haseebulhassan/Project-C/ReferenceMaterial/Test1.txt

NAme, test1
FRequencies, 320
OFfset,  6
ONset,  0
DUration, 65
PEriod, 0
NEgative, 0
UP, 0
inverse, 0
Voltage, 12~30
729331
730442
731553
732664
733775
734886
828108
829219
830330
831441
832552
833663
834774
835885
929107
930218
931329
932440
933551
934662
935773
936884
61529
62640
63751
64862
65973
67084
68195
69306
162529
163640
164751
165862
166973
168084
169195
170306
263529
264640
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
