haseebulhassan/Project-C/Project-C/Project-C_LED/Datasheet/JTAG.JPG

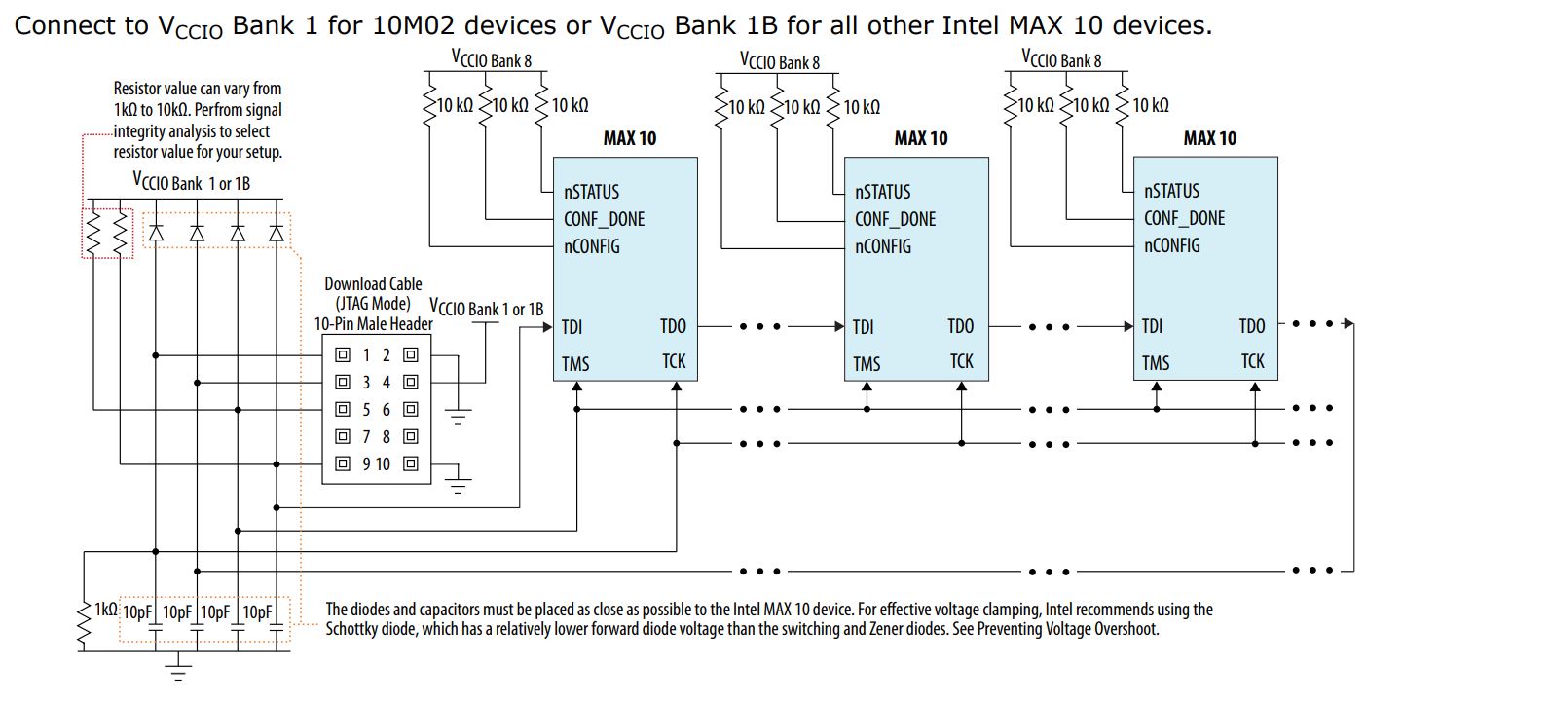
Project-C/Project-C_LED/Datasheet/JTAG.JPG
