haseebulhassan/Project-C/Project-C/Project-C_Controller/Project Outputs for Project-C_CONTOLLER/Project-C_CONTOLLER_BOM.xls

Comment | Description | Designator | Package | Mfr | Mfr Part No | Quantity
0.1uF/16V | Multilayer Ceramic Capacitors MLCC - SMD/SMT 0603 16VDC 0.1uF 10% X7R AEC-Q2000, Multilayer Ceramic Capacitors MLCC - SMD/SMT 0603 16VDC 0.1uF 10% X7R AEC-Q200 | C1, C2, C6, C7, C11, C15, C16, C17, C18, C19, C20, C21, C22, C23, C24, C29, C32, C35, C36, C42, C43, C55, C56, C85 | 0603 | Taiyo Yuden | EMK107B7104KAHT | 24.0
4.7uF/16V | Tantalum Capacitors - Solid SMD 16V 4.7uF 1206 | C3, C9, C40, C41 | 1206 | KEMET | T495A475K016ATA2K0 | 4.0
10pF/50V | Multilayer Ceramic Capacitors MLCC - SMD/SMT 50V 10pF 0603 C0G 5% AEC-Q200 | C4, C5, C76 | 0603 | KEMET | C0603C100J5GACAUTO | 3.0
0.01uF/16V | Multilayer Ceramic Capacitors MLCC - SMD/SMT 16V 0.01uF X7R 0603 10% AEC-Q200 | C8, C44 | 0603 | KEMET | C0603C103K4RECAUTO | 2.0
10uF/25V | Multilayer Ceramic Capacitors MLCC - SMD/SMT 0805 25VDC 10uF 20% X5R | C10, C14, C37 | 0805 | Taiyo Yuden | TMK212BBJ106MG-T | 3.0
1uF/16V | Multilayer Ceramic Capacitors MLCC - SMD/SMT 16volts 1uF X7R 10% | C12, C25, C31, C54 | 0603 | KEMET | C0603C105K4RAC7411 | 4.0
20pF/50V | Multilayer Ceramic Capacitors MLCC - SMD/SMT 50V 20pF 0603 C0G 5% AEC-Q200 | C13, C51, C52, C53 | 0603 | KEMET | C0603C200J5GACAUTO | 4.0
22uF/25V | Multilayer Ceramic Capacitors MLCC - SMD/SMT 1210 25VDC 22uF 20% X7R AEC-Q200 | C26, C30, C33, C34, C74, C75 | 1210 | Taiyo Yuden | TMK325B7226MMHP | 6.0
0.1uF/50V | Multilayer Ceramic Capacitors MLCC - SMD/SMT 50V 0.1uF 0603 X7R 20% | C27, C38_U_BOARD_CONNECTOR_1x_1, C38_U_BOARD_CONNECTOR_1x_2, C38_U_BOARD_CONNECTOR_1x_3, C38_U_BOARD_CONNECTOR_1x_4, C39_U_BOARD_CONNECTOR_1x_1, C39_U_BOARD_CONNECTOR_1x_2, C39_U_BOARD_CONNECTOR_1x_3, C39_U_BOARD_CONNECTOR_1x_4, C45_U_BOARD_CONNECTOR_1x_1, C45_U_BOARD_CONNECTOR_1x_2, C45_U_BOARD_CONNECTOR_1x_3, C45_U_BOARD_CONNECTOR_1x_4, C46_U_BOARD_CONNECTOR_1x_1, C46_U_BOARD_CONNECTOR_1x_2, C46_U_BOARD_CONNECTOR_1x_3, C46_U_BOARD_CONNECTOR_1x_4, C47_U_BOARD_CONNECTOR_1x_1, C47_U_BOARD_CONNECTOR_1x_2, C47_U_BOARD_CONNECTOR_1x_3, C47_U_BOARD_CONNECTOR_1x_4 | 0603 | KEMET | C0603C104M5RACTU | 21.0
1nF/63V | Multilayer Ceramic Capacitors MLCC - SMD/SMT 63V 1000pF 0603 X7R 10% AEC-Q200 | C28 | 0603 | KEMET | 80-C0603C102KMREAUTO | 1.0
2.2uF/50V | Multilayer Ceramic Capacitors MLCC - SMD/SMT 0603 2.2uF 20% 50VDC X5R | C48 | 0603 | Murata Electronics | GRM188R61H225ME11J | 1.0
10uF/63V | Polarized Capacitor (Radial) | C49 | SMD | Panasonic | EEE-FN1J100L | 1.0
47pF/100V | Multilayer Ceramic Capacitors MLCC - SMD/SMT 100V 47pF 0603 X8R 20% AEC-Q200 | C50, C63 | 0603 | KEMET | C0603C470M1HACAUTO | 2.0
6.8nF/50V | Multilayer Ceramic Capacitors MLCC - SMD/SMT 0603 50VDC 6.8nF 5% C0G AEC-Q200 | C73 | 0603 | TDK | CGA3E2C0G1H682J080AE | 1.0
4.7nF/50V | Multilayer Ceramic Capacitors MLCC - SMD/SMT 50V 4700pF X7R 0603 10% AEC-Q200 | C86 | 0603 | KEMET | C0603C472K5RACAUTO7411 | 1.0
1N4148 | Diodes - General Purpose, Power, Switching 400mW 100Vrrm 4ns | D1, D2 | SOD-123-2 | Diodes Incorporated | 1N4148W-13-F | 2.0
LEDR | Standard LEDs - SMD Red 631nm 14mcd 5mA | D3, D4, D5, D6, D7_U_BOARD_CONNECTOR_1x_1, D7_U_BOARD_CONNECTOR_1x_2, D7_U_BOARD_CONNECTOR_1x_3, D7_U_BOARD_CONNECTOR_1x_4, D8_U_BOARD_CONNECTOR_1x_1, D8_U_BOARD_CONNECTOR_1x_2, D8_U_BOARD_CONNECTOR_1x_3, D8_U_BOARD_CONNECTOR_1x_4, D9, D10 | 0603 | Lite On | LTST-C193KRKT-5A | 14.0
Mini USB | USB Connectors M-USB 1X1 B/REC R/A SMT | J1 |  | TE Connectivity | 1734035-2 | 1.0
PJ-002BH | Connector | J2 |  |  | PJ-002BH | 1.0
101 | Coin Cell Battery Holders 20mm coin cell HOLDER | J3 |  |  | 101 | 1.0
DM3AT-SF-PEJM5 | Memory Card Connectors R/A SMT MICROSD CON PUSH-PUSH TOP BRDMNT | J4 |  | Hirose Connector | DM3AT-SF-PEJM5 | 1.0
RJHSE-5381 | Modular Connectors / Ethernet Connectors R/A RJ45 SHEILDED 8 CONT Y/G LEDS | J5_U_BOARD_CONNECTOR_1x_1, J5_U_BOARD_CONNECTOR_1x_2, J5_U_BOARD_CONNECTOR_1x_3, J5_U_BOARD_CONNECTOR_1x_4, J6_U_BOARD_CONNECTOR_1x_1, J6_U_BOARD_CONNECTOR_1x_2, J6_U_BOARD_CONNECTOR_1x_3, J6_U_BOARD_CONNECTOR_1x_4 |  | Amphenol Commercial Products | RJHSE-5381 | 8.0
ER-CON40HB-2 | 40 Pin 1.0mm Pitch Bottom Contact ZIF Connector,FPC Connector | J7 |  |  |  | 1.0
100R,1A | Ferrite Beads 100ohms 1A 60mOhms 0603 Ferrite Chip | L2, L4 | 0603 | TDK | MPZ1608D101BTA00 | 2.0
2.2uH | Fixed Inductors 2.2uH 20% High Temp AEC-Q200 | L6 |  | Vishay / Dale | IHLP1616BZER2R2M5A | 1.0
LCD320X480 |  | LCD1 |  | Buy LCD | ER-TFTM035-6 | 1.0
Program | Header, 5-Pin, Dual row | P1 |  |  |  | 1.0
POWER |  | P2 |  |  |  | 1.0
Enable |  | P3 |  |  |  | 1.0
10K | Thick Film Resistors - SMD 0603 10Kohms 1% Anti-Sulfur AEC-Q200 | R1, R4, R5, R6, R7, R8, R10, R11, R12, R13, R14, R15, R16, R17, R20, R21, R25, R26, R27, R28_U_BOARD_CONNECTOR_1x_1, R28_U_BOARD_CONNECTOR_1x_2, R28_U_BOARD_CONNECTOR_1x_3, R28_U_BOARD_CONNECTOR_1x_4, R29_U_BOARD_CONNECTOR_1x_1, R29_U_BOARD_CONNECTOR_1x_2, R29_U_BOARD_CONNECTOR_1x_3, R29_U_BOARD_CONNECTOR_1x_4, R38, R43 | 0603 | ROHM Semiconductor | SFR03EZPF1002 | 29.0
1K | Resistor | R2, R3 | 0603 | Vishay / Dale | CRCW06031K00FKEAC | 2.0
0R | Thick Film Resistors - SMD 1/10Watt 0ohms Commercial Use | R9, R24 | 0603 | Vishay / Dale | CRCW06030000Z0EAC | 2.0
27R | Thick Film Resistors - SMD 0603 0.25W 1% 27ohm AEC-Q200 | R18, R19 | 0603 | Panasonic | ERJ-UP3F27R0V | 2.0
1M | Thick Film Resistors - SMD 0603 0.25W 1% 1Mohm AEC-Q200 | R22, R36 | 0603 | Panasonic | ERJ-UP3F1004V | 2.0
4.7K | Thick Film Resistors - SMD 1/10Watt 4.7Kohms 5% Commercial Use | R23 | 0603 | Vishay / Dale | CRCW06034K70JNEAC | 1.0
220R | Thick Film Resistors - SMD 1/10Watt 220ohms 5% Commercial Use | R30, R31, R32, R33, R34_U_BOARD_CONNECTOR_1x_1, R34_U_BOARD_CONNECTOR_1x_2, R34_U_BOARD_CONNECTOR_1x_3, R34_U_BOARD_CONNECTOR_1x_4, R35_U_BOARD_CONNECTOR_1x_1, R35_U_BOARD_CONNECTOR_1x_2, R35_U_BOARD_CONNECTOR_1x_3, R35_U_BOARD_CONNECTOR_1x_4, R37, R39 | 0603 | Vishay / Dale | CRCW0603220RJNEAC | 14.0
40.2K | Thick Film Resistors - SMD 0603 Anti-Surge Res. 0.1%, 40.2Koh | R44 | 0603 | Panasonic | ERJ-PB3B4022V | 1.0
7.68K | Thick Film Resistors - SMD 0603 Anti-Surge Res. 0.1%, 7.68Koh | R45 | 0603 | Panasonic | ERJ-PB3B7681V | 1.0
604K | Thick Film Resistors - SMD 0603 1% 604Kohm Anti-Sulfur AEC-Q200 | R52 | 0603 | Panasonic | ERJ-U03F6043V | 1.0
20R | Thick Film Resistors - SMD 0603 0.25W 1% 20ohm AEC-Q200 | R53 | 0603 | Panasonic | ERJ-UP3F20R0V | 1.0
MCP79400 | Real Time Clock I2C GP RTCC 64B SRAM ID | U1 |  | Microchip Technology | MCP79400-I/SN | 1.0
FT230XS-R | USB Interface IC USB to Basic Serial UART IC SSOP-16 | U2 |  | FTDI | FT230XS-R | 1.0
S25FL064LABMFI013 | NOR Flash Nor | U3 |  | Cypress Semiconductor | S25FL064LABMFI013 | 1.0
ADG708BRUZ | Multiplexer Switch ICs 8-CHANNEL MUX | U4, U8, U9, U10 |  | Analog Devices | ADG708BRUZ | 4.0
STM32F101RBT6 | ARM Microcontrollers - MCU 32BIT Cortex M3 128K 16KB RAM 1X12 ADC | U5 |  | STMicroelectronics | STM32F101RBT6 | 1.0
MP2333HGTL | Switching Voltage Regulators High-Efficiency, 3A, 18V, 1200kHz, Synchronous, Step-Down Converter | U6 |  | Monolithic Power Systems (MPS) | MP2333HGTL-P | 1.0
LD1085D2T33R | Integrated Circuit | U7 |  | STMicroelectronics | LD1085D2T33R | 1.0
TMCS1101A2BQDT | Board Mount Current Sensors Precision isolated current sensor with internal reference 8-SOIC -40 to 125 | U11 |  | Texas Instruments | TMCS1101A2BQDT | 1.0
ESP32-WROOM-32E_M113EH3200PH3Q0_ | Integrated Circuit | U12 |  | Espressif Systems | ESP32-WROOM-32E(M113EH3200PH3Q0) | 1.0
MAX3232CPWR | RS-232 Interface IC 3-5.5V Mult-Ch RS232 | U13_U_BOARD_CONNECTOR_1x_1, U13_U_BOARD_CONNECTOR_1x_2, U13_U_BOARD_CONNECTOR_1x_3, U13_U_BOARD_CONNECTOR_1x_4 |  | Texas Instruments | MAX3232CPWR | 4.0
AB26T-32.768KHZ-6 | Crystals 32.768KHz 6pF 32.768KHZ | X1 |  | ABRACON | AB26T-32.768KHZ-6 | 1.0
FC-135R 32.7680KA-AC | Crystals SMD XTL KHZ +/-20PPM,-40 85C 9.0PF BULK | X2 |  | Epson Timing | FC-135R 32.7680KA-AC | 1.0
ECS-080-20-5PX-TR | Crystals 8MHz 20pF -10C +70C | X3 |  | ECS | ECS-080-20-5PX-TR | 1.0
