haseebulhassan/Project-C/Project-C/Project-C_LED/Project Outputs for Project-C_LED/Project-C_LED_BOM.xls

Comment | Description | Designator | Package | Mfr | Mfr Part No | Quantity
0.1uF/16V | Multilayer Ceramic Capacitors MLCC - SMD/SMT 0603 16VDC 0.1uF 10% X7R AEC-Q200 | C1_IO1, C1_IO2, C1_IO3, C1_IO4, C4_POWER1, C4_POWER2, C4_POWER3, C4_POWER4, C5_POWER1, C5_POWER2, C5_POWER3, C5_POWER4, C6_POWER1, C6_POWER2, C6_POWER3, C6_POWER4, C9_POWER1, C9_POWER2, C9_POWER3, C9_POWER4, C12_POWER1, C12_POWER2, C12_POWER3, C12_POWER4, C13_POWER1, C13_POWER2, C13_POWER3, C13_POWER4, C15_POWER1, C15_POWER2, C15_POWER3, C15_POWER4, C16_POWER1, C16_POWER2, C16_POWER3, C16_POWER4, C17_POWER1, C17_POWER2, C17_POWER3, C17_POWER4, C23_POWER1, C23_POWER2, C23_POWER3, C23_POWER4, C24_POWER1, C24_POWER2, C24_POWER3, C24_POWER4, C28_U_LED_BUFFER11, C28_U_LED_BUFFER12, C28_U_LED_BUFFER13, C28_U_LED_BUFFER14, C28_U_LED_BUFFER21, C28_U_LED_BUFFER22, C28_U_LED_BUFFER23, C28_U_LED_BUFFER24, C28_U_LED_BUFFER31, C28_U_LED_BUFFER32, C28_U_LED_BUFFER33, C28_U_LED_BUFFER34, C28_U_LED_BUFFER41, C28_U_LED_BUFFER42, C28_U_LED_BUFFER43, C28_U_LED_BUFFER44, C28_U_LED_BUFFER51, C28_U_LED_BUFFER52, C28_U_LED_BUFFER53, C28_U_LED_BUFFER54, C28_U_LED_BUFFER61, C28_U_LED_BUFFER62, C28_U_LED_BUFFER63, C28_U_LED_BUFFER64, C28_U_LED_BUFFER71, C28_U_LED_BUFFER72, C28_U_LED_BUFFER73, C28_U_LED_BUFFER74, C28_U_LED_BUFFER81, C28_U_LED_BUFFER82, C28_U_LED_BUFFER83, C28_U_LED_BUFFER84, C28_U_LED_BUFFER91, C28_U_LED_BUFFER92, C28_U_LED_BUFFER93, C28_U_LED_BUFFER94, C28_U_LED_BUFFER101, C28_U_LED_BUFFER102, C28_U_LED_BUFFER103, C28_U_LED_BUFFER104, C31_U_LED_BUFFER11, C31_U_LED_BUFFER12, C31_U_LED_BUFFER13, C31_U_LED_BUFFER14, C31_U_LED_BUFFER21, C31_U_LED_BUFFER22, C31_U_LED_BUFFER23, C31_U_LED_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 | 0603 | Taiyo Yuden | EMK107B7104KAHT | 228.0
0.01uF/16V | Multilayer Ceramic Capacitors MLCC - SMD/SMT 16V 0.01uF X7R 0603 10% AEC-Q200 | C2_POWER1, C2_POWER2, C2_POWER3, C2_POWER4, C3_POWER1, C3_POWER2, C3_POWER3, C3_POWER4, C53_POWER1, C53_POWER2, C53_POWER3, C53_POWER4 | 0603 | KEMET | C0603C103K4RECAUTO | 12.0
0.47uF/16V | Multilayer Ceramic Capacitors MLCC - SMD/SMT 16V 0.47uF 0603 X7R 5% AEC-Q200 | C7_POWER1, C7_POWER2, C7_POWER3, C7_POWER4, C47_POWER1, C47_POWER2, C47_POWER3, C47_POWER4, C54_POWER1, C54_POWER2, C54_POWER3, C54_POWER4, C68_POWER1, C68_POWER2, C68_POWER3, C68_POWER4 | 0603 | KEMET | C0603C474J4RACAUTO | 16.0
10uF/25V | Multilayer Ceramic Capacitors MLCC - SMD/SMT 0805 25VDC 10uF 20% X5R | C10_POWER1, C10_POWER2, C10_POWER3, C10_POWER4, C46_POWER1, C46_POWER2, C46_POWER3, C46_POWER4, C55_POWER1, C55_POWER2, C55_POWER3, C55_POWER4, C69_POWER1, C69_POWER2, C69_POWER3, C69_POWER4, C70_POWER1, C70_POWER2, C70_POWER3, C70_POWER4 | 0805 | Taiyo Yuden | TMK212BBJ106MG-T | 20.0
22uF/10V | Multilayer Ceramic Capacitors MLCC - SMD/SMT 1210 25VDC 22uF 20% X7R AEC-Q200 | C11_POWER1, C11_POWER2, C11_POWER3, C11_POWER4, C56_POWER1, C56_POWER2, C56_POWER3, C56_POWER4, C71_POWER1, C71_POWER2, C71_POWER3, C71_POWER4, C72_POWER1, C72_POWER2, C72_POWER3, C72_POWER4 | 0603 | TDK | C1608X5R1A226M080AC | 16.0
1uF/16V | Multilayer Ceramic Capacitors MLCC - SMD/SMT 16volts 1uF X7R 10% | C18, C33_U_LED_BUFFER11, C33_U_LED_BUFFER12, C33_U_LED_BUFFER13, C33_U_LED_BUFFER14, C33_U_LED_BUFFER21, C33_U_LED_BUFFER22, C33_U_LED_BUFFER23, C33_U_LED_BUFFER24, C33_U_LED_BUFFER31, C33_U_LED_BUFFER32, C33_U_LED_BUFFER33, C33_U_LED_BUFFER34, C33_U_LED_BUFFER41, C33_U_LED_BUFFER42, C33_U_LED_BUFFER43, C33_U_LED_BUFFER44, C33_U_LED_BUFFER51, C33_U_LED_BUFFER52, C33_U_LED_BUFFER53, C33_U_LED_BUFFER54, C33_U_LED_BUFFER61, C33_U_LED_BUFFER62, C33_U_LED_BUFFER63, C33_U_LED_BUFFER64, C33_U_LED_BUFFER71, C33_U_LED_BUFFER72, C33_U_LED_BUFFER73, C33_U_LED_BUFFER74, C33_U_LED_BUFFER81, C33_U_LED_BUFFER82, C33_U_LED_BUFFER83, C33_U_LED_BUFFER84, C33_U_LED_BUFFER91, C33_U_LED_BUFFER92, C33_U_LED_BUFFER93, C33_U_LED_BUFFER94, C33_U_LED_BUFFER101, C33_U_LED_BUFFER102, C33_U_LED_BUFFER103, C33_U_LED_BUFFER104, C34_U_LED_BUFFER11, C34_U_LED_BUFFER12, C34_U_LED_BUFFER13, C34_U_LED_BUFFER14, C34_U_LED_BUFFER21, C34_U_LED_BUFFER22, C34_U_LED_BUFFER23, C34_U_LED_BUFFER24, C34_U_LED_BUFFER31, C34_U_LED_BUFFER32, C34_U_LED_BUFFER33, C34_U_LED_BUFFER34, C34_U_LED_BUFFER41, C34_U_LED_BUFFER42, C34_U_LED_BUFFER43, C34_U_LED_BUFFER44, C34_U_LED_BUFFER51, C34_U_LED_BUFFER52, C34_U_LED_BUFFER53, C34_U_LED_BUFFER54, C34_U_LED_BUFFER61, C34_U_LED_BUFFER62, C34_U_LED_BUFFER63, C34_U_LED_BUFFER64, C34_U_LED_BUFFER71, C34_U_LED_BUFFER72, C34_U_LED_BUFFER73, C34_U_LED_BUFFER74, C34_U_LED_BUFFER81, C34_U_LED_BUFFER82, C34_U_LED_BUFFER83, C34_U_LED_BUFFER84, C34_U_LED_BUFFER91, C34_U_LED_BUFFER92, C34_U_LED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 | 0603 | KEMET | C0603C105K4RAC7411, C0603C105K4RACTU | 121.0
22uF/25V | Multilayer Ceramic Capacitors MLCC - SMD/SMT 1210 25VDC 22uF 20% X7R AEC-Q200 | C19, C26, C27, C29, C30 | 1210 | Taiyo Yuden | TMK325B7226MMHP | 5.0
0.1uF/50V | Multilayer Ceramic Capacitors MLCC - SMD/SMT 50V 0.1uF 0603 X7R 20% | C20, C40, C41, C42, C43, C44 | 0603 | KEMET | C0603C104M5RACTU | 6.0
1nF/63V | Multilayer Ceramic Capacitors MLCC - SMD/SMT 63V 1000pF 0603 X7R 10% AEC-Q200 | C21 | 0603 | KEMET | 80-C0603C102KMREAUTO | 1.0
6.8nF/50V | Multilayer Ceramic Capacitors MLCC - SMD/SMT 0603 50VDC 6.8nF 5% C0G AEC-Q200 | C22 | 0603 | TDK | CGA3E2C0G1H682J080AE | 1.0
10pF/50V | Multilayer Ceramic Capacitors MLCC - SMD/SMT 50V 10pF 0603 C0G 5% AEC-Q200 | C25, C36, C37, C38, C39 | 0603 | KEMET | C0603C100J5GACAUTO | 5.0
10uF/63V | Polarized Capacitor (Radial) | C73, C76, C79 | SMD | Panasonic | EEE-FN1J100L | 3.0
2.2uF/50V | Multilayer Ceramic Capacitors MLCC - SMD/SMT 0603 2.2uF 20% 50VDC X5R | C74, C75, C77, C78 | 0603 | Murata Electronics | GRM188R61H225ME11J | 4.0
LEDR | Standard LEDs - SMD Red 631nm 14mcd 5mA | D1_IO1, D1_IO2, D1_IO3, D1_IO4, D2_IO1, D2_IO2, D2_IO3, D2_IO4, D3 | 0603 | Lite-On | LTST-C193KRKT-5A | 9.0
V8PAM10S-M3_H | Schottky Diodes & Rectifiers 8A 100V | D4, D5, D6 |  | Vishay General Semiconductor | V8PAM10S-M3/H | 3.0
LEDG | Standard LEDs - SMD Grn 527nm; 140mcd 0603; 70mW | D7_U_LED_BUFFER11, D7_U_LED_BUFFER12, D7_U_LED_BUFFER13, D7_U_LED_BUFFER14, D7_U_LED_BUFFER21, D7_U_LED_BUFFER22, D7_U_LED_BUFFER23, D7_U_LED_BUFFER24, D7_U_LED_BUFFER31, D7_U_LED_BUFFER32, D7_U_LED_BUFFER33, D7_U_LED_BUFFER34, D7_U_LED_BUFFER41, D7_U_LED_BUFFER42, D7_U_LED_BUFFER43, D7_U_LED_BUFFER44, D7_U_LED_BUFFER51, D7_U_LED_BUFFER52, D7_U_LED_BUFFER53, D7_U_LED_BUFFER54, D7_U_LED_BUFFER61, D7_U_LED_BUFFER62, D7_U_LED_BUFFER63, D7_U_LED_BUFFER64, D7_U_LED_BUFFER71, D7_U_LED_BUFFER72, D7_U_LED_BUFFER73, D7_U_LED_BUFFER74, D7_U_LED_BUFFER81, D7_U_LED_BUFFER82, D7_U_LED_BUFFER83, D7_U_LED_BUFFER84, D7_U_LED_BUFFER91, D7_U_LED_BUFFER92, D7_U_LED_BUFFER93, D7_U_LED_BUFFER94, D7_U_LED_BUFFER101, D7_U_LED_BUFFER102, D7_U_LED_BUFFER103, D7_U_LED_BUFFER104, D8_U_LED_BUFFER11, D8_U_LED_BUFFER12, D8_U_LED_BUFFER13, D8_U_LED_BUFFER14, D8_U_LED_BUFFER21, D8_U_LED_BUFFER22, D8_U_LED_BUFFER23, D8_U_LED_BUFFER24, D8_U_LED_BUFFER31, D8_U_LED_BUFFER32, D8_U_LED_BUFFER33, D8_U_LED_BUFFER34, D8_U_LED_BUFFER41, D8_U_LED_BUFFER42, D8_U_LED_BUFFER43, D8_U_LED_BUFFER44, D8_U_LED_BUFFER51, D8_U_LED_BUFFER52, D8_U_LED_BUFFER53, D8_U_LED_BUFFER54, D8_U_LED_BUFFER61, D8_U_LED_BUFFER62, D8_U_LED_BUFFER63, D8_U_LED_BUFFER64, D8_U_LED_BUFFER71, D8_U_LED_BUFFER72, D8_U_LED_BUFFER73, D8_U_LED_BUFFER74, D8_U_LED_BUFFER81, D8_U_LED_BUFFER82, D8_U_LED_BUFFER83, D8_U_LED_BUFFER84, D8_U_LED_BUFFER91, D8_U_LED_BUFFER92, D8_U_LED_BUFFER93, D8_U_LED_BUFFER94, D8_U_LED_BUFFER101, D8_U_LED_BUFFER102, D8_U_LED_B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 | 0603 | ROHM Semiconductor | SMLD12EN1WT86 | 320.0
RJHSE-5381 | Modular Connectors / Ethernet Connectors R/A RJ45 SHEILDED 8 CONT Y/G LEDS | J1 |  | Amphenol Commercial Products | RJHSE-5381 | 1.0
PJ-002BH | DC Power Connectors Power Jacks | J2 |  | CUI Devices | PJ-002BH | 1.0
100R,1A | Ferrite Beads 100ohms 1A 60mOhms 0603 Ferrite Chip | L1_POWER1, L1_POWER2, L1_POWER3, L1_POWER4, L3_POWER1, L3_POWER2, L3_POWER3, L3_POWER4 | 0603 | TDK | MPZ1608D101BTA00 | 8.0
2.2uH | Fixed Inductors 2.2uH 20% High Temp AEC-Q200 | L4 |  | Vishay / Dale | IHLP1616BZER2R2M5A | 1.0
10M04SC E144 | FPGA - Field Programmable Gate Array non-volatile FPGA, 101 I/O, 144EQFP | P1_IO1, P1_IO2, P1_IO3, P1_IO4 | EQFP144 | Intel / Altera | 10M04SCE144C8G | 4.0
10K | Thick Film Resistors - SMD 0603 10Kohms 1% Anti-Sulfur AEC-Q200 | R1_IO1, R1_IO2, R1_IO3, R1_IO4, R2_IO1, R2_IO2, R2_IO3, R2_IO4, R3_IO1, R3_IO2, R3_IO3, R3_IO4, R4_IO1, R4_IO2, R4_IO3, R4_IO4, R5_IO1, R5_IO2, R5_IO3, R5_IO4, R6_IO1, R6_IO2, R6_IO3, R6_IO4, R7_IO1, R7_IO2, R7_IO3, R7_IO4, R10, R11, R23, R24, R25, R28, R30, R31, R32, R33, R34, R44 | 0603 | ROHM Semiconductor | SFR03EZPF1002 | 40.0
220R | Thick Film Resistors - SMD 1/10Watt 220ohms 5% Commercial Use | R8_IO1, R8_IO2, R8_IO3, R8_IO4, R21_IO1, R21_IO2, R21_IO3, R21_IO4 | 0603 | Vishay / Dale | CRCW0603220RJNEAC | 8.0
330R | Thick Film Resistors - SMD 1/10Watt 330ohms 1% Commercial Use | R9_U_LED_BUFFER11, R9_U_LED_BUFFER12, R9_U_LED_BUFFER13, R9_U_LED_BUFFER14, R9_U_LED_BUFFER21, R9_U_LED_BUFFER22, R9_U_LED_BUFFER23, R9_U_LED_BUFFER24, R9_U_LED_BUFFER31, R9_U_LED_BUFFER32, R9_U_LED_BUFFER33, R9_U_LED_BUFFER34, R9_U_LED_BUFFER41, R9_U_LED_BUFFER42, R9_U_LED_BUFFER43, R9_U_LED_BUFFER44, R9_U_LED_BUFFER51, R9_U_LED_BUFFER52, R9_U_LED_BUFFER53, R9_U_LED_BUFFER54, R9_U_LED_BUFFER61, R9_U_LED_BUFFER62, R9_U_LED_BUFFER63, R9_U_LED_BUFFER64, R9_U_LED_BUFFER71, R9_U_LED_BUFFER72, R9_U_LED_BUFFER73, R9_U_LED_BUFFER74, R9_U_LED_BUFFER81, R9_U_LED_BUFFER82, R9_U_LED_BUFFER83, R9_U_LED_BUFFER84, R9_U_LED_BUFFER91, R9_U_LED_BUFFER92, R9_U_LED_BUFFER93, R9_U_LED_BUFFER94, R9_U_LED_BUFFER101, R9_U_LED_BUFFER102, R9_U_LED_BUFFER103, R9_U_LED_BUFFER104, R17_U_LED_BUFFER11, R17_U_LED_BUFFER12, R17_U_LED_BUFFER13, R17_U_LED_BUFFER14, R17_U_LED_BUFFER21, R17_U_LED_BUFFER22, R17_U_LED_BUFFER23, R17_U_LED_BUFFER24, R17_U_LED_BUFFER31, R17_U_LED_BUFFER32, R17_U_LED_BUFFER33, R17_U_LED_BUFFER34, R17_U_LED_BUFFER41, R17_U_LED_BUFFER42, R17_U_LED_BUFFER43, R17_U_LED_BUFFER44, R17_U_LED_BUFFER51, R17_U_LED_BUFFER52, R17_U_LED_BUFFER53, R17_U_LED_BUFFER54, R17_U_LED_BUFFER61, R17_U_LED_BUFFER62, R17_U_LED_BUFFER63, R17_U_LED_BUFFER64, R17_U_LED_BUFFER71, R17_U_LED_BUFFER72, R17_U_LED_BUFFER73, R17_U_LED_BUFFER74, R17_U_LED_BUFFER81, R17_U_LED_BUFFER82, R17_U_LED_BUFFER83, R17_U_LED_BUFFER84, R17_U_LED_BUFFER91, R17_U_LED_BUFFER92, R17_U_LED_BUFFER93, R17_U_LED_BUFFER94, R17_U_LED_BUFF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 | 0603 | Vishay / Dale | CRCW0603330RFKEAC | 320.0
1K | Resistor | R12, R13_IO1, R13_IO2, R13_IO3, R13_IO4, R38, R43 | 0603 | Vishay / Dale | CRCW06031K00FKEAC | 7.0
4.7K | Thick Film Resistors - SMD 1/10Watt 4.7Kohms 5% Commercial Use | R14_IO1, R14_IO2, R14_IO3, R14_IO4, R20_IO1, R20_IO2, R20_IO3, R20_IO4 | 0603 | Vishay / Dale | CRCW06034K70JNEAC | 8.0
604K | Thick Film Resistors - SMD 0603 1% 604Kohm Anti-Sulfur AEC-Q200 | R15 | 0603 | Panasonic | ERJ-U03F6043V | 1.0
20R | Thick Film Resistors - SMD 0603 0.25W 1% 20ohm AEC-Q200 | R16 | 0603 | Panasonic | ERJ-UP3F20R0V | 1.0
40.2K | Thick Film Resistors - SMD 0603 Anti-Surge Res. 0.1%, 40.2Koh | R18, R36, R42 | 0603 | Panasonic | ERJ-PB3B4022V | 3.0
7.68K | Thick Film Resistors - SMD 0603 Anti-Surge Res. 0.1%, 7.68Koh | R29 | 0603 | Panasonic | ERJ-PB3B7681V | 1.0
13K | Thin Film Resistors - SMD 13K ohm 0.1% 25 ppm | R35, R39, R41 | 0603 | KOA Speer | RN73R1JTTD1302B25 | 3.0
2K | Thick Film Resistors - SMD 0603 10Kohms 1% Anti-Sulfur AEC-Q200 | R37 | 0603 | ROHM Semiconductor | SFR03EZPF1002 | 1.0
20K | Thick Film Resistors - SMD 20K OHM .1% 25PPM | R40 | 0603 | KOA Speer | RS73F1JTTD2002B | 1.0
33R | Thick Film Resistors - SMD 1/10Watt 33ohms 1% Commercial Use | R47_U_LED_BUFFER11, R47_U_LED_BUFFER12, R47_U_LED_BUFFER13, R47_U_LED_BUFFER14, R47_U_LED_BUFFER21, R47_U_LED_BUFFER22, R47_U_LED_BUFFER23, R47_U_LED_BUFFER24, R47_U_LED_BUFFER31, R47_U_LED_BUFFER32, R47_U_LED_BUFFER33, R47_U_LED_BUFFER34, R47_U_LED_BUFFER41, R47_U_LED_BUFFER42, R47_U_LED_BUFFER43, R47_U_LED_BUFFER44, R47_U_LED_BUFFER51, R47_U_LED_BUFFER52, R47_U_LED_BUFFER53, R47_U_LED_BUFFER54, R47_U_LED_BUFFER61, R47_U_LED_BUFFER62, R47_U_LED_BUFFER63, R47_U_LED_BUFFER64, R47_U_LED_BUFFER71, R47_U_LED_BUFFER72, R47_U_LED_BUFFER73, R47_U_LED_BUFFER74, R47_U_LED_BUFFER81, R47_U_LED_BUFFER82, R47_U_LED_BUFFER83, R47_U_LED_BUFFER84, R47_U_LED_BUFFER91, R47_U_LED_BUFFER92, R47_U_LED_BUFFER93, R47_U_LED_BUFFER94, R47_U_LED_BUFFER101, R47_U_LED_BUFFER102, R47_U_LED_BUFFER103, R47_U_LED_BUFFER104, R48_U_LED_BUFFER11, R48_U_LED_BUFFER12, R48_U_LED_BUFFER13, R48_U_LED_BUFFER14, R48_U_LED_BUFFER21, R48_U_LED_BUFFER22, R48_U_LED_BUFFER23, R48_U_LED_BUFFER24, R48_U_LED_BUFFER31, R48_U_LED_BUFFER32, R48_U_LED_BUFFER33, R48_U_LED_BUFFER34, R48_U_LED_BUFFER41, R48_U_LED_BUFFER42, R48_U_LED_BUFFER43, R48_U_LED_BUFFER44, R48_U_LED_BUFFER51, R48_U_LED_BUFFER52, R48_U_LED_BUFFER53, R48_U_LED_BUFFER54, R48_U_LED_BUFFER61, R48_U_LED_BUFFER62, R48_U_LED_BUFFER63, R48_U_LED_BUFFER64, R48_U_LED_BUFFER71, R48_U_LED_BUFFER72, R48_U_LED_BUFFER73, R48_U_LED_BUFFER74, R48_U_LED_BUFFER81, R48_U_LED_BUFFER82, R48_U_LED_BUFFER83, R48_U_LED_BUFFER84, R48_U_LED_BUFFER91, R48_U_LED_BUFFER92, R48_U_LED_BUFF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 | 0603 | Vishay / Dale | CRCW060333R0FKEAC | 320.0
OSC-25 | Standard Clock Oscillators 25.0 MHZ 3.3V 50PPM SMD 32 | U1_IO1, U1_IO2, U1_IO3, U1_IO4 |  | ABRACON | ASE-25.000MHZ-LC-T | 4.0
MAX3232CPWR | RS-232 Interface IC 3-5.5V Mult-Ch RS232 | U2 |  | Texas Instruments | MAX3232CPWR | 1.0
MP2333HGTL | Switching Voltage Regulators High-Efficiency, 3A, 18V, 1200kHz, Synchronous, Step-Down Converter | U3 |  | Monolithic Power Systems (MPS) | MP2333HGTL-P | 1.0
NTS0308 | Translation - Voltage Levels Dual supply translating transceiver; open drain; auto direction sensing | U4_U_LED_BUFFER11, U4_U_LED_BUFFER12, U4_U_LED_BUFFER13, U4_U_LED_BUFFER14, U4_U_LED_BUFFER21, U4_U_LED_BUFFER22, U4_U_LED_BUFFER23, U4_U_LED_BUFFER24, U4_U_LED_BUFFER31, U4_U_LED_BUFFER32, U4_U_LED_BUFFER33, U4_U_LED_BUFFER34, U4_U_LED_BUFFER41, U4_U_LED_BUFFER42, U4_U_LED_BUFFER43, U4_U_LED_BUFFER44, U4_U_LED_BUFFER51, U4_U_LED_BUFFER52, U4_U_LED_BUFFER53, U4_U_LED_BUFFER54, U4_U_LED_BUFFER61, U4_U_LED_BUFFER62, U4_U_LED_BUFFER63, U4_U_LED_BUFFER64, U4_U_LED_BUFFER71, U4_U_LED_BUFFER72, U4_U_LED_BUFFER73, U4_U_LED_BUFFER74, U4_U_LED_BUFFER81, U4_U_LED_BUFFER82, U4_U_LED_BUFFER83, U4_U_LED_BUFFER84, U4_U_LED_BUFFER91, U4_U_LED_BUFFER92, U4_U_LED_BUFFER93, U4_U_LED_BUFFER94, U4_U_LED_BUFFER101, U4_U_LED_BUFFER102, U4_U_LED_BUFFER103, U4_U_LED_BUFFER104 |  | NXP Semiconductors | NTS0308EPWJ | 40.0
TPS2121 | Power Switch ICs - Power Distribution | U5 |  | Texas Instruments | TPS2121RUXT | 1.0
LD1085D2T33R | Integrated Circuit | U6 |  | STMicroelectronics | LD1085D2T33R | 1.0
74LV540APWJ | Buffers & Line Drivers BUFFER LINE DRIVER | U7_U_LED_BUFFER11, U7_U_LED_BUFFER12, U7_U_LED_BUFFER13, U7_U_LED_BUFFER14, U7_U_LED_BUFFER21, U7_U_LED_BUFFER22, U7_U_LED_BUFFER23, U7_U_LED_BUFFER24, U7_U_LED_BUFFER31, U7_U_LED_BUFFER32, U7_U_LED_BUFFER33, U7_U_LED_BUFFER34, U7_U_LED_BUFFER41, U7_U_LED_BUFFER42, U7_U_LED_BUFFER43, U7_U_LED_BUFFER44, U7_U_LED_BUFFER51, U7_U_LED_BUFFER52, U7_U_LED_BUFFER53, U7_U_LED_BUFFER54, U7_U_LED_BUFFER61, U7_U_LED_BUFFER62, U7_U_LED_BUFFER63, U7_U_LED_BUFFER64, U7_U_LED_BUFFER71, U7_U_LED_BUFFER72, U7_U_LED_BUFFER73, U7_U_LED_BUFFER74, U7_U_LED_BUFFER81, U7_U_LED_BUFFER82, U7_U_LED_BUFFER83, U7_U_LED_BUFFER84, U7_U_LED_BUFFER91, U7_U_LED_BUFFER92, U7_U_LED_BUFFER93, U7_U_LED_BUFFER94, U7_U_LED_BUFFER101, U7_U_LED_BUFFER102, U7_U_LED_BUFFER103, U7_U_LED_BUFFER104 | TSSOP-20 | Nexperia | 74LV540APWJ | 40.0
NUP4114 | ESD Suppressors / TVS Diodes LOW CAP TVS ARRAY 5.5V | U8 |  | ON SEMI | NUP4114HMR6T1G | 1.0
74HC151DB,118 | Encoders, Decoders, Multiplexers & Demultiplexers 8-INPUT MULTIPLEXER | U14 |  | NEXPERIA | 74HC151DB,118 | 1.0
