haseebulhassan/Project-C/Project-C/Project-C_Voltage/Project Outputs for Project-C_VOLTAGE/VOLTAGE_BOM.xls

Comment | Description | Designator | Package | Mfr | Mfr Part No | Quantity
180K | Thin Film Resistors - SMD 180K ohm 0.1% 50 ppm | R45 | 0603 | KOA Speer | RN73R1JTTD1803B50 | 1.0
50.5K | Thin Film Resistors - SMD 50.5kOhm,0603,0.1%,2 5ppm,63mW,50V | R9 | 0603 | KOA Speer | RN731JTTD5052B25 | 1.0
13K | Thin Film Resistors - SMD 13K ohm 0.1% 25 ppm | R35, R39, R41, R46 | 0603 | KOA Speer | RN73R1JTTD1302B25 | 4.0
40.2K | Thick Film Resistors - SMD 0603 Anti-Surge Res. 0.1%, 40.2Koh | R18, R36, R42 | 0603 | Panasonic | ERJ-PB3B4022V | 3.0
7.68K | Thick Film Resistors - SMD 0603 Anti-Surge Res. 0.1%, 7.68Koh | R19 | 0603 | Panasonic | ERJ-PB3B7681V | 1.0
86.6K | Thick Film Resistors - SMD 0603 86.6Kohms 1% AEC-Q200 | R48 | 0603 | Panasonic | ERJ-3EKF8662V | 1.0
2K | Thick Film Resistors - SMD 0603 10Kohms 1% Anti-Sulfur AEC-Q200 | R37 | 0603 | ROHM Semiconductor | SFR03EZPF1002 | 1.0
10K | Thick Film Resistors - SMD 0603 10Kohms 1% Anti-Sulfur AEC-Q200 | R1_IO1, R1_IO2, R1_IO3, R1_IO4, R2_IO1, R2_IO2, R2_IO3, R2_IO4, R3_IO1, R3_IO2, R3_IO3, R3_IO4, R4_IO1, R4_IO2, R4_IO3, R4_IO4, R5_IO1, R5_IO2, R5_IO3, R5_IO4, R6_IO1, R6_IO2, R6_IO3, R6_IO4, R7_IO1, R7_IO2, R7_IO3, R7_IO4, R10, R11, R17, R22, R23, R24, R25, R30, R31, R32, R33, R34, R44 | 0603 | ROHM Semiconductor | SFR03EZPF1002 | 41.0
5.23K | Thick Film Resistors - SMD 0603 5.23Kohms 1% AEC-Q200 | R47 | 0603 | Panasonic | ERJ-3EKF5231V | 1.0
604K | Thick Film Resistors - SMD 0603 1% 604Kohm Anti-Sulfur AEC-Q200 | R15 | 0603 | Panasonic | ERJ-U03F6043V | 1.0
20R | Thick Film Resistors - SMD 0603 0.25W 1% 20ohm AEC-Q200 | R16 | 0603 | Panasonic | ERJ-UP3F20R0V | 1.0
20K | Thick Film Resistors - SMD 20K OHM .1% 25PPM | R40 | 0603 | KOA Speer | RS73F1JTTD2002B | 1.0
220R | Thick Film Resistors - SMD 1/10Watt 220ohms 5% Commercial Use | R8_IO1, R8_IO2, R8_IO3, R8_IO4, R21_IO1, R21_IO2, R21_IO3, R21_IO4 | 0603 | Vishay / Dale | CRCW0603220RJNEAC | 8.0
4.7K | Thick Film Resistors - SMD 1/10Watt 4.7Kohms 5% Commercial Use | R14_IO1, R14_IO2, R14_IO3, R14_IO4, R20_IO1, R20_IO2, R20_IO3, R20_IO4 | 0603 | Vishay / Dale | CRCW06034K70JNEAC | 8.0
160R | Thick Film Resistors - SMD 1/10watt 160ohms 1% | R27_U_VoltageAmplifier11, R27_U_VoltageAmplifier12, R27_U_VoltageAmplifier13, R27_U_VoltageAmplifier14, R27_U_VoltageAmplifier21, R27_U_VoltageAmplifier22, R27_U_VoltageAmplifier23, R27_U_VoltageAmplifier24, R27_U_VoltageAmplifier31, R27_U_VoltageAmplifier32, R27_U_VoltageAmplifier33, R27_U_VoltageAmplifier34, R27_U_VoltageAmplifier41, R27_U_VoltageAmplifier42, R27_U_VoltageAmplifier43, R27_U_VoltageAmplifier44, R27_U_VoltageAmplifier51, R27_U_VoltageAmplifier52, R27_U_VoltageAmplifier53, R27_U_VoltageAmplifier54, R27_U_VoltageAmplifier61, R27_U_VoltageAmplifier62, R27_U_VoltageAmplifier63, R27_U_VoltageAmplifier64, R27_U_VoltageAmplifier71, R27_U_VoltageAmplifier72, R27_U_VoltageAmplifier73, R27_U_VoltageAmplifier74, R27_U_VoltageAmplifier81, R27_U_VoltageAmplifier82, R27_U_VoltageAmplifier83, R27_U_VoltageAmplifier84, R27_U_VoltageAmplifier91, R27_U_VoltageAmplifier92, R27_U_VoltageAmplifier93, R27_U_VoltageAmplifier94, R27_U_VoltageAmplifier101, R27_U_VoltageAmplifier102, R27_U_VoltageAmplifier103, R27_U_VoltageAmplifier104, R27_U_VoltageAmplifier111, R27_U_VoltageAmplifier112, R27_U_VoltageAmplifier113, R27_U_VoltageAmplifier114, R27_U_VoltageAmplifier121, R27_U_VoltageAmplifier122, R27_U_VoltageAmplifier123, R27_U_VoltageAmplifier124, R27_U_VoltageAmplifier131, R27_U_VoltageAmplifier132, R27_U_VoltageAmplifier133, R27_U_VoltageAmplifier134, R27_U_VoltageAmplifier141, R27_U_VoltageAmplifier142, R27_U_VoltageAmplifier143, R27_U_VoltageAmplifier144, R27_U_VoltageAmplifier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 | 0603 | Vishay / Dale | CRCW0603160RFKEA | 304.0
MP2333HGTL | Switching Voltage Regulators High-Efficiency, 3A, 18V, 1200kHz, Synchronous, Step-Down Converter | U3 |  | Monolithic Power Systems (MPS) | MP2333HGTL-P | 1.0
TPS61175PWPR | Switching Voltage Regulators 3A High Vltg Boost Converter | U15 |  | Texas Instruments | TPS61175PWPR | 1.0
LEDR | Standard LEDs - SMD Red 631nm 14mcd 5mA | D1_IO1, D1_IO2, D1_IO3, D1_IO4, D2_IO1, D2_IO2, D2_IO3, D2_IO4, D3 | 0603 | Lite-On | LTST-C193KRKT-5A | 9.0
OSC-25 | Standard Clock Oscillators 25.0 MHZ 3.3V 50PPM SMD 32 | U1_IO1, U1_IO2, U1_IO3, U1_IO4 |  | ABRACON | ASE-25.000MHZ-LC-T | 4.0
V8PAM10S-M3_H | Schottky Diodes & Rectifiers 8A 100V | D4, D5, D6, D7 |  | Vishay General Semiconductor | V8PAM10S-M3/H | 4.0
MAX3232CPWR | RS-232 Interface IC 3-5.5V Mult-Ch RS232 | U2 |  | Texas Instruments | MAX3232CPWR | 1.0
1K | Resistor | R12, R13_IO1, R13_IO2, R13_IO3, R13_IO4, R26_U_VoltageAmplifier11, R26_U_VoltageAmplifier12, R26_U_VoltageAmplifier13, R26_U_VoltageAmplifier14, R26_U_VoltageAmplifier21, R26_U_VoltageAmplifier22, R26_U_VoltageAmplifier23, R26_U_VoltageAmplifier24, R26_U_VoltageAmplifier31, R26_U_VoltageAmplifier32, R26_U_VoltageAmplifier33, R26_U_VoltageAmplifier34, R26_U_VoltageAmplifier41, R26_U_VoltageAmplifier42, R26_U_VoltageAmplifier43, R26_U_VoltageAmplifier44, R26_U_VoltageAmplifier51, R26_U_VoltageAmplifier52, R26_U_VoltageAmplifier53, R26_U_VoltageAmplifier54, R26_U_VoltageAmplifier61, R26_U_VoltageAmplifier62, R26_U_VoltageAmplifier63, R26_U_VoltageAmplifier64, R26_U_VoltageAmplifier71, R26_U_VoltageAmplifier72, R26_U_VoltageAmplifier73, R26_U_VoltageAmplifier74, R26_U_VoltageAmplifier81, R26_U_VoltageAmplifier82, R26_U_VoltageAmplifier83, R26_U_VoltageAmplifier84, R26_U_VoltageAmplifier91, R26_U_VoltageAmplifier92, R26_U_VoltageAmplifier93, R26_U_VoltageAmplifier94, R26_U_VoltageAmplifier101, R26_U_VoltageAmplifier102, R26_U_VoltageAmplifier103, R26_U_VoltageAmplifier104, R26_U_VoltageAmplifier111, R26_U_VoltageAmplifier112, R26_U_VoltageAmplifier113, R26_U_VoltageAmplifier114, R26_U_VoltageAmplifier121, R26_U_VoltageAmplifier122, R26_U_VoltageAmplifier123, R26_U_VoltageAmplifier124, R26_U_VoltageAmplifier131, R26_U_VoltageAmplifier132, R26_U_VoltageAmplifier133, R26_U_VoltageAmplifier134, R26_U_VoltageAmplifier141, R26_U_VoltageAmplifier142, R26_U_VoltageAmplifier143, R26_U_Vo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 | 0603 | Vishay / Dale | CRCW06031K00FKEAC | 312.0
TPS2121 | Power Switch ICs - Power Distribution | U5 |  | Texas Instruments | TPS2121RUXT | 1.0
10uF/63V | Polarized Capacitor (Radial) | C33, C73, C76, C79 | SMD | Panasonic | EEE-FN1J100L | 4.0
22uF/10V | Multilayer Ceramic Capacitors MLCC - SMD/SMT 1210 25VDC 22uF 20% X7R AEC-Q200 | C11_POWER1, C11_POWER2, C11_POWER3, C11_POWER4, C56_POWER1, C56_POWER2, C56_POWER3, C56_POWER4, C71_POWER1, C71_POWER2, C71_POWER3, C71_POWER4, C72_POWER1, C72_POWER2, C72_POWER3, C72_POWER4 | 0603 | TDK | C1608X5R1A226M080AC | 16.0
22uF/25V | Multilayer Ceramic Capacitors MLCC - SMD/SMT 1210 25VDC 22uF 20% X7R AEC-Q200 | C8, C14, C19, C26, C27, C29 | 1210 | Taiyo Yuden | TMK325B7226MMHP | 6.0
10uF/25V | Multilayer Ceramic Capacitors MLCC - SMD/SMT 0805 25VDC 10uF 20% X5R | C10_POWER1, C10_POWER2, C10_POWER3, C10_POWER4, C28, C46_POWER1, C46_POWER2, C46_POWER3, C46_POWER4, C55_POWER1, C55_POWER2, C55_POWER3, C55_POWER4, C69_POWER1, C69_POWER2, C69_POWER3, C69_POWER4, C70_POWER1, C70_POWER2, C70_POWER3, C70_POWER4 | 0805 | Taiyo Yuden | TMK212BBJ106MG-T | 21.0
6.8nF/50V | Multilayer Ceramic Capacitors MLCC - SMD/SMT 0603 50VDC 6.8nF 5% C0G AEC-Q200 | C22 | 0603 | TDK | CGA3E2C0G1H682J080AE | 1.0
0.1uF/16V | Multilayer Ceramic Capacitors MLCC - SMD/SMT 0603 16VDC 0.1uF 10% X7R AEC-Q200 | C1_IO1, C1_IO2, C1_IO3, C1_IO4, C4_POWER1, C4_POWER2, C4_POWER3, C4_POWER4, C5_POWER1, C5_POWER2, C5_POWER3, C5_POWER4, C6_POWER1, C6_POWER2, C6_POWER3, C6_POWER4, C9_POWER1, C9_POWER2, C9_POWER3, C9_POWER4, C12_POWER1, C12_POWER2, C12_POWER3, C12_POWER4, C13_POWER1, C13_POWER2, C13_POWER3, C13_POWER4, C15_POWER1, C15_POWER2, C15_POWER3, C15_POWER4, C16_POWER1, C16_POWER2, C16_POWER3, C16_POWER4, C17_POWER1, C17_POWER2, C17_POWER3, C17_POWER4, C23_POWER1, C23_POWER2, C23_POWER3, C23_POWER4, C24_POWER1, C24_POWER2, C24_POWER3, C24_POWER4, C45_POWER1, C45_POWER2, C45_POWER3, C45_POWER4, C48_POWER1, C48_POWER2, C48_POWER3, C48_POWER4, C49_POWER1, C49_POWER2, C49_POWER3, C49_POWER4, C51_POWER1, C51_POWER2, C51_POWER3, C51_POWER4, C52_POWER1, C52_POWER2, C52_POWER3, C52_POWER4, C57_POWER1, C57_POWER2, C57_POWER3, C57_POWER4, C58_POWER1, C58_POWER2, C58_POWER3, C58_POWER4, C59_POWER1, C59_POWER2, C59_POWER3, C59_POWER4, C60_POWER1, C60_POWER2, C60_POWER3, C60_POWER4, C61_POWER1, C61_POWER2, C61_POWER3, C61_POWER4, C62_POWER1, C62_POWER2, C62_POWER3, C62_POWER4, C64_POWER1, C64_POWER2, C64_POWER3, C64_POWER4, C65_POWER1, C65_POWER2, C65_POWER3, C65_POWER4, C66_POWER1, C66_POWER2, C66_POWER3, C66_POWER4, C67_POWER1, C67_POWER2, C67_POWER3, C67_POWER4 | 0603 | Taiyo Yuden | EMK107B7104KAHT | 108.0
2.2uF/50V | Multilayer Ceramic Capacitors MLCC - SMD/SMT 0603 2.2uF 20% 50VDC X5R | C32, C74, C75, C77, C78 | 0603 | Murata Electronics | GRM188R61H225ME11J | 5.0
1nF/63V | Multilayer Ceramic Capacitors MLCC - SMD/SMT 63V 1000pF 0603 X7R 10% AEC-Q200 | C21 | 0603 | KEMET | 80-C0603C102KMREAUTO | 1.0
10pF/50V | Multilayer Ceramic Capacitors MLCC - SMD/SMT 50V 10pF 0603 C0G 5% AEC-Q200 | C25, C36, C37, C38, C39 | 0603 | KEMET | C0603C100J5GACAUTO | 5.0
0.1uF/50V | Multilayer Ceramic Capacitors MLCC - SMD/SMT 50V 0.1uF 0603 X7R 20% | C20, C30, C31, C34_U_VoltageAmplifier11, C34_U_VoltageAmplifier12, C34_U_VoltageAmplifier13, C34_U_VoltageAmplifier14, C34_U_VoltageAmplifier21, C34_U_VoltageAmplifier22, C34_U_VoltageAmplifier23, C34_U_VoltageAmplifier24, C34_U_VoltageAmplifier31, C34_U_VoltageAmplifier32, C34_U_VoltageAmplifier33, C34_U_VoltageAmplifier34, C34_U_VoltageAmplifier41, C34_U_VoltageAmplifier42, C34_U_VoltageAmplifier43, C34_U_VoltageAmplifier44, C34_U_VoltageAmplifier51, C34_U_VoltageAmplifier52, C34_U_VoltageAmplifier53, C34_U_VoltageAmplifier54, C34_U_VoltageAmplifier61, C34_U_VoltageAmplifier62, C34_U_VoltageAmplifier63, C34_U_VoltageAmplifier64, C34_U_VoltageAmplifier71, C34_U_VoltageAmplifier72, C34_U_VoltageAmplifier73, C34_U_VoltageAmplifier74, C34_U_VoltageAmplifier81, C34_U_VoltageAmplifier82, C34_U_VoltageAmplifier83, C34_U_VoltageAmplifier84, C34_U_VoltageAmplifier91, C34_U_VoltageAmplifier92, C34_U_VoltageAmplifier93, C34_U_VoltageAmplifier94, C34_U_VoltageAmplifier101, C34_U_VoltageAmplifier102, C34_U_VoltageAmplifier103, C34_U_VoltageAmplifier104, C34_U_VoltageAmplifier111, C34_U_VoltageAmplifier112, C34_U_VoltageAmplifier113, C34_U_VoltageAmplifier114, C34_U_VoltageAmplifier121, C34_U_VoltageAmplifier122, C34_U_VoltageAmplifier123, C34_U_VoltageAmplifier124, C34_U_VoltageAmplifier131, C34_U_VoltageAmplifier132, C34_U_VoltageAmplifier133, C34_U_VoltageAmplifier134, C34_U_VoltageAmplifier141, C34_U_VoltageAmplifier142, C34_U_VoltageAmplifier143, C34_U_VoltageAmplifier144, C34_U_V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 | 0603 | KEMET | C0603C104M5RACTU | 160.0
0.047uF/50V | Multilayer Ceramic Capacitors MLCC - SMD/SMT 50V 0.047uF 0603 X7R 10% | C35, C63 | 0603 | KEMET | C0603C473K5RAC7411 | 2.0
1uF/16V | Multilayer Ceramic Capacitors MLCC - SMD/SMT 16volts 1uF X7R 10% | C18 | 0603 | KEMET | C0603C105K4RAC7411 | 1.0
0.47uF/16V | Multilayer Ceramic Capacitors MLCC - SMD/SMT 16V 0.47uF 0603 X7R 5% AEC-Q200 | C7_POWER1, C7_POWER2, C7_POWER3, C7_POWER4, C47_POWER1, C47_POWER2, C47_POWER3, C47_POWER4, C54_POWER1, C54_POWER2, C54_POWER3, C54_POWER4, C68_POWER1, C68_POWER2, C68_POWER3, C68_POWER4 | 0603 | KEMET | C0603C474J4RACAUTO | 16.0
0.01uF/16V | Multilayer Ceramic Capacitors MLCC - SMD/SMT 16V 0.01uF X7R 0603 10% AEC-Q200 | C2_POWER1, C2_POWER2, C2_POWER3, C2_POWER4, C3_POWER1, C3_POWER2, C3_POWER3, C3_POWER4, C53_POWER1, C53_POWER2, C53_POWER3, C53_POWER4 | 0603 | KEMET | C0603C103K4RECAUTO | 12.0
RJHSE-5381 | Modular Connectors / Ethernet Connectors R/A RJ45 SHEILDED 8 CONT Y/G LEDS | J1 |  | Amphenol Commercial Products | RJHSE-5381 | 1.0
LD1085D2T33R | Integrated Circuit | U6 |  | STMicroelectronics | LD1085D2T33R | 1.0
Header 20X2 | Headers & Wire Housings 2X20 POS VERT TIN | P_E_1, P_E_2, P_E_3, P_E_4, P_O_1, P_O_2, P_O_3, P_O_4 | DIN | TE Connectivity / AMP | 2-826942-0 | 8.0
IX4427MTR | Gate Drivers Dual 1.5A Low Side Gate Driver | U9_U_VoltageAmplifier11, U9_U_VoltageAmplifier12, U9_U_VoltageAmplifier13, U9_U_VoltageAmplifier14, U9_U_VoltageAmplifier21, U9_U_VoltageAmplifier22, U9_U_VoltageAmplifier23, U9_U_VoltageAmplifier24, U9_U_VoltageAmplifier31, U9_U_VoltageAmplifier32, U9_U_VoltageAmplifier33, U9_U_VoltageAmplifier34, U9_U_VoltageAmplifier41, U9_U_VoltageAmplifier42, U9_U_VoltageAmplifier43, U9_U_VoltageAmplifier44, U9_U_VoltageAmplifier51, U9_U_VoltageAmplifier52, U9_U_VoltageAmplifier53, U9_U_VoltageAmplifier54, U9_U_VoltageAmplifier61, U9_U_VoltageAmplifier62, U9_U_VoltageAmplifier63, U9_U_VoltageAmplifier64, U9_U_VoltageAmplifier71, U9_U_VoltageAmplifier72, U9_U_VoltageAmplifier73, U9_U_VoltageAmplifier74, U9_U_VoltageAmplifier81, U9_U_VoltageAmplifier82, U9_U_VoltageAmplifier83, U9_U_VoltageAmplifier84, U9_U_VoltageAmplifier91, U9_U_VoltageAmplifier92, U9_U_VoltageAmplifier93, U9_U_VoltageAmplifier94, U9_U_VoltageAmplifier101, U9_U_VoltageAmplifier102, U9_U_VoltageAmplifier103, U9_U_VoltageAmplifier104, U9_U_VoltageAmplifier111, U9_U_VoltageAmplifier112, U9_U_VoltageAmplifier113, U9_U_VoltageAmplifier114, U9_U_VoltageAmplifier121, U9_U_VoltageAmplifier122, U9_U_VoltageAmplifier123, U9_U_VoltageAmplifier124, U9_U_VoltageAmplifier131, U9_U_VoltageAmplifier132, U9_U_VoltageAmplifier133, U9_U_VoltageAmplifier134, U9_U_VoltageAmplifier141, U9_U_VoltageAmplifier142, U9_U_VoltageAmplifier143, U9_U_VoltageAmplifier144, U9_U_VoltageAmplifier151, U9_U_VoltageAmplifier152, U9_U_VoltageAmplifier153, 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 |  | IXYS Integrated Circuits | IX4427MTR | 152.0
10M04SC E144 | FPGA - Field Programmable Gate Array non-volatile FPGA, 101 I/O, 144EQFP | P1_IO1, P1_IO2, P1_IO3, P1_IO4 | EQFP144 | Intel / Altera | 10M04SCE144C8G | 4.0
22uH | Fixed Inductors 22uH 2.9A 20% SMD PWR INDUCTOR | L6 |  | Sumida | CDRH124NP-220MC | 1.0
2.2uH | Fixed Inductors 2.2uH 20% High Temp AEC-Q200 | L4 |  | Vishay / Dale | IHLP1616BZER2R2M5A | 1.0
100R,1A | Ferrite Beads 100ohms 1A 60mOhms 0603 Ferrite Chip | L1_POWER1, L1_POWER2, L1_POWER3, L1_POWER4, L3_POWER1, L3_POWER2, L3_POWER3, L3_POWER4 | 0603 | TDK | MPZ1608D101BTA00 | 8.0
NUP4114 | ESD Suppressors / TVS Diodes LOW CAP TVS ARRAY 5.5V | U8 |  | ON SEMI | NUP4114HMR6T1G | 1.0
74HC151DB,118 | Encoders, Decoders, Multiplexers & Demultiplexers 8-INPUT MULTIPLEXER | U14 |  | NEXPERIA | 74HC151DB,118 | 1.0
MCP4562 | Digital Potentiometer ICs Sngl 8B NV I2C Rheo | U4 |  | Microchip Technology | MCP4562T-503E/MS | 1.0
PJ-002BH | Connector | J2 |  |  |  | 1.0
