haseebulhassan/Project-C/(list of files, cad)

Other CAD files:
Project-C/Project-C_LED/Datasheet/LCD/ER-TFTM035-6(4-wire-spi)_RTP_SD_FONT_FLASH/ER-TFTM035-6(4-wire-spi)_RTP_SD_FONT_FLASH/sd.OBJ
