haseebulhassan/Project-C/ReferenceMaterial/Test2.txt

NAme, test2
FRequencies, 320
OFfset,  6
ONset,  0
DUration, 65
PEriod, 0
NEgative, 1
UP, 0
inverse, 1
REmote, 0
BReak, 0
719780
720891
722002
723113
724224
725335
726446
727557
819668
820779
821890
823001
824112
825223
826334
827445
828556
920667
921778
922889
924000
925111
926222
927333
928444
929555
25399
26510
27621
28732
29843
30954
32065
33176
126399
127510
128621
129732
130843
131954
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
