haseebulhassan/Project-C/ReferenceMaterial/Test3.txt

NAme, test3
FRequencies, 320
OFfset,  6
ONset,  0
DUration, 65
PEriod, 0
NEgative, 1
UP, 0
inverse, 1
REmote, 0
BReak, 0
766891
768002
769113
770224
771335
772446
773557
865668
866779
867890
869001
870112
871223
872334
873445
874556
966667
967778
968889
970000
971111
972222
973333
974444
975555
20309
21420
22531
23642
24753
25864
26975
28086
121309
122420
123531
124642
125753
126864
127975
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
