haseebulhassan/Project-C/DesignReviews/Review_2/FTDI.pdf

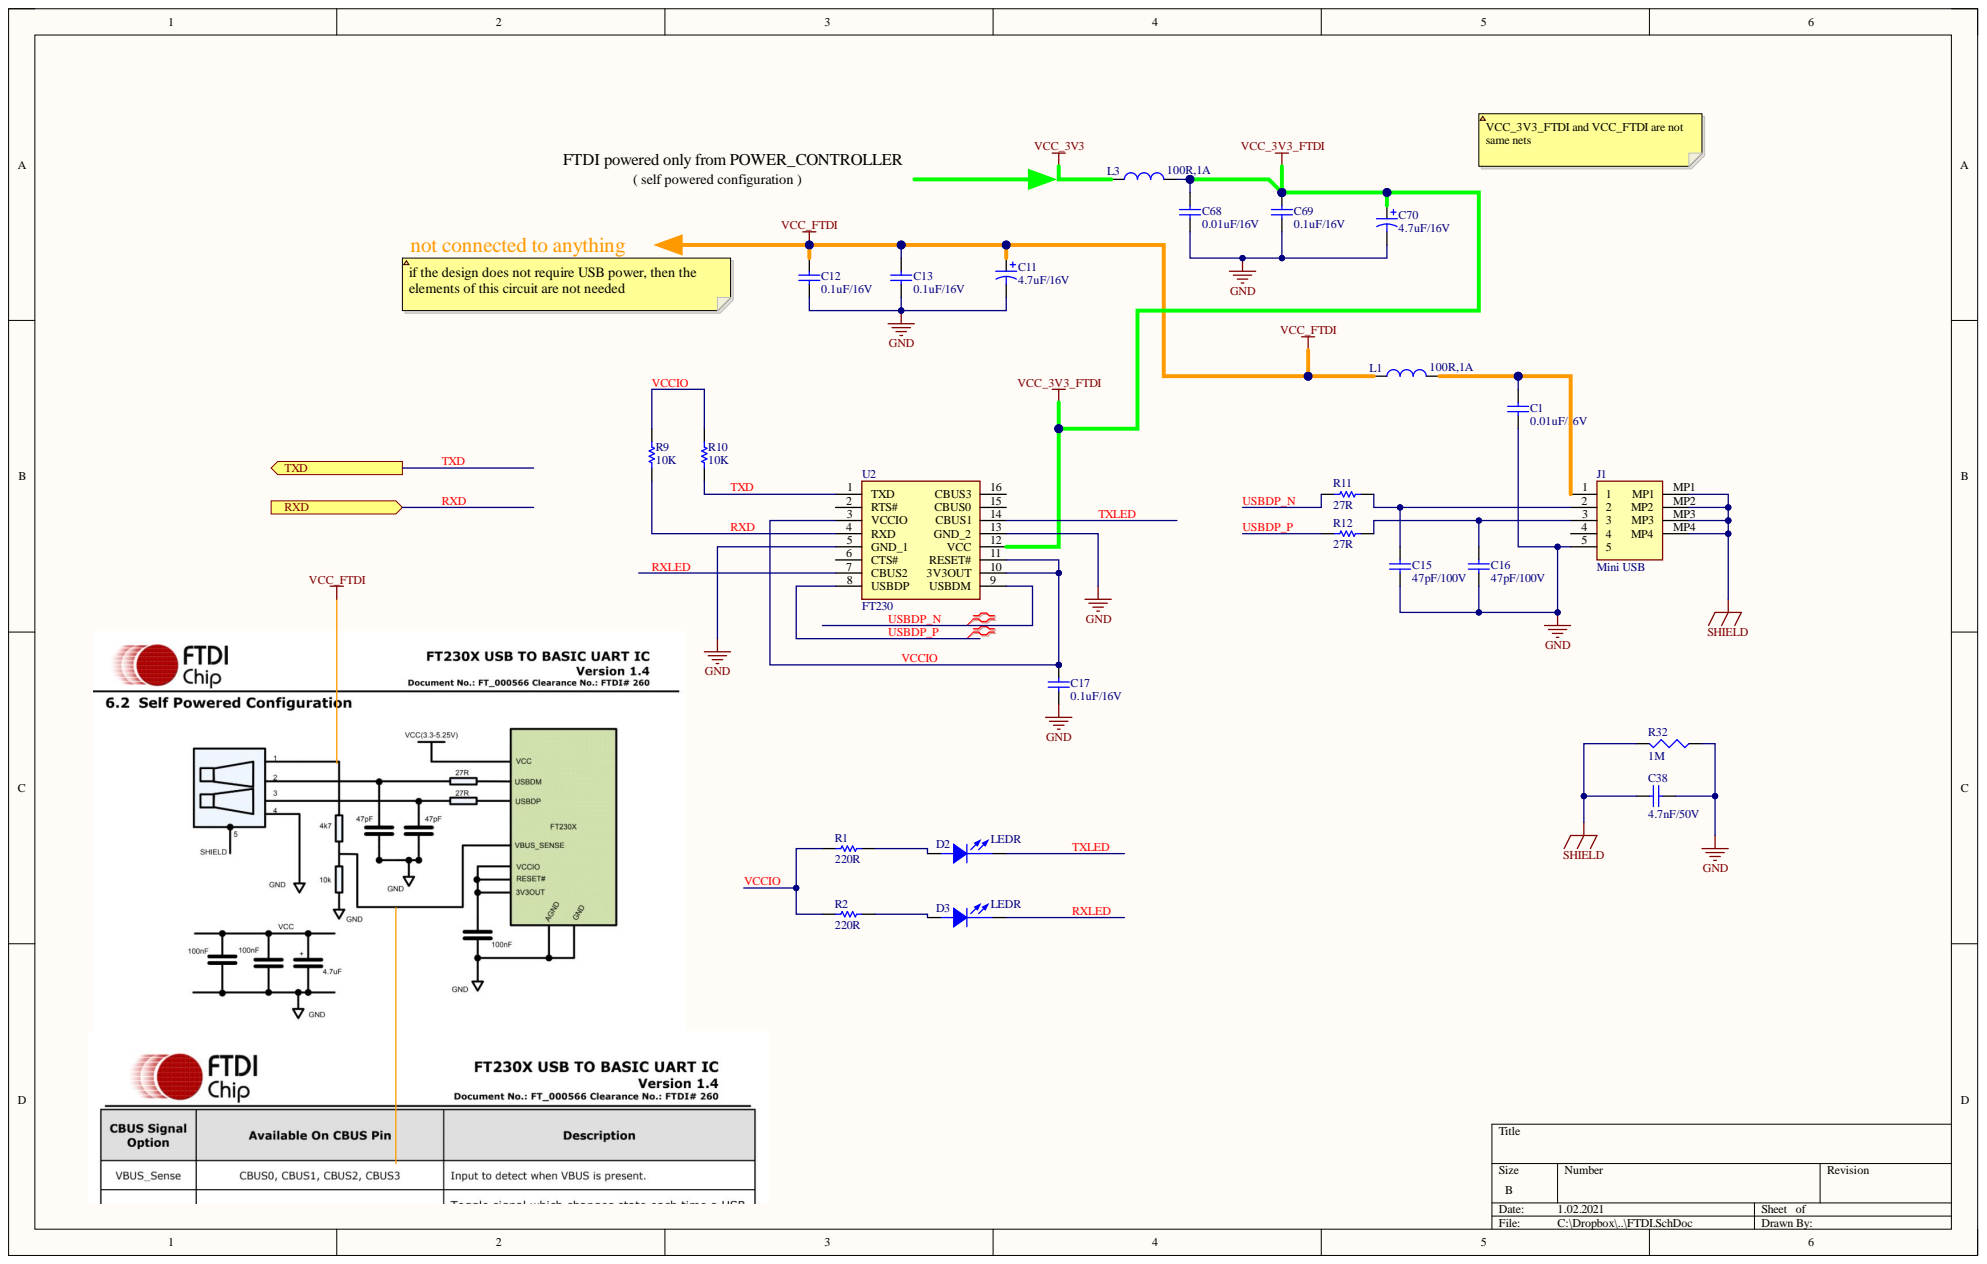
[picture p5: page 1]

FTDI powered only from POWER_CONTROLLER

not connected to anything

if the design does not require USB power, then the
elements of this circuit are not needed
