haseebulhassan/Project-C/DesignReviews/Review_2/POWER_CONTROLLER.pdf

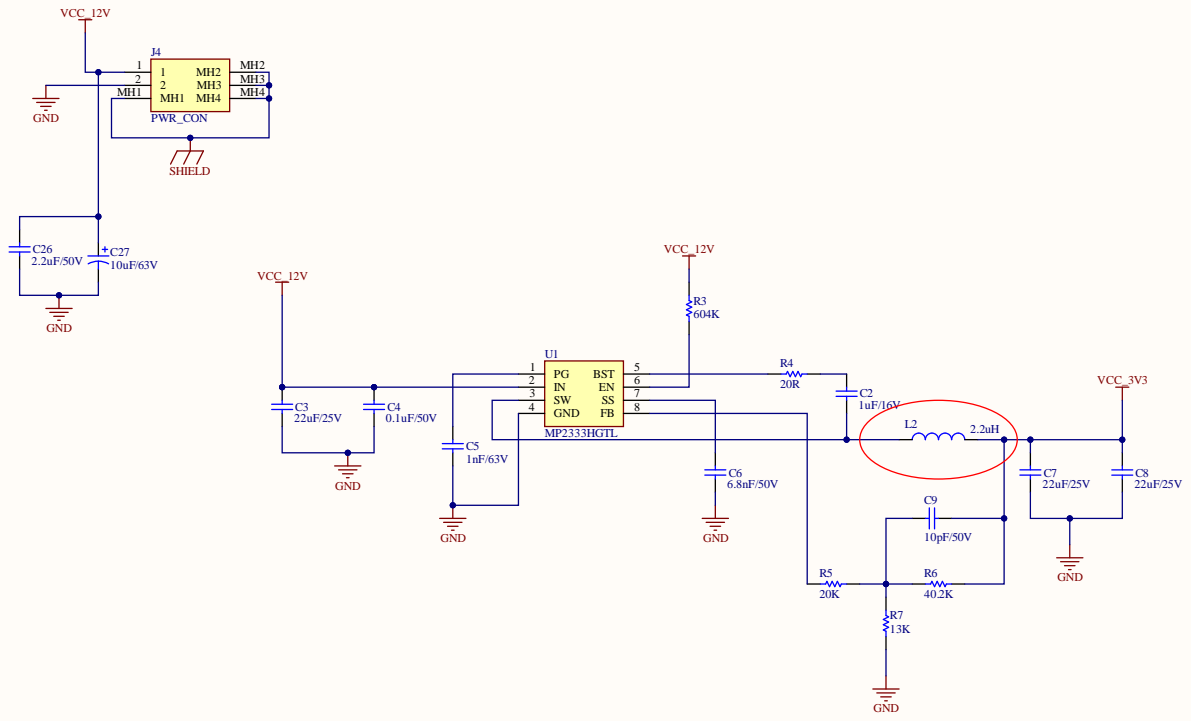
[picture p6: page 1]

2 | | MH3
MH1 | | MH4

4 | GND FB | 8 | | 1 u F / 1 6 V
