haseebulhassan/Project-C/DesignReviews/Review_2/TOP_VOLTAGE.pdf

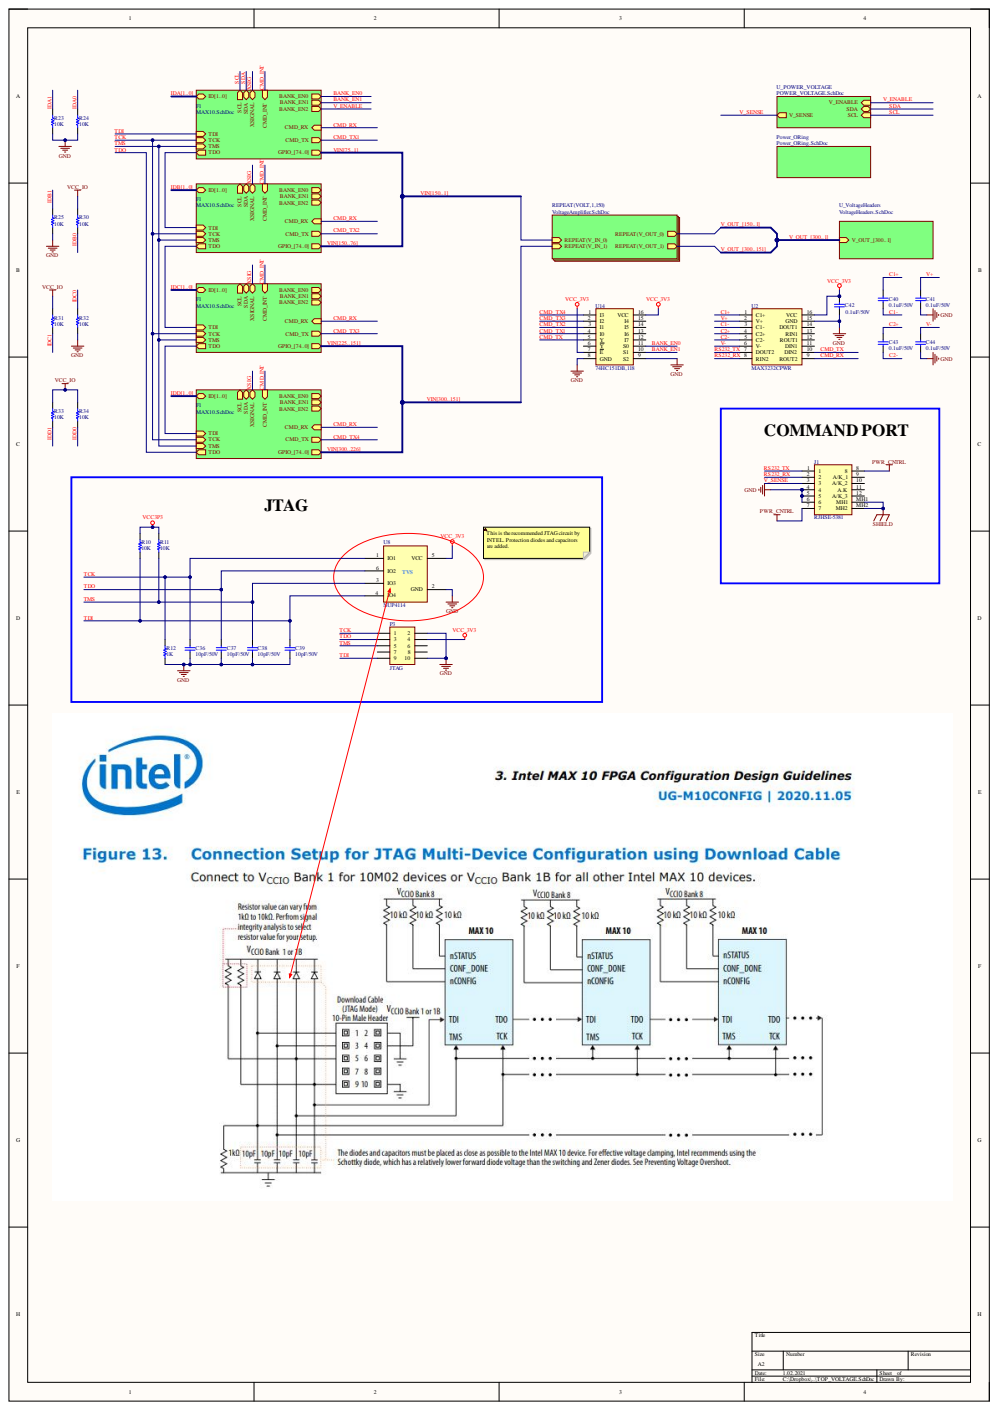
[picture p7: page 1]

This is the recommended JTAG circuit by
INTEL. Protection diodes and capacitors
are added.

TDO | | IO3 3

TMS
TDI | | NUP4114 P3

Size A2 | Number | Revision

Date: 1.02.2021 File: C:\Dropbox\..\TOP_VOLTAGE.SchDoc | Sheet of Drawn By:
