haseebulhassan/Project-C/DesignReviews/CheckGenerator320_report/C_VOLTAGE.pdf

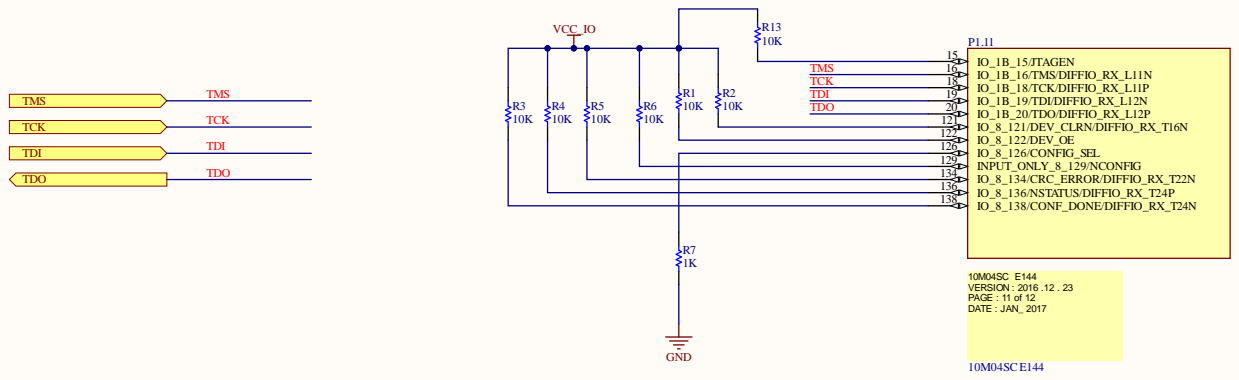
[picture p8: page 1]

1 2 2
1 2 6
1 2 9
1 3 4
1 3 6
1 3 8

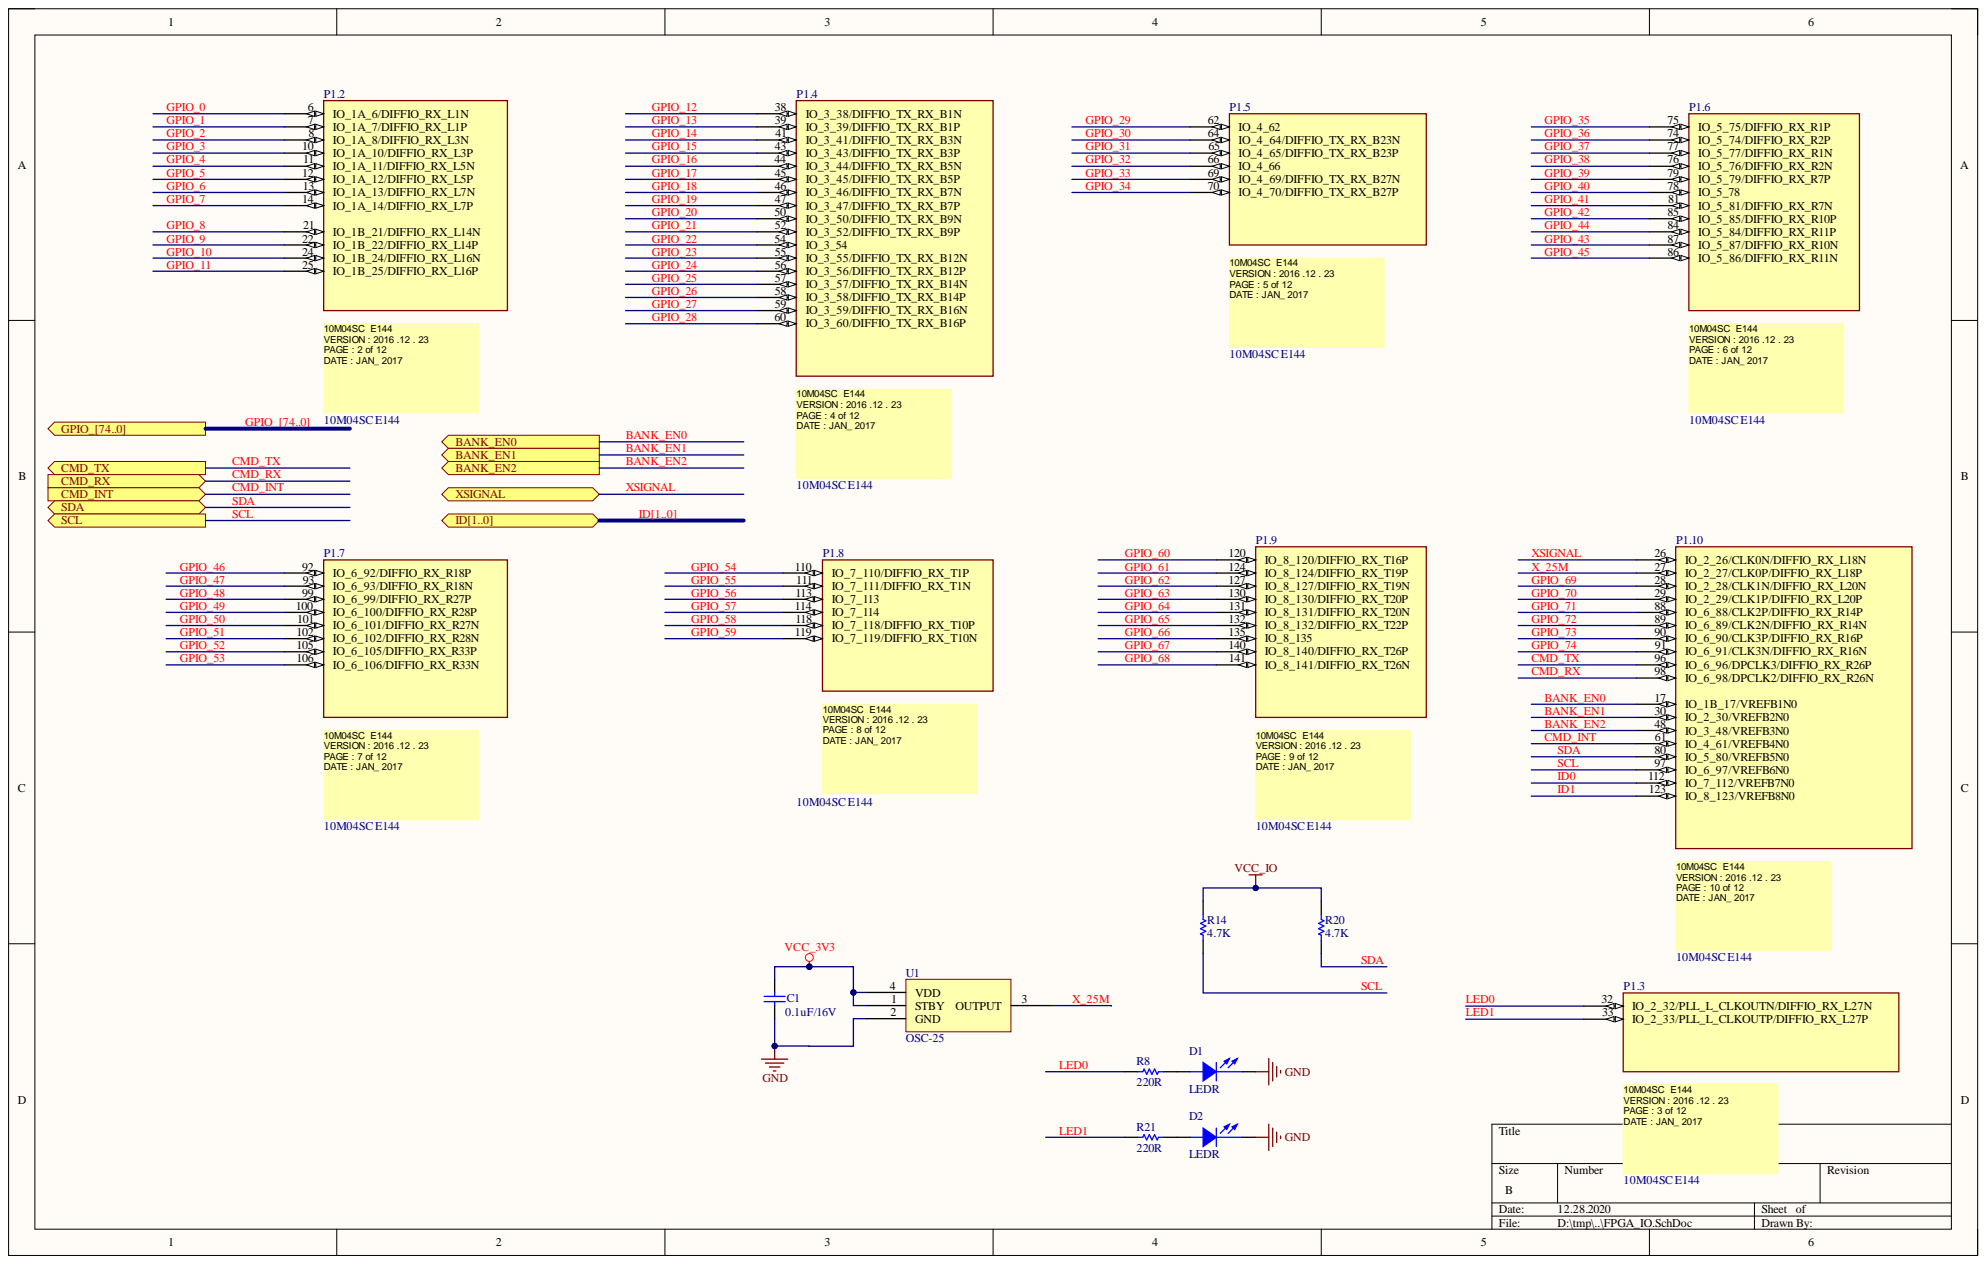
[picture p9: page 2]

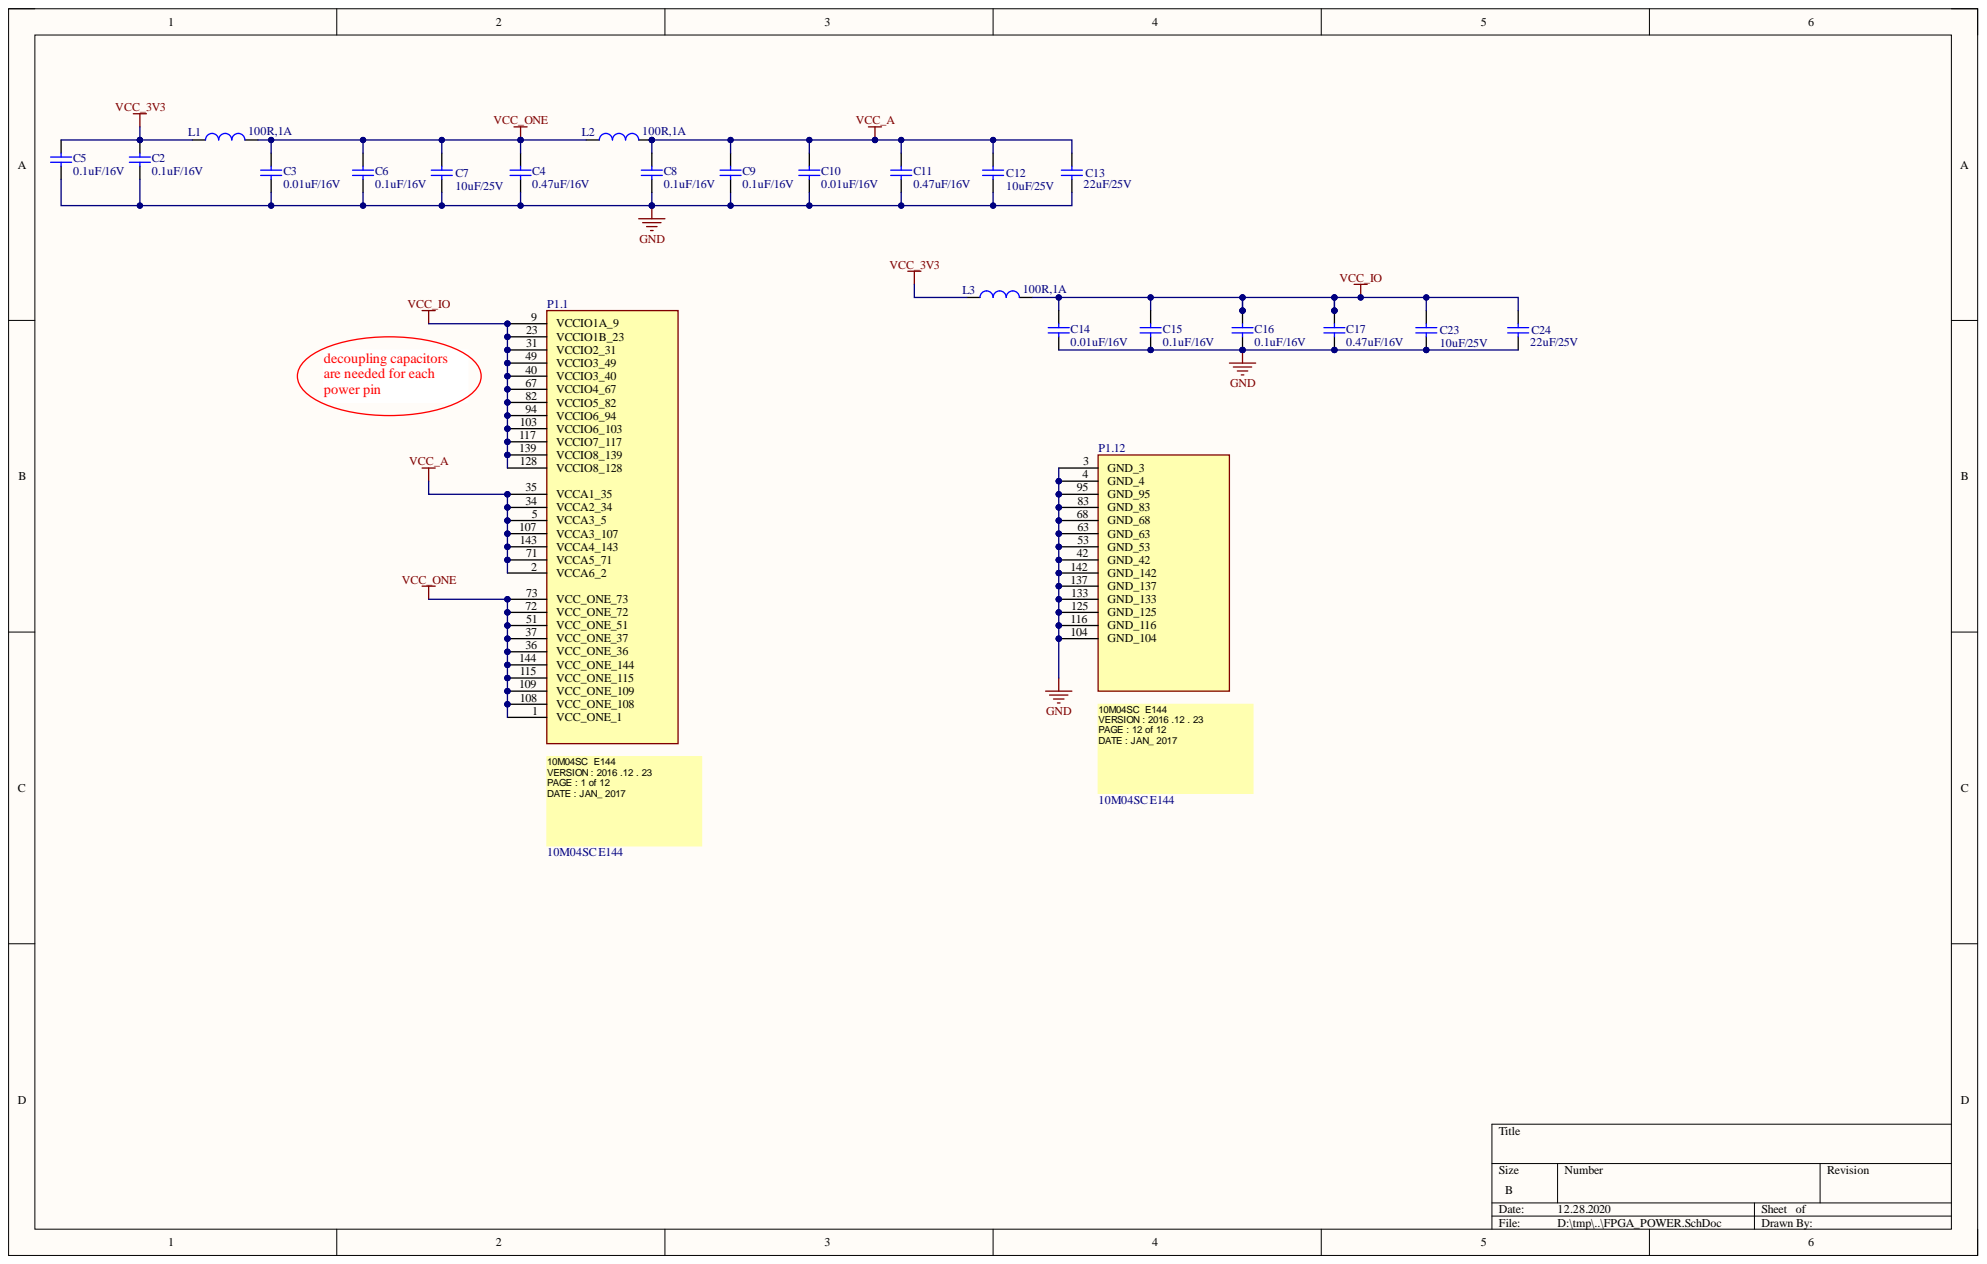
[picture p10: page 3]

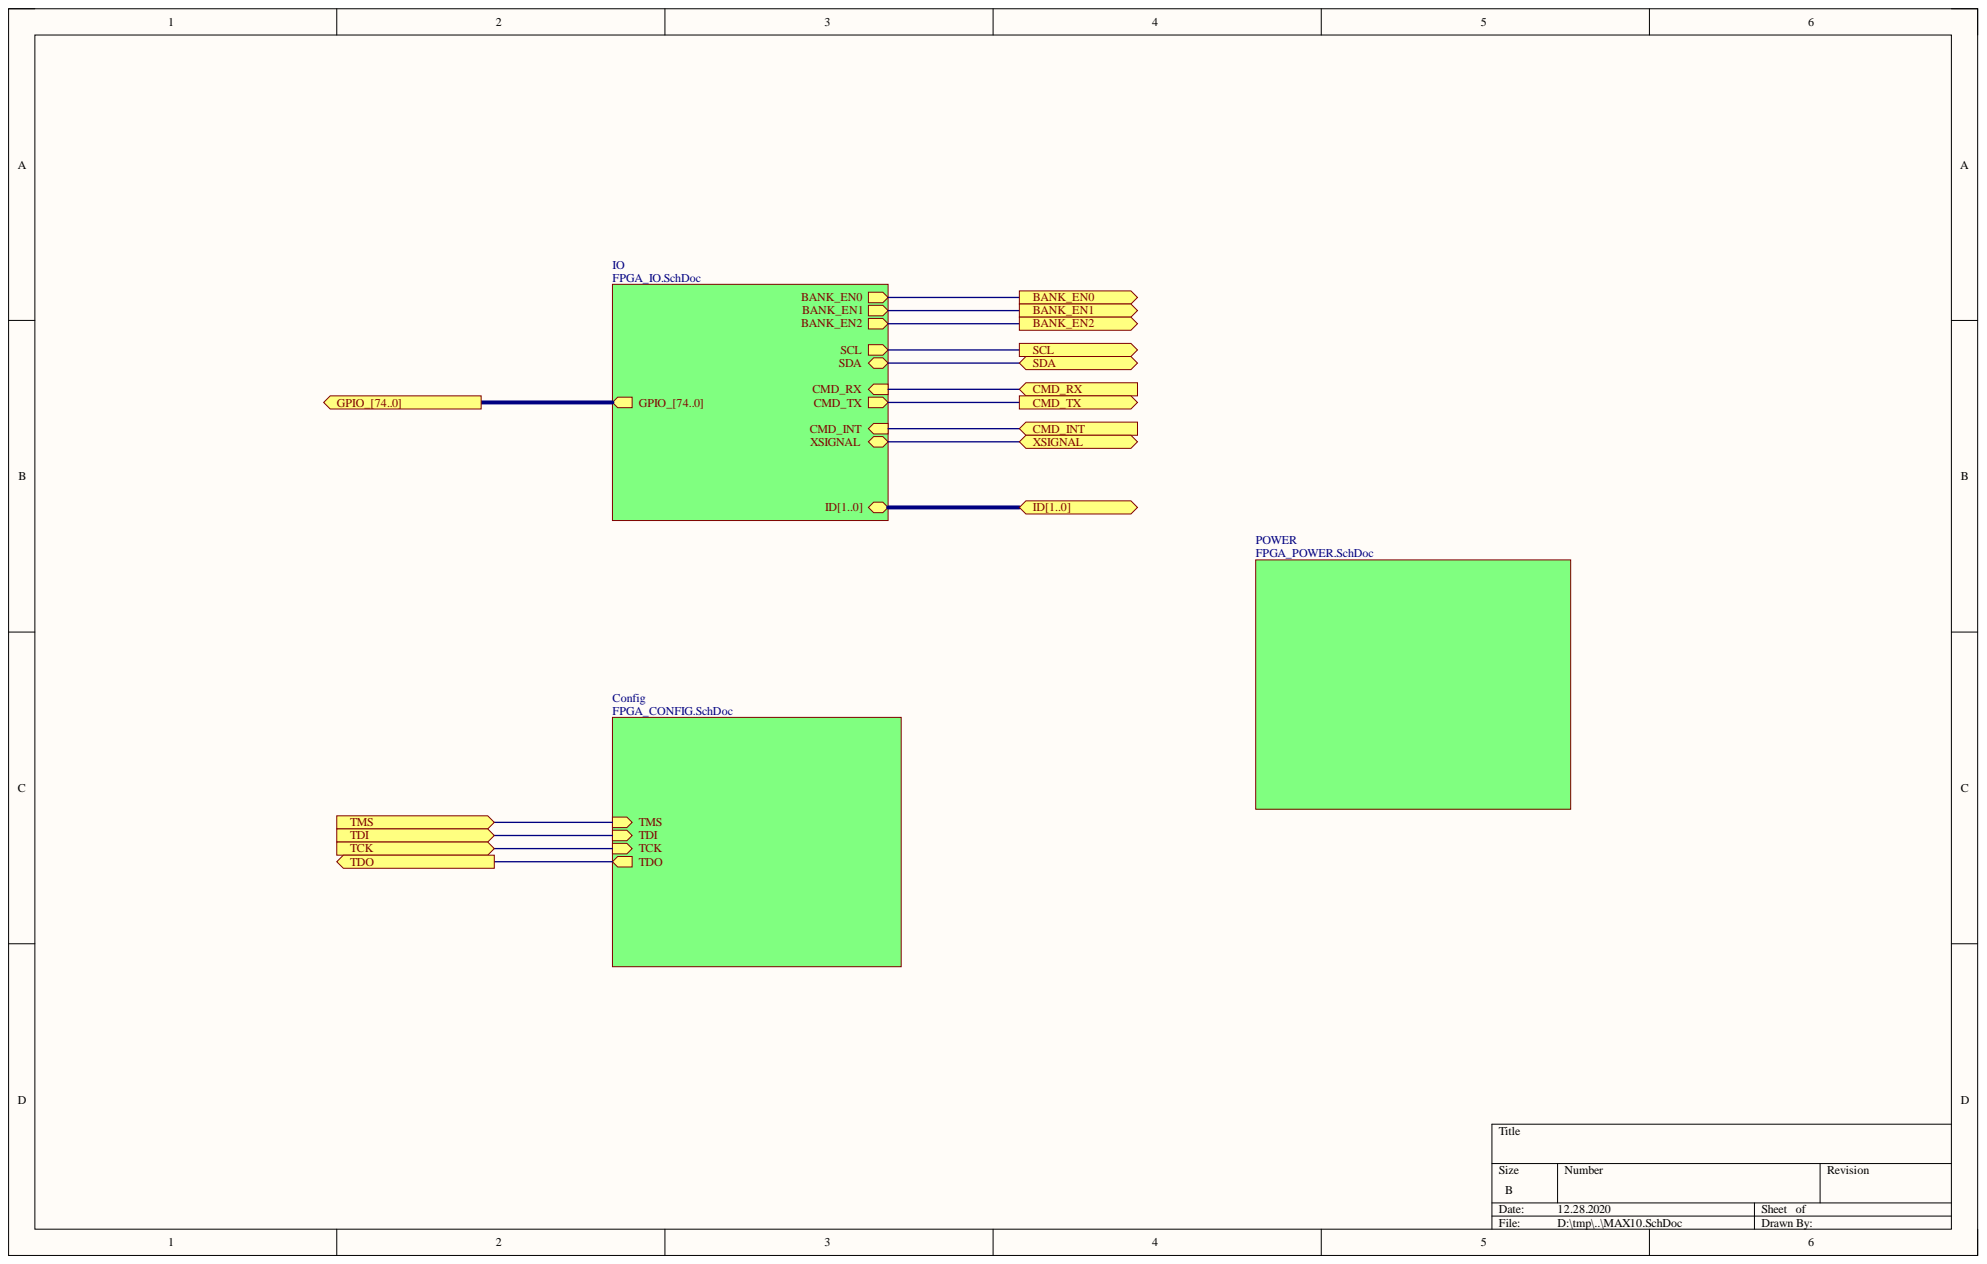
[picture p11: page 4]

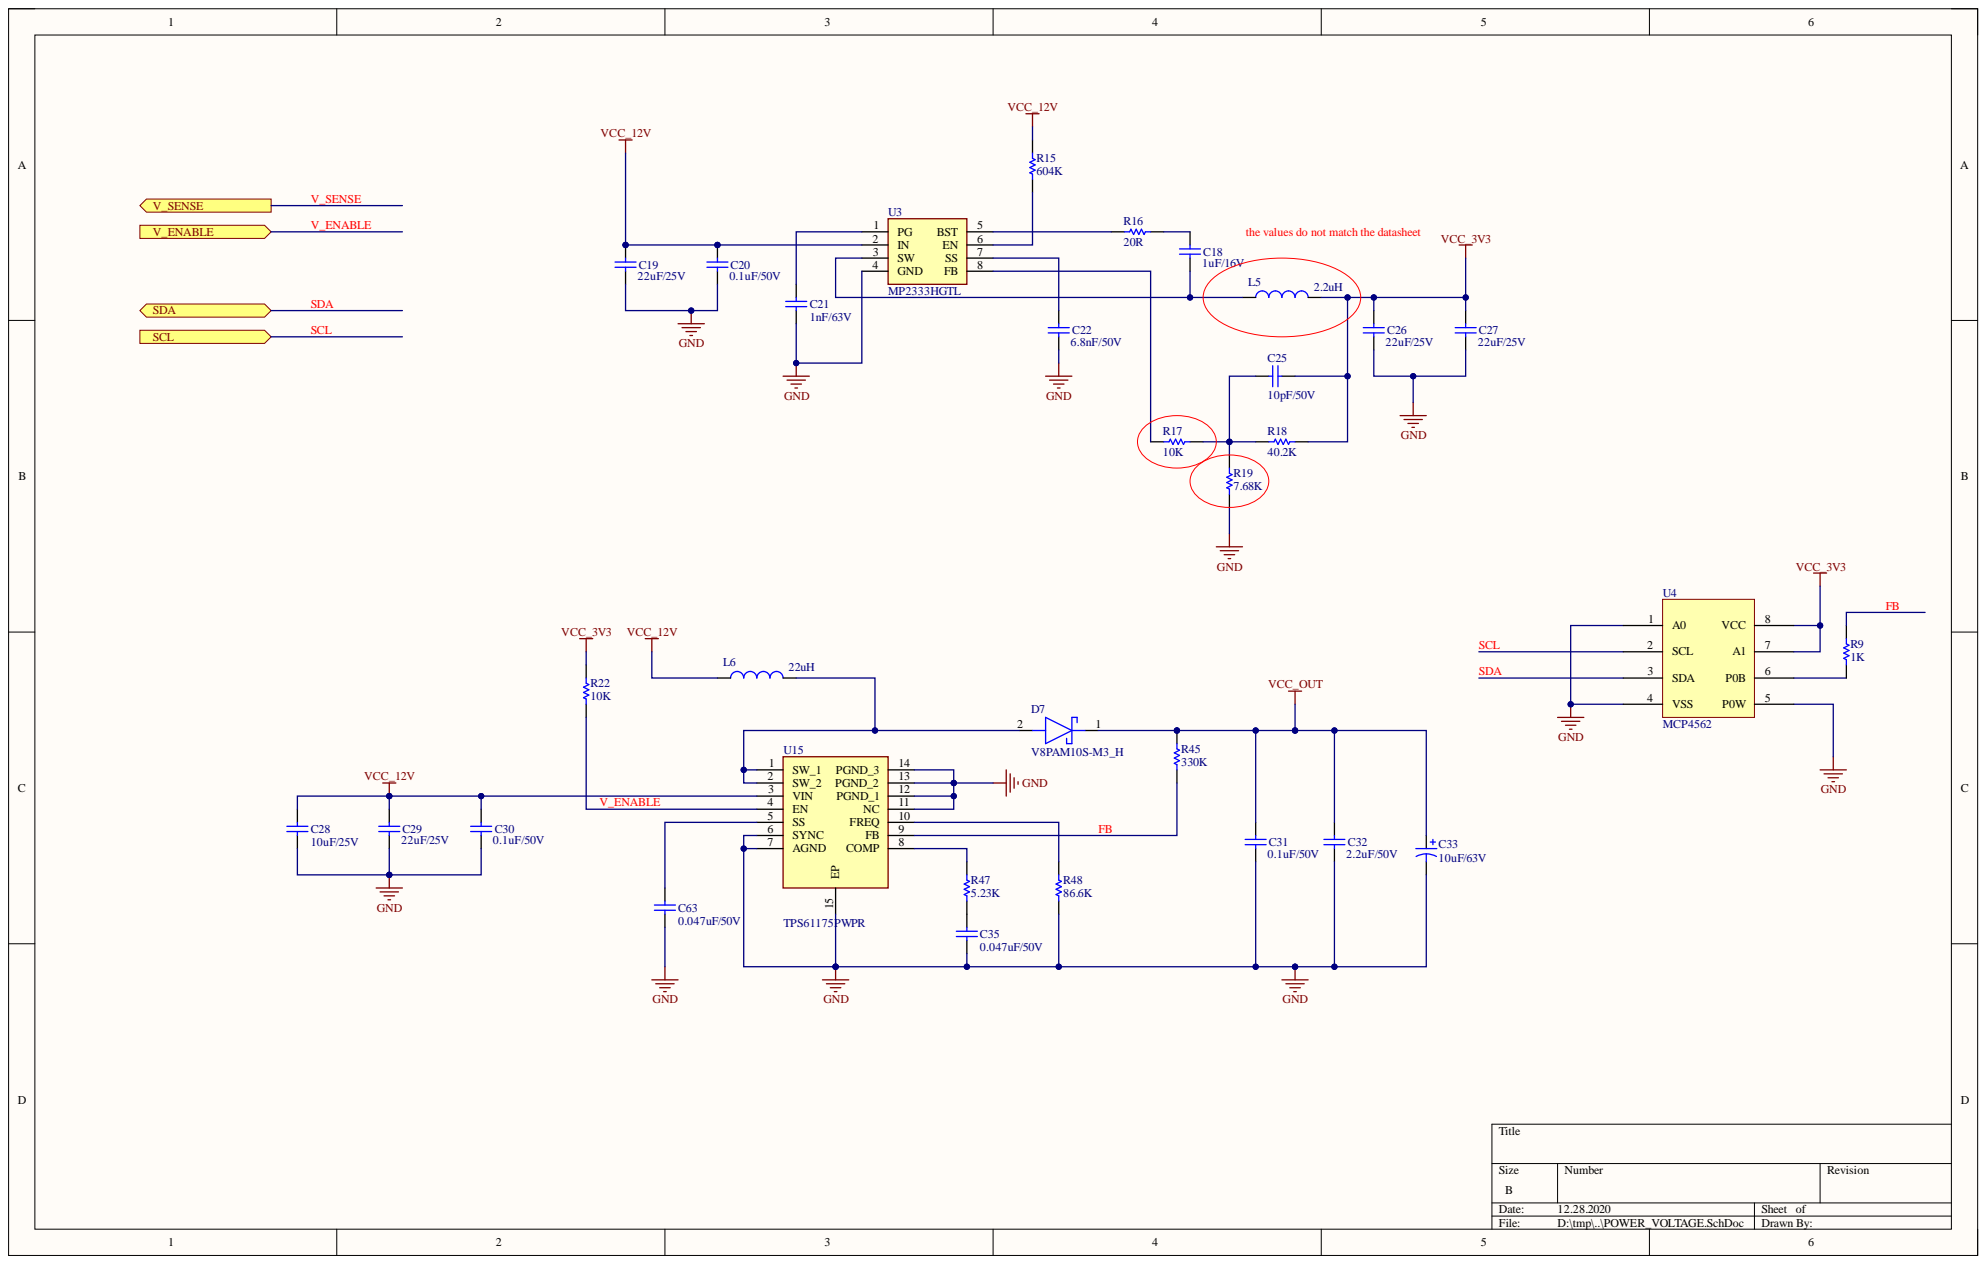
[picture p12: page 5]

the values do not match the datasheet

GND 4

C21 1nF/63V | MP2333HGTL

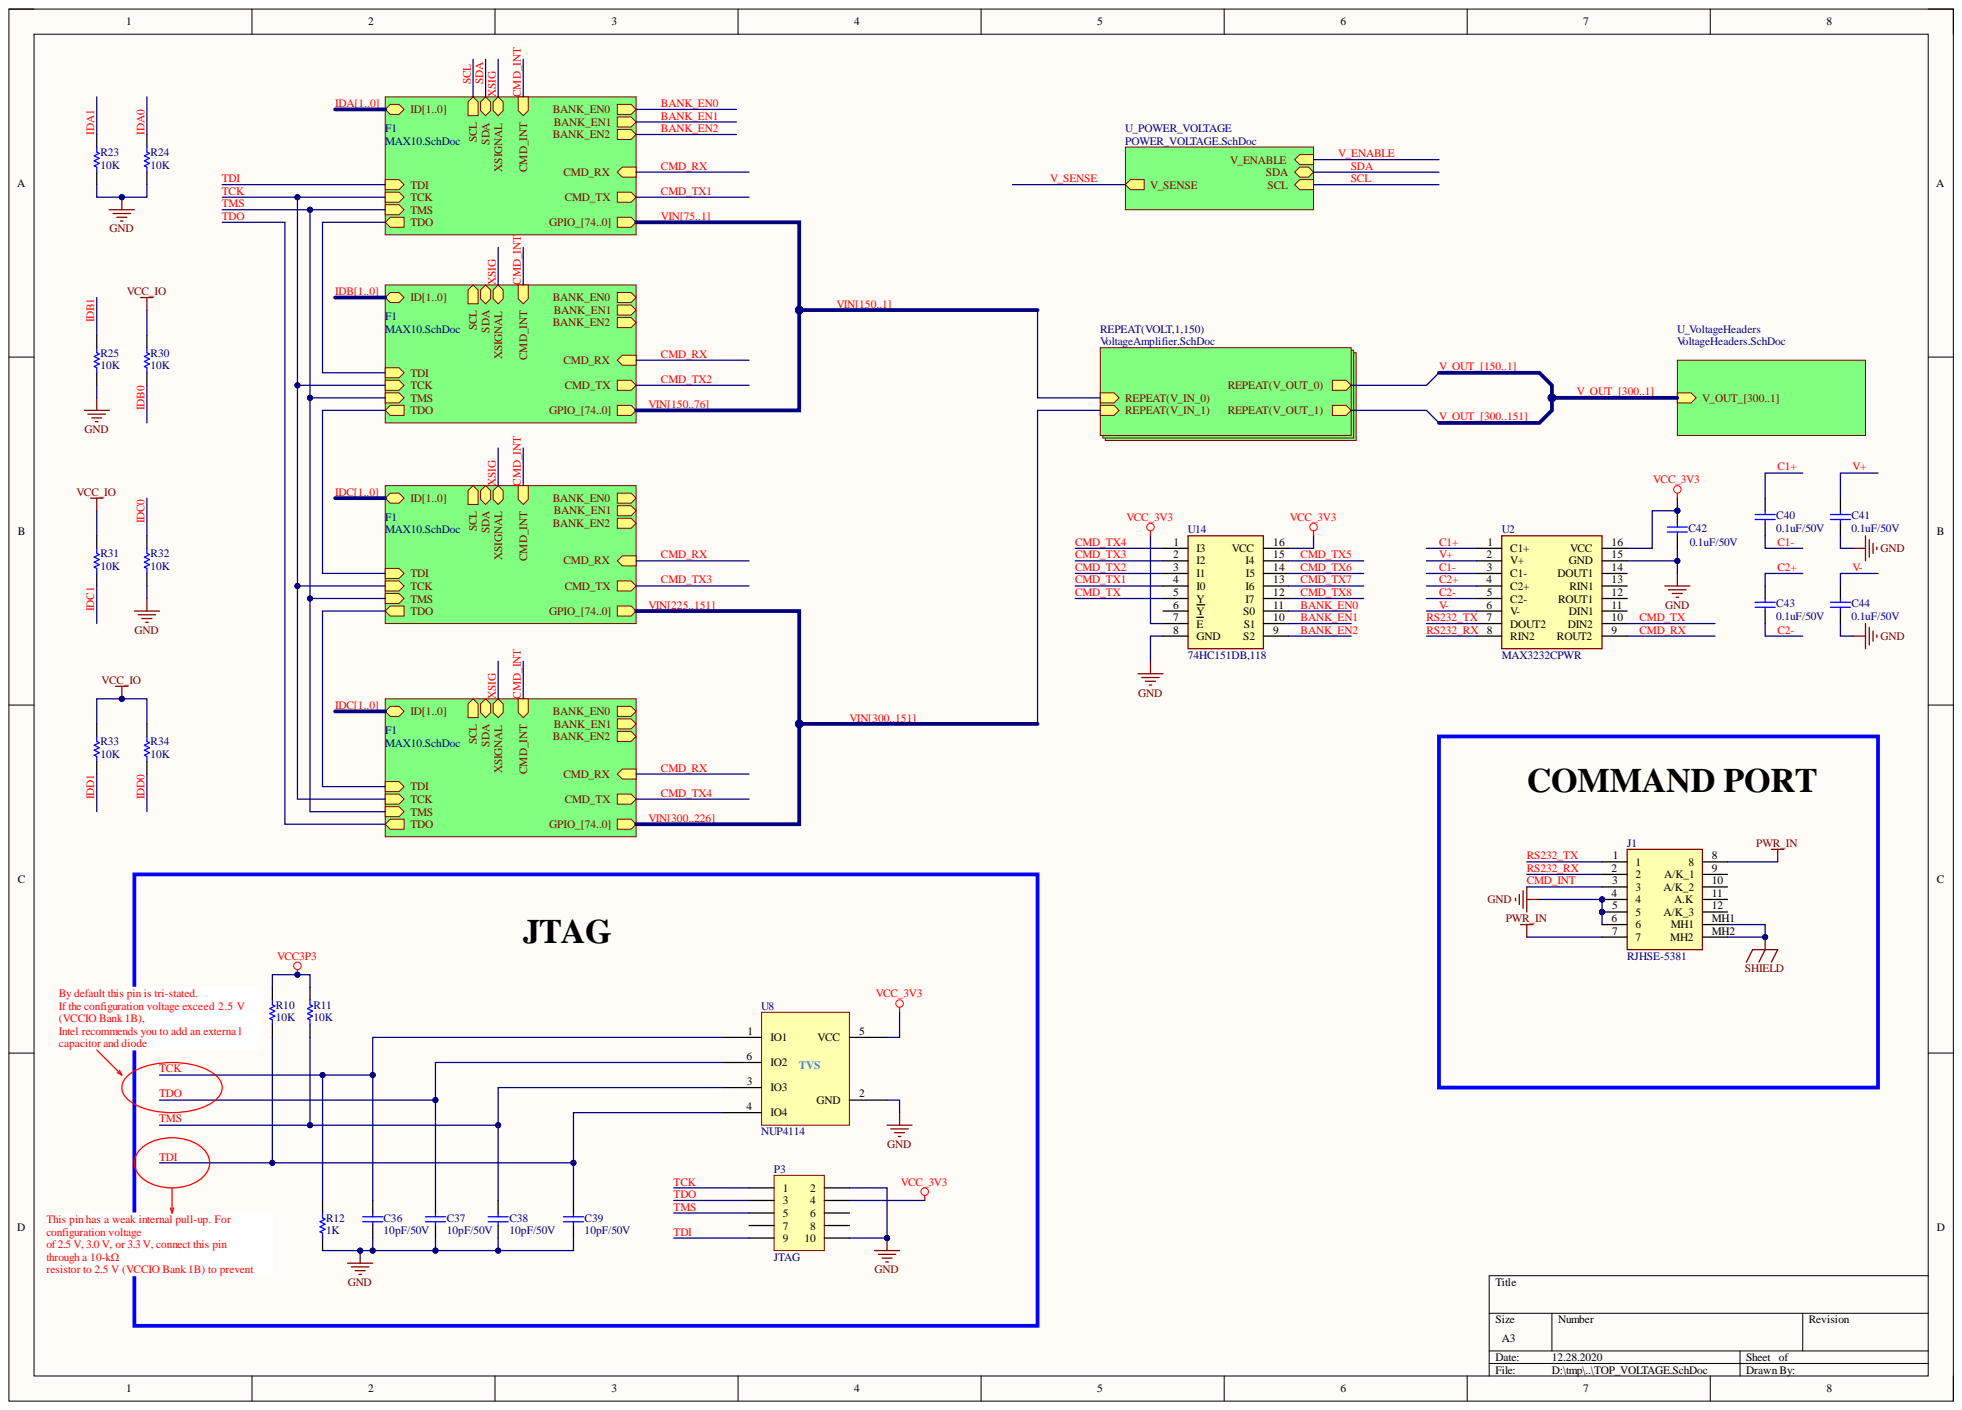
[picture p13: page 6]

By default this pin is tri-stated.
If the configuration voltage exceed 2.5 V
(VCCIO Bank 1B),
Intel recommends you to add an external
capacitor and diode

TDO

TMS

TDI | P3

This pin has a weak internal pull-up. For
configuration voltage
of 2.5 V, 3.0 V, or 3.3 V, connect this pin
through a 10-kΩ
resistor to 2.5 V (VCCIO Bank 1B) to prevent

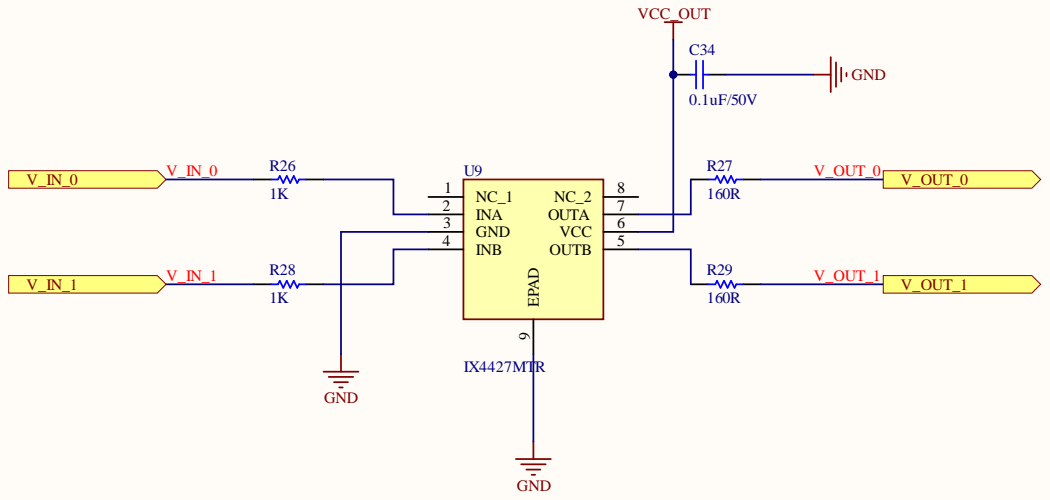
[picture p14: page 7]

GND 3
INB 4

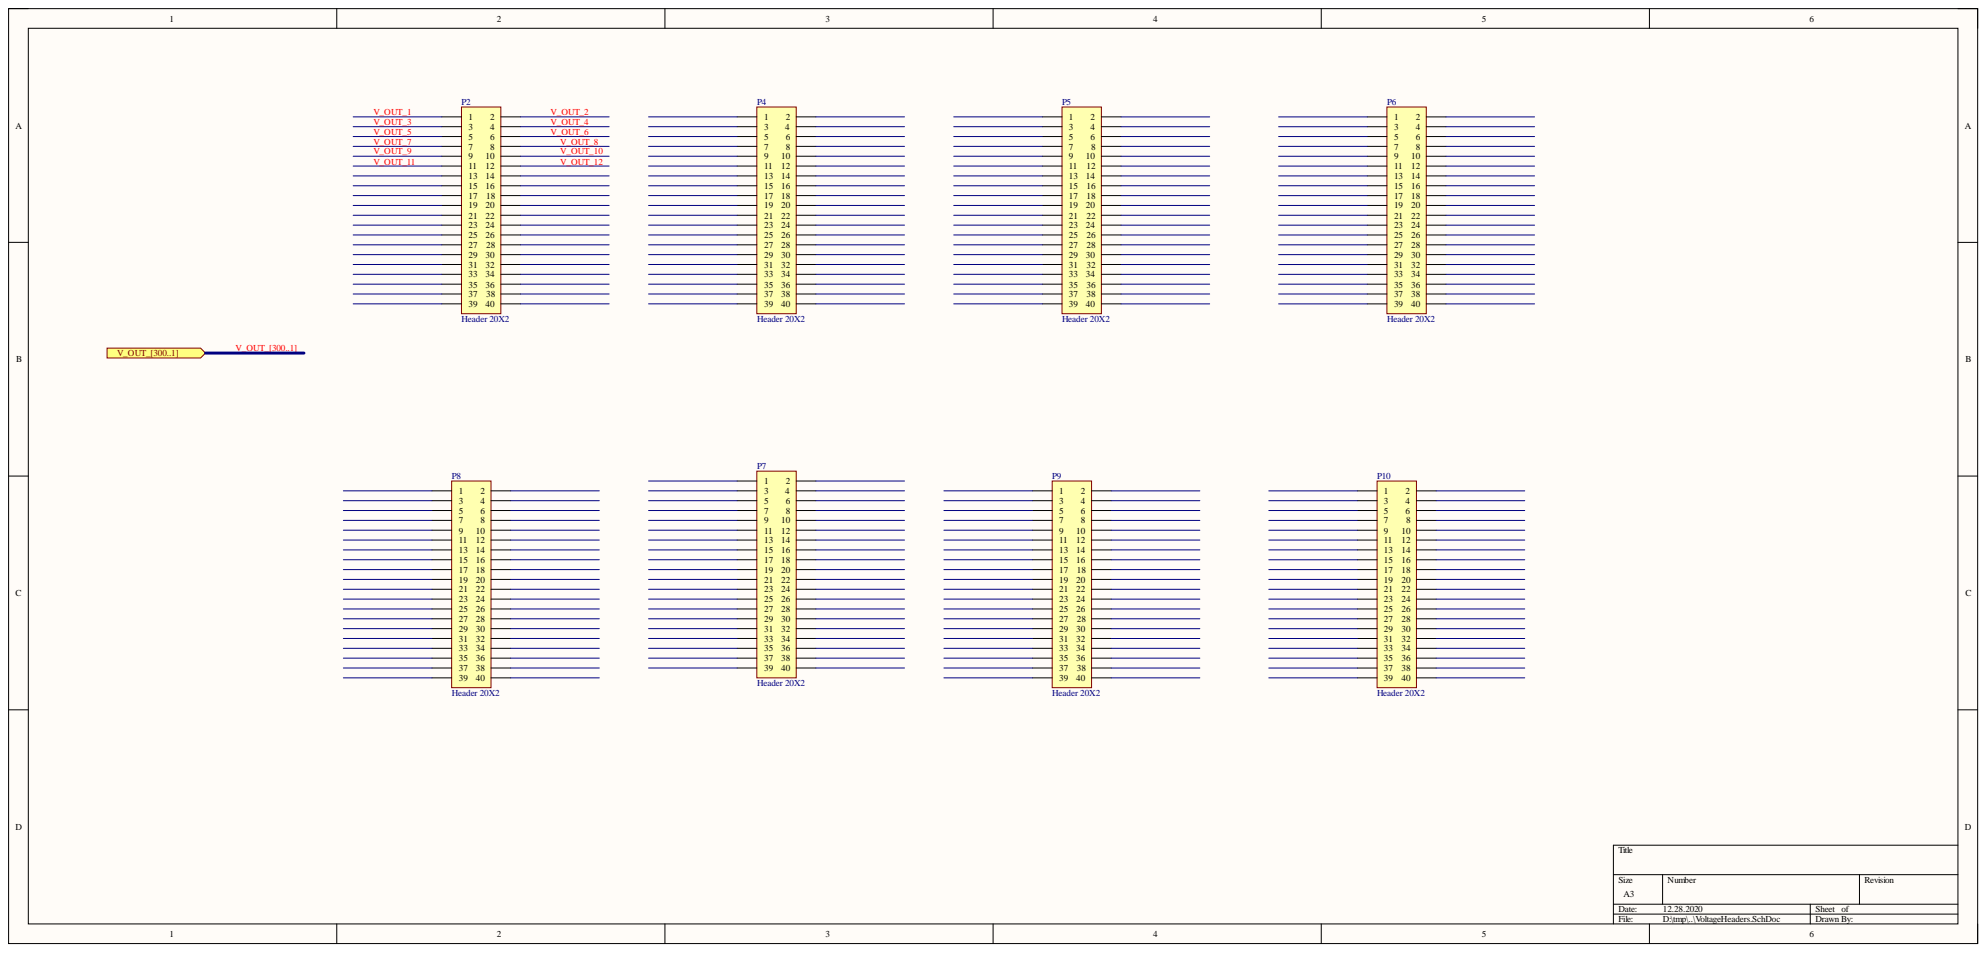
[picture p15: page 8]

Size A3 | Number | Revision

Date: 12.28.2020 | Sheet of
File: D:\tmp\..\VoltageHeaders.SchDoc | Drawn By:
