haseebulhassan/Project-C/DesignReviews/CheckGenerator320_report/Proj-C.PDF

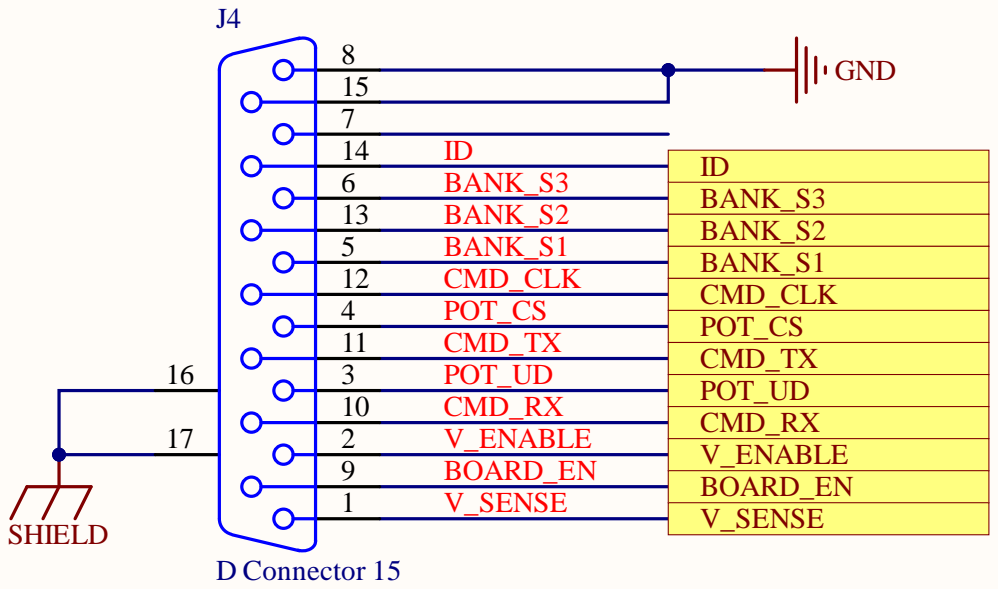
[picture p16: page 1]

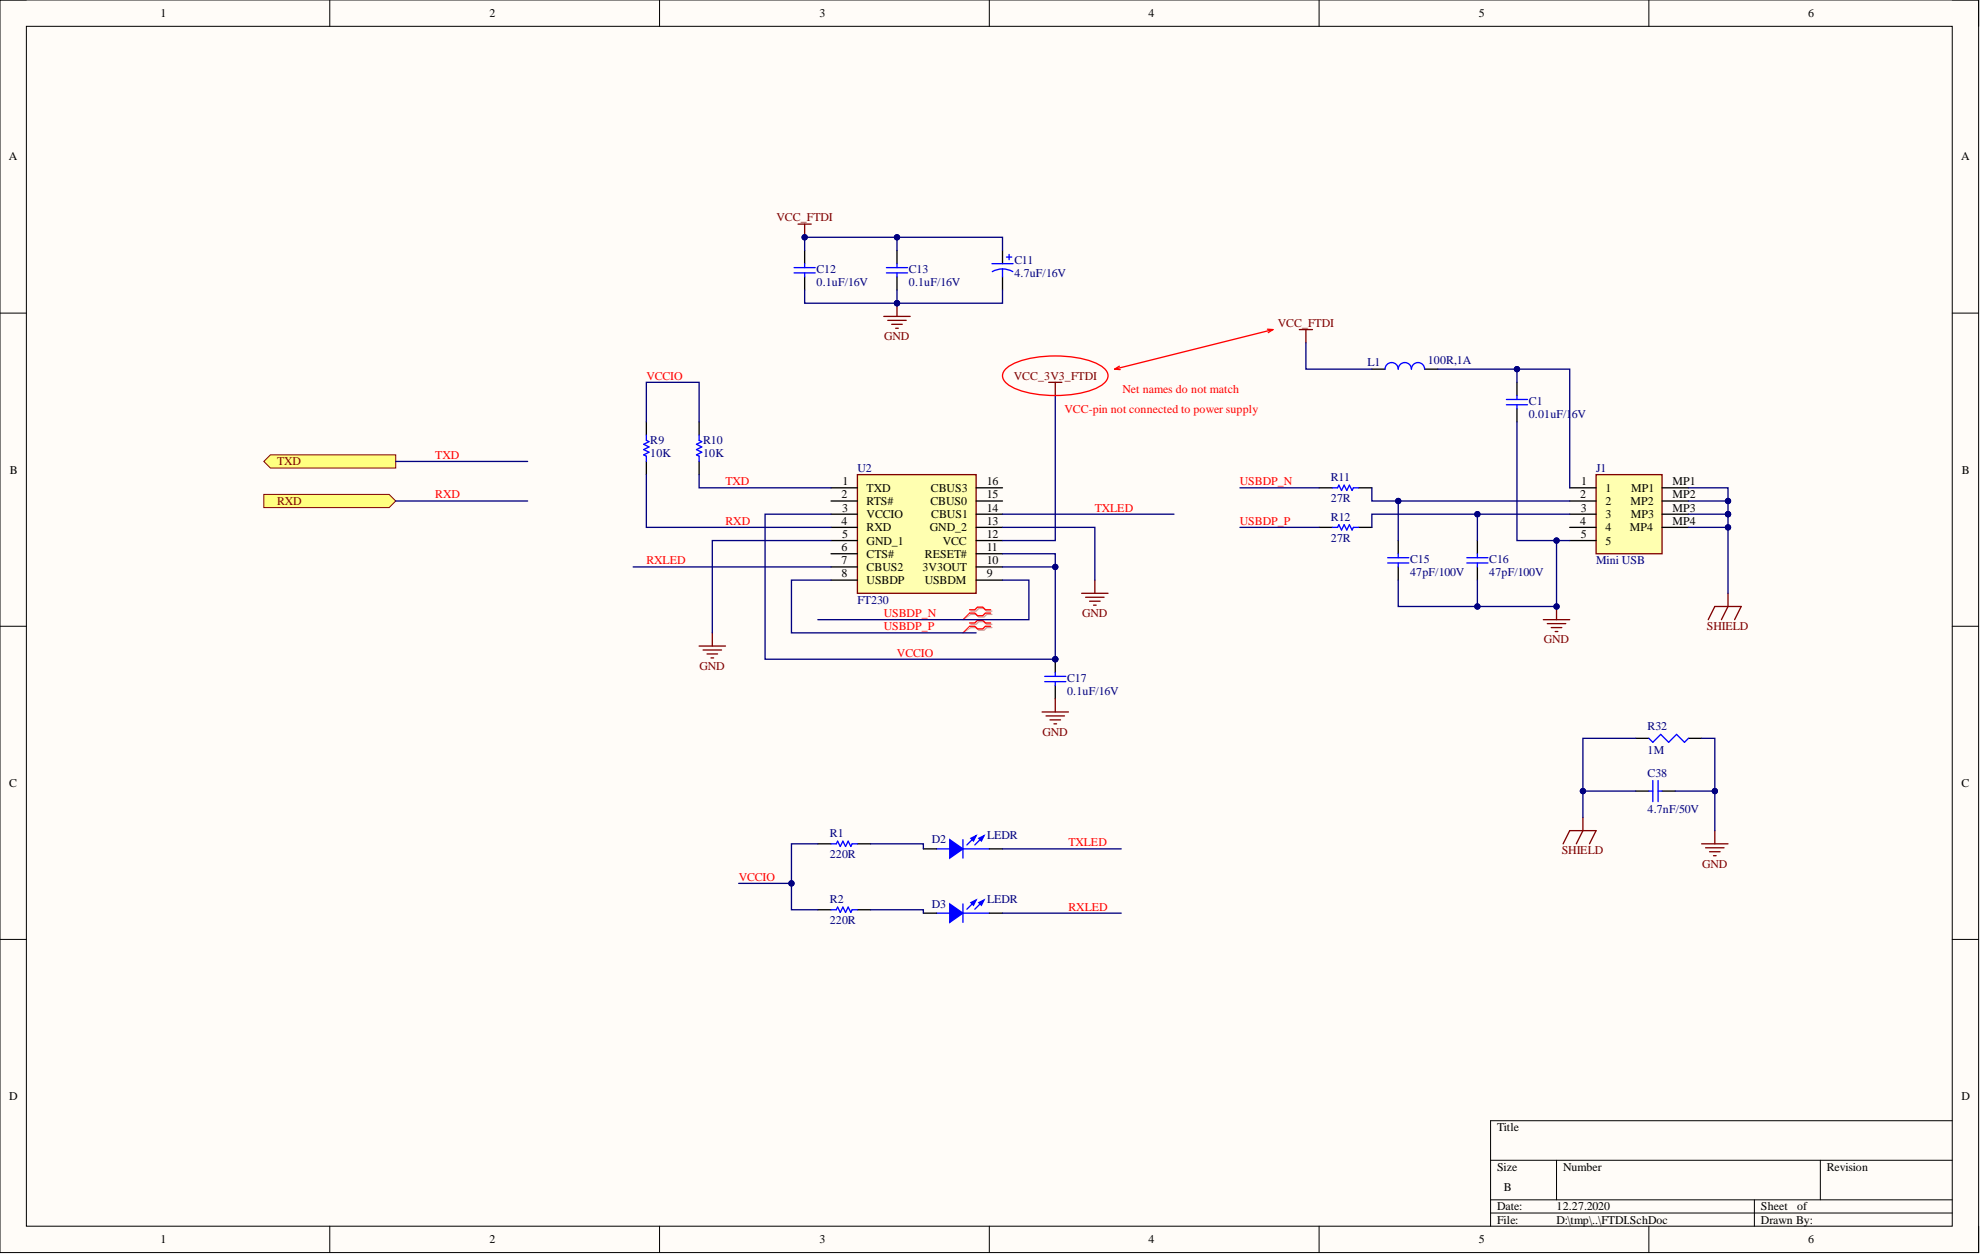
[picture p17: page 2]

Net names do not match

0.01uF/16V VCC-pin not connected to power supply

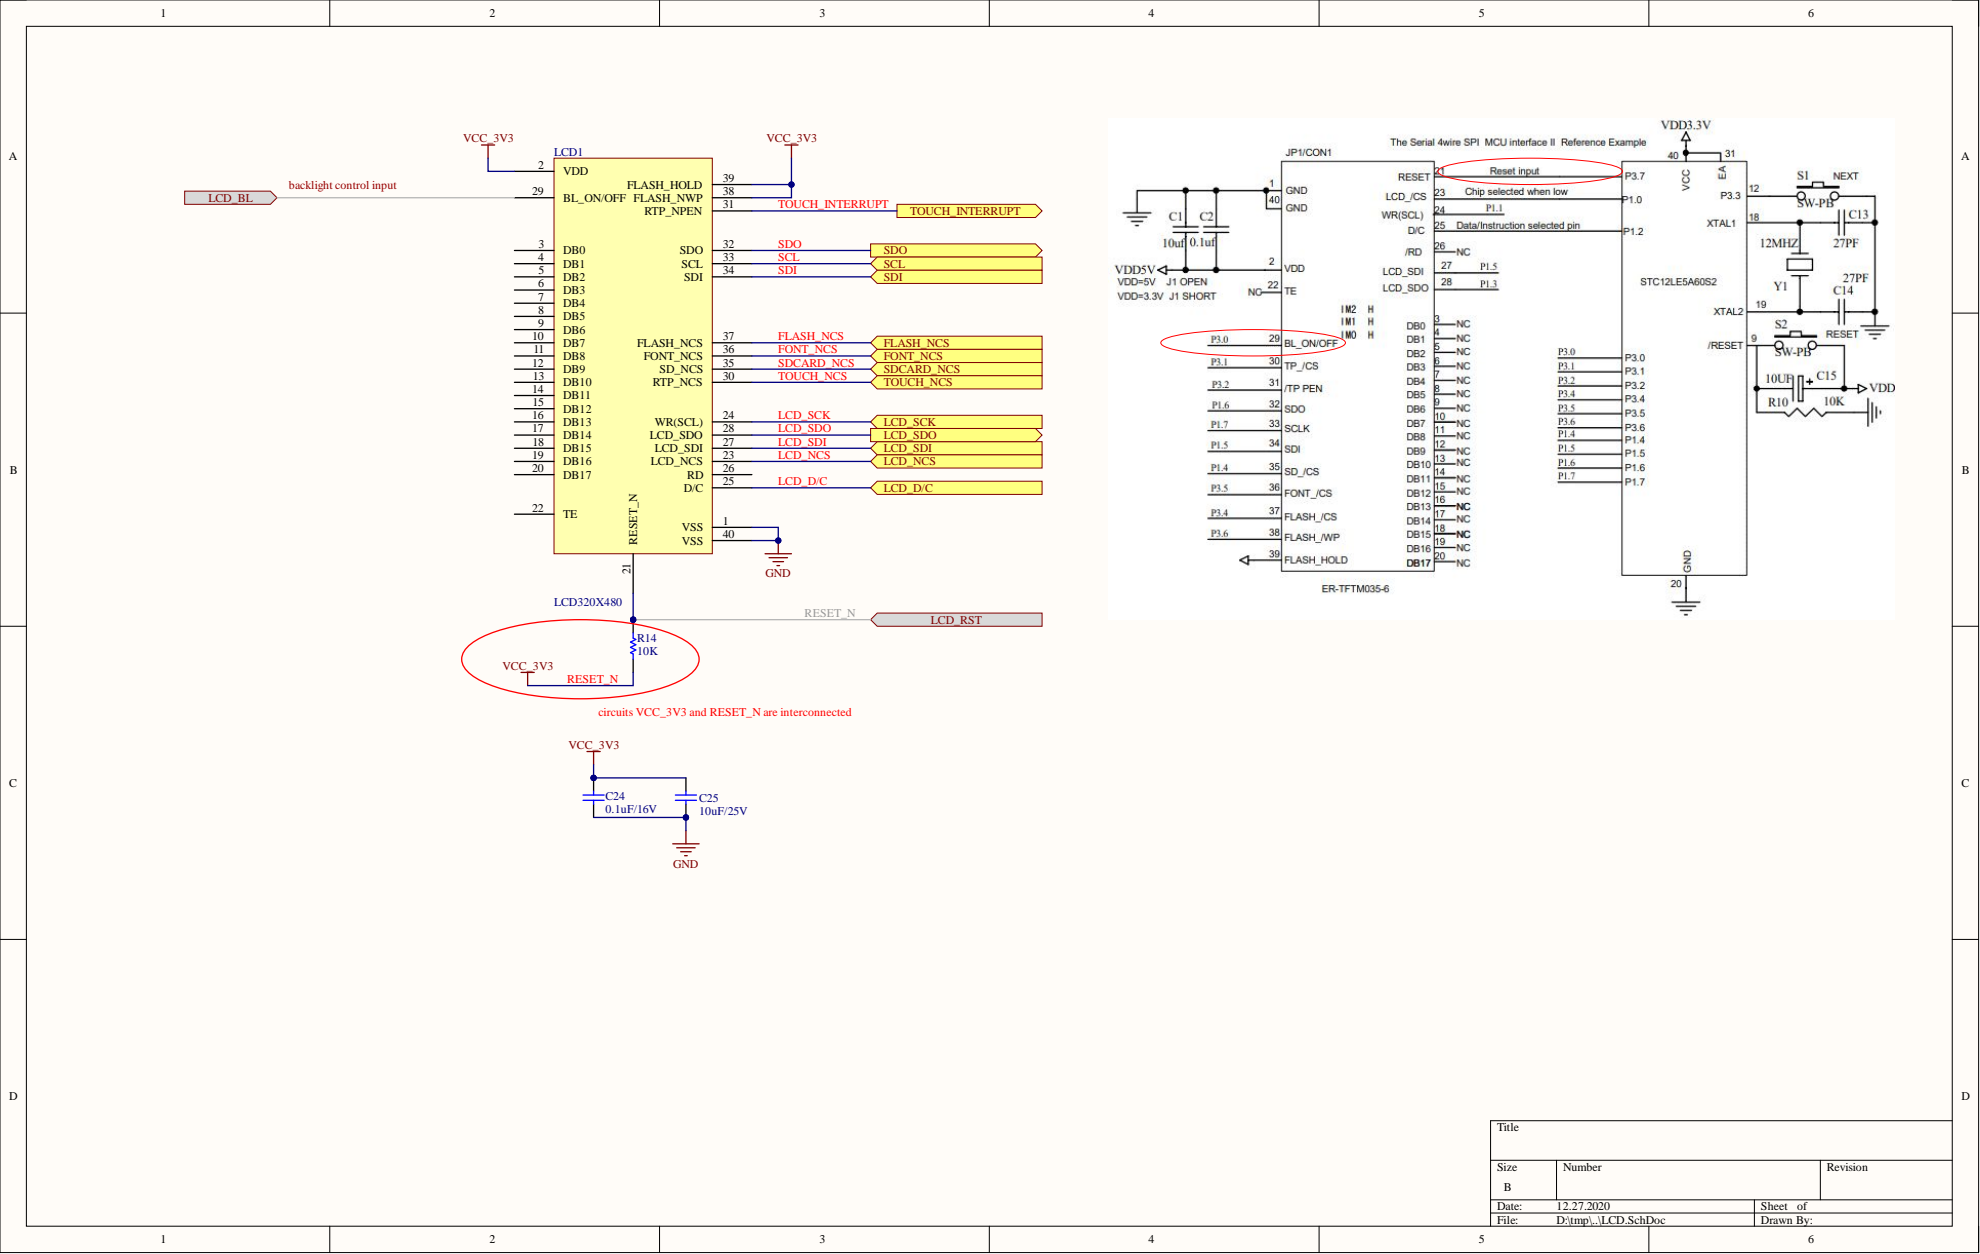
[picture p18: page 3]

circuits VCC_3V3 and RESET_N are interconnected

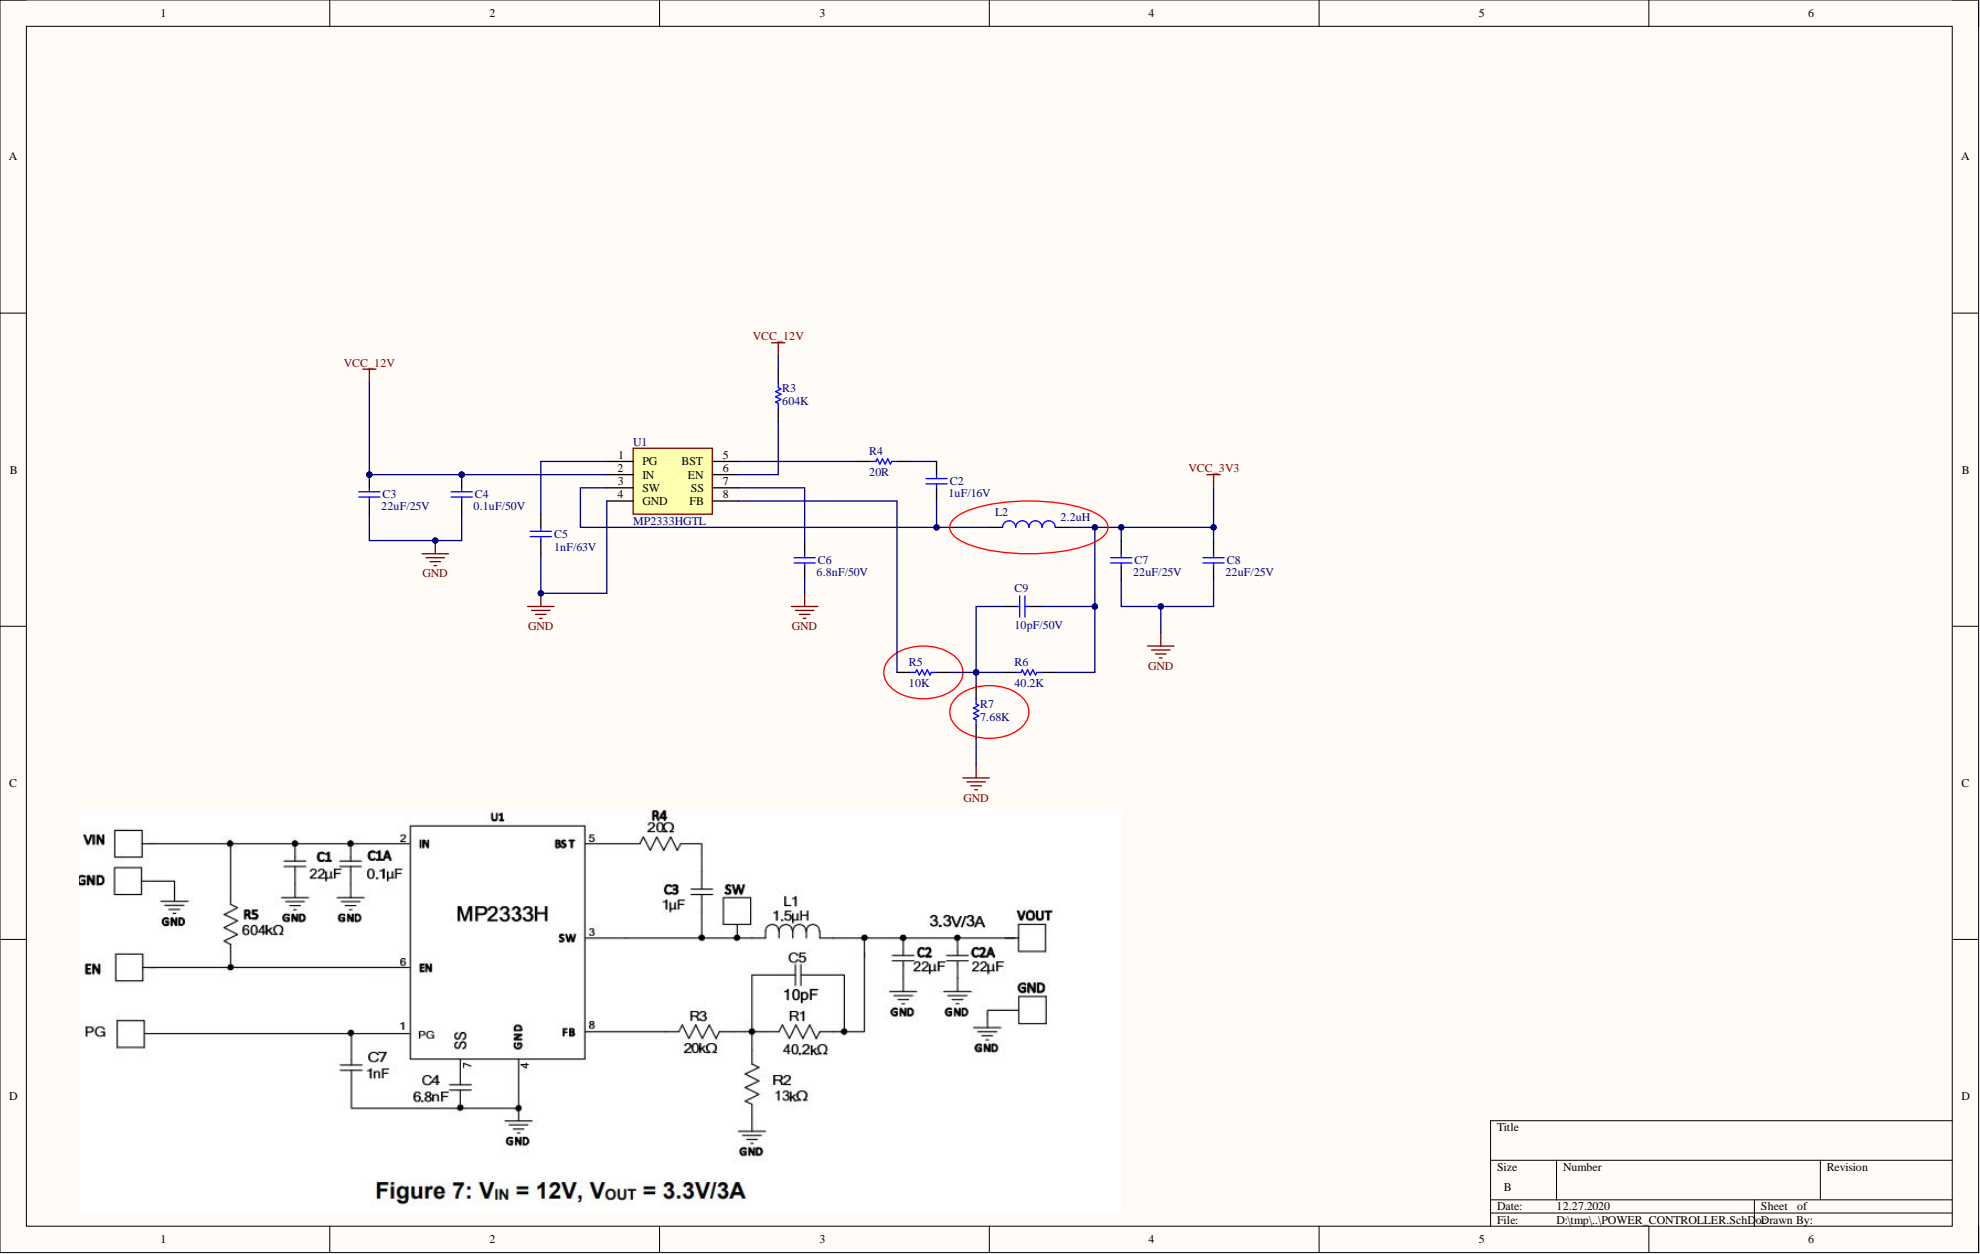
[picture p19: page 4]

4 | G N D FB | 8 | | 1 6 V

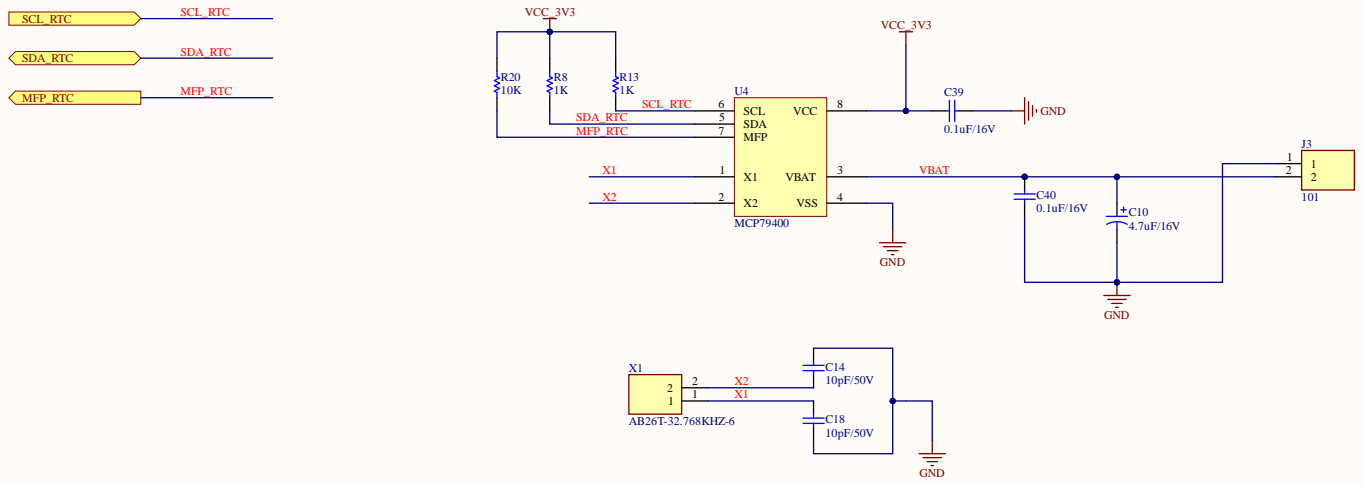
[picture p20: page 5]

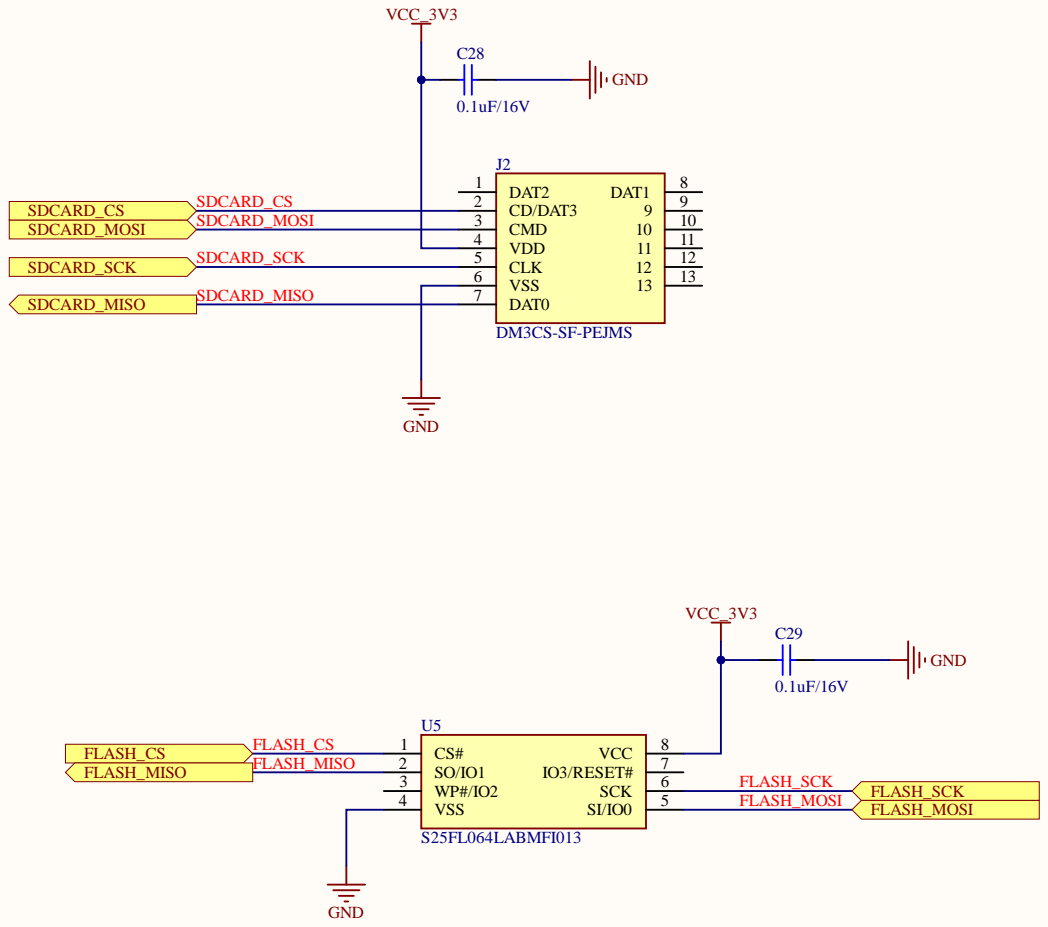
[picture p21: page 6]

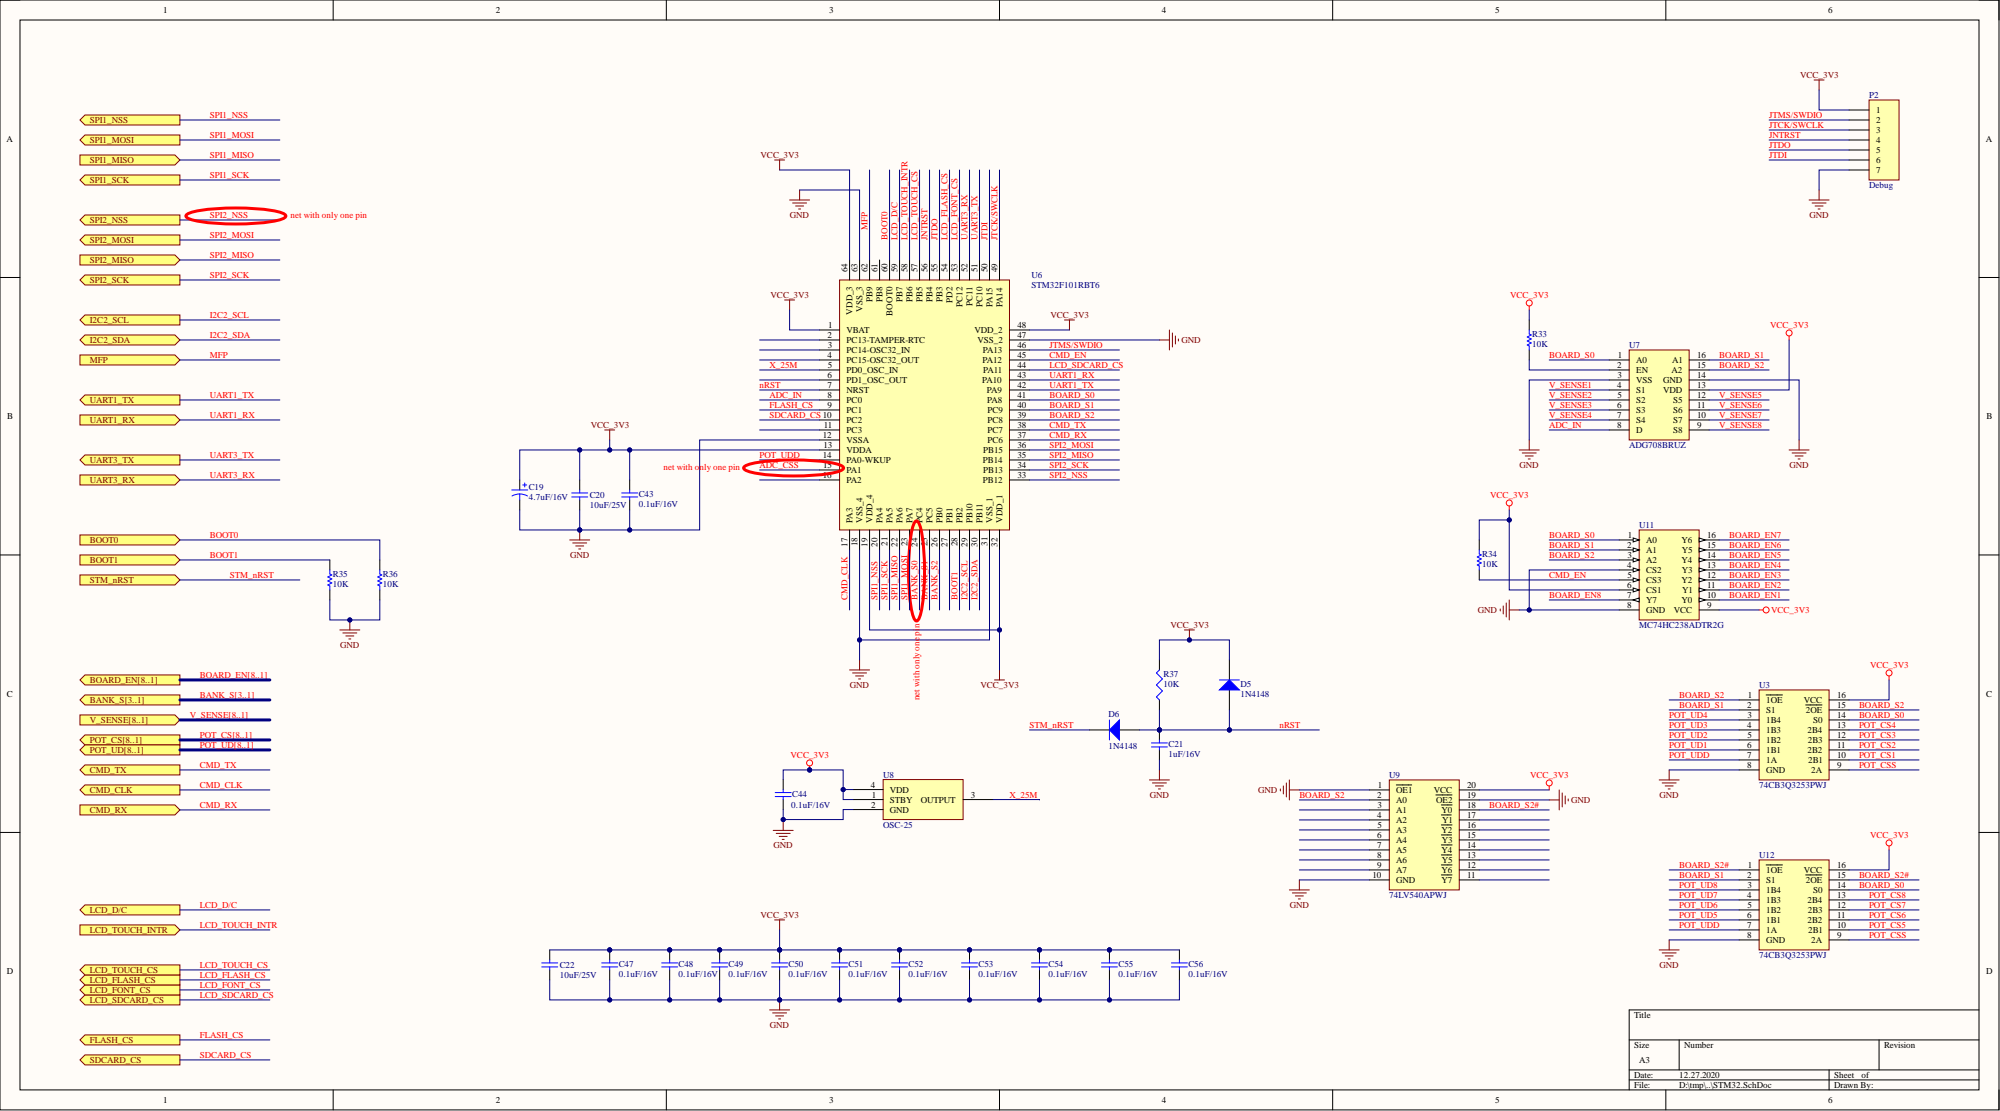
[picture p22: page 7]

PO T_ U D D net w i t h o n l y o ne p i n A C4 3 0.1 uF/ 1 6 V

CMD _ E N | 5

BO ARD _ E N 8 | 7 8

net with only one pin

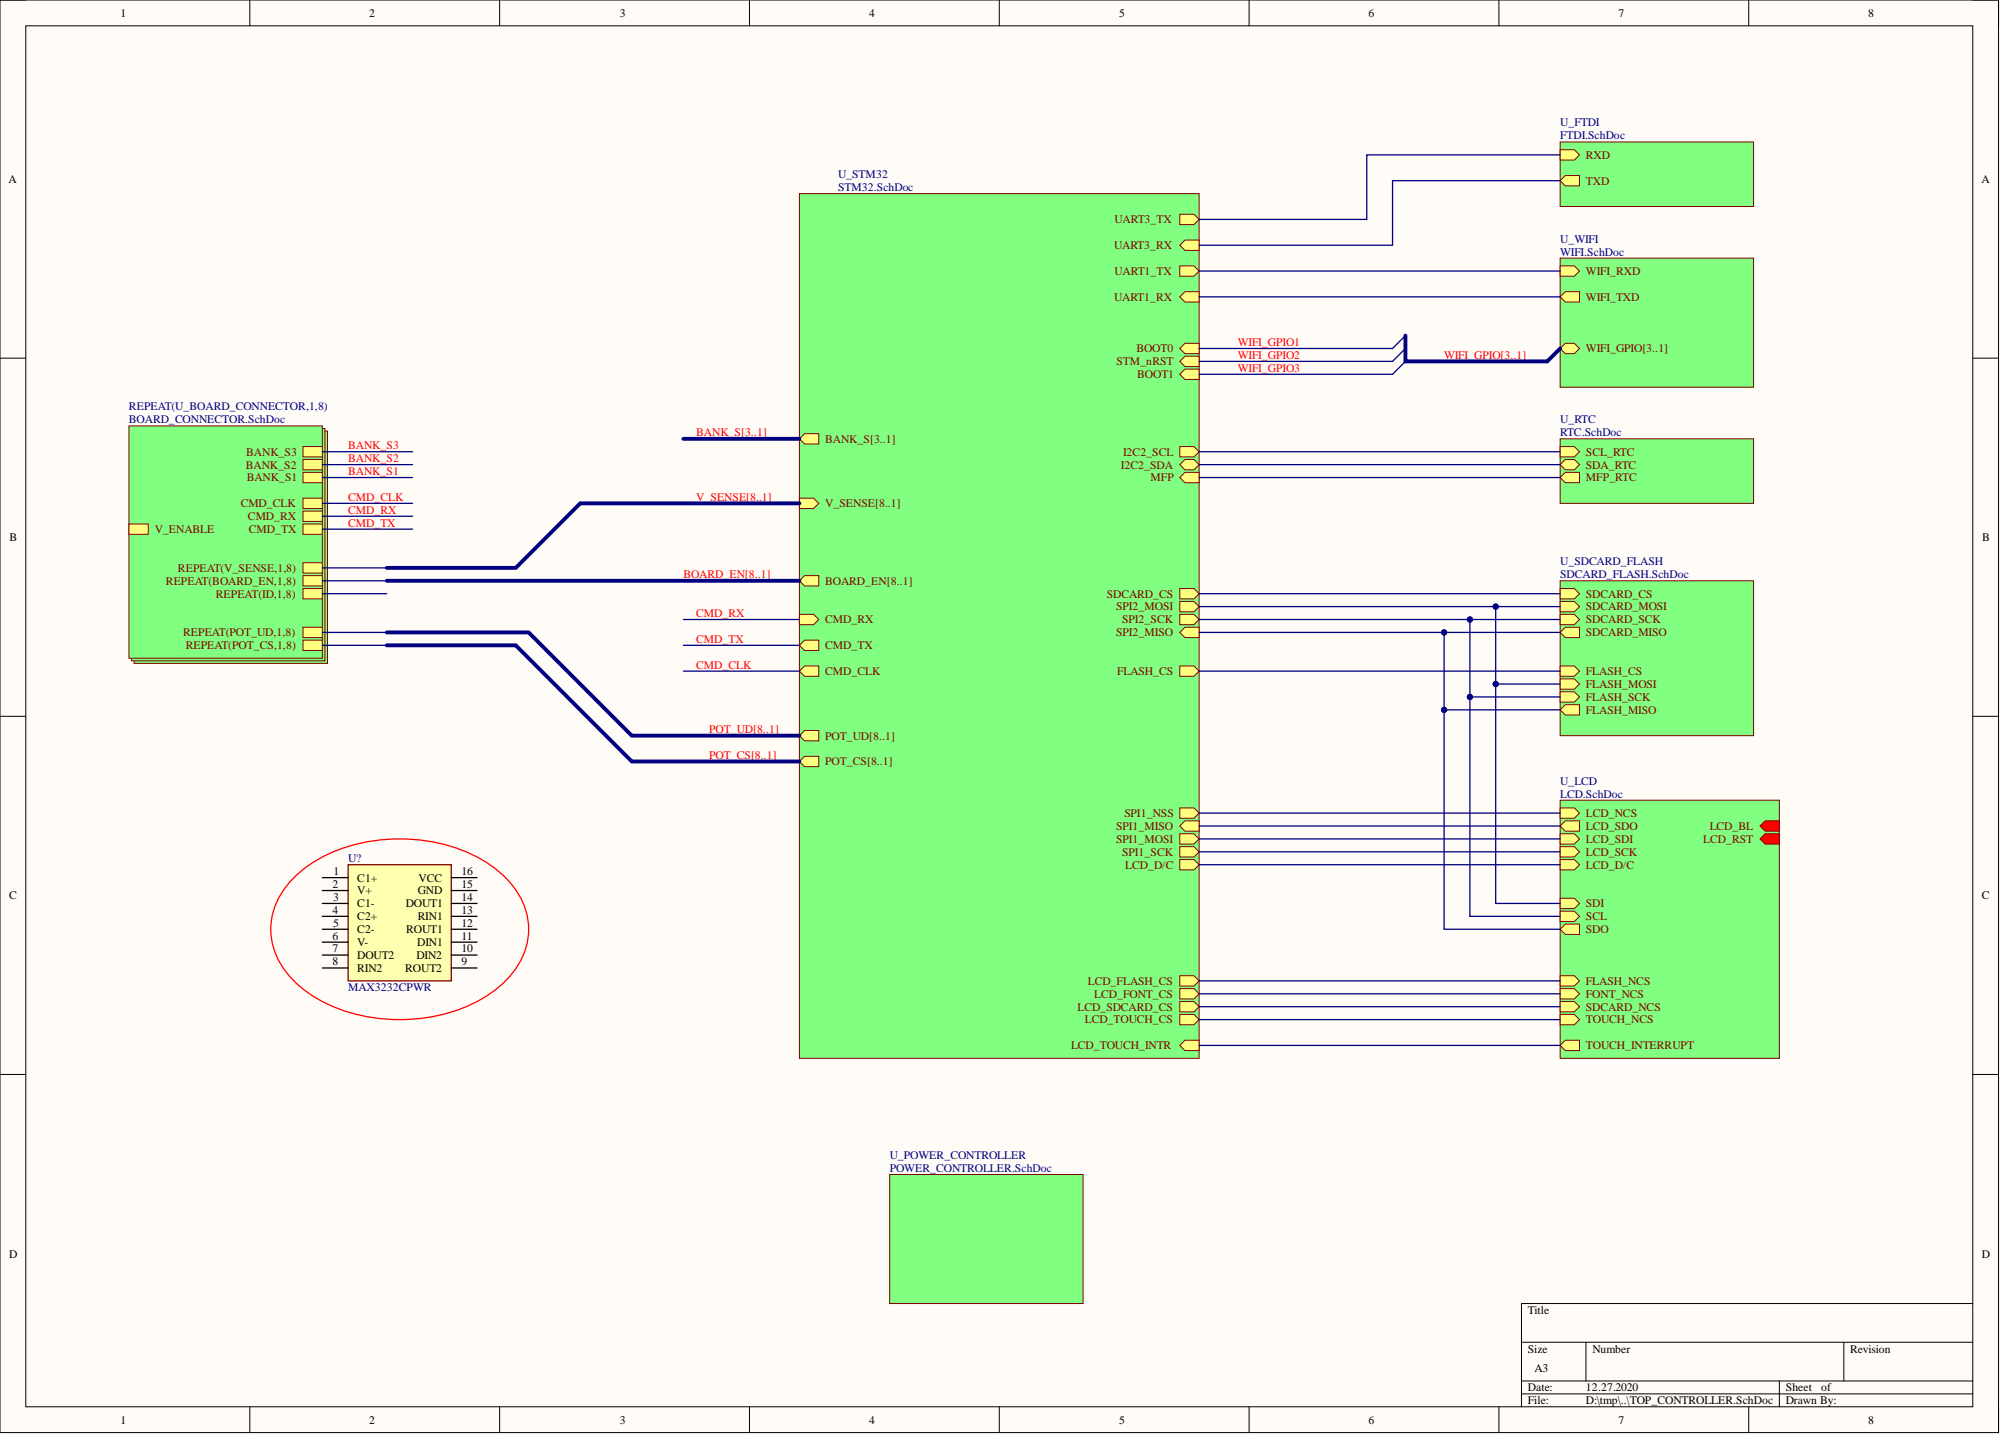
[picture p23: page 8]

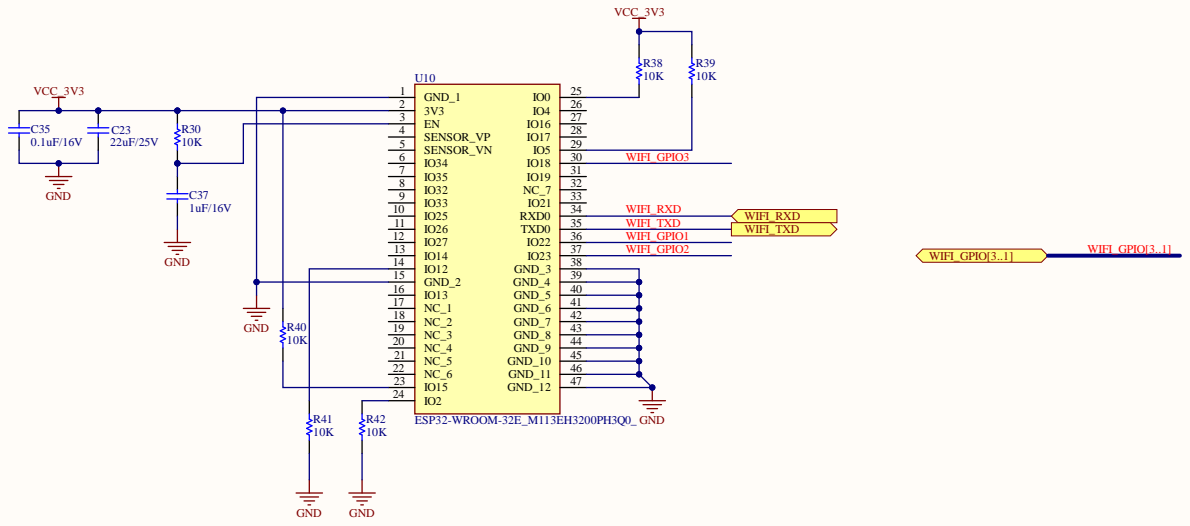
[picture p24: page 9]

GND_2 15
IO13 16
NC_1 17
