haseebulhassan/Project-C/Project-C/Project-C_Controller/Project-C_CONTOLLER.pdf

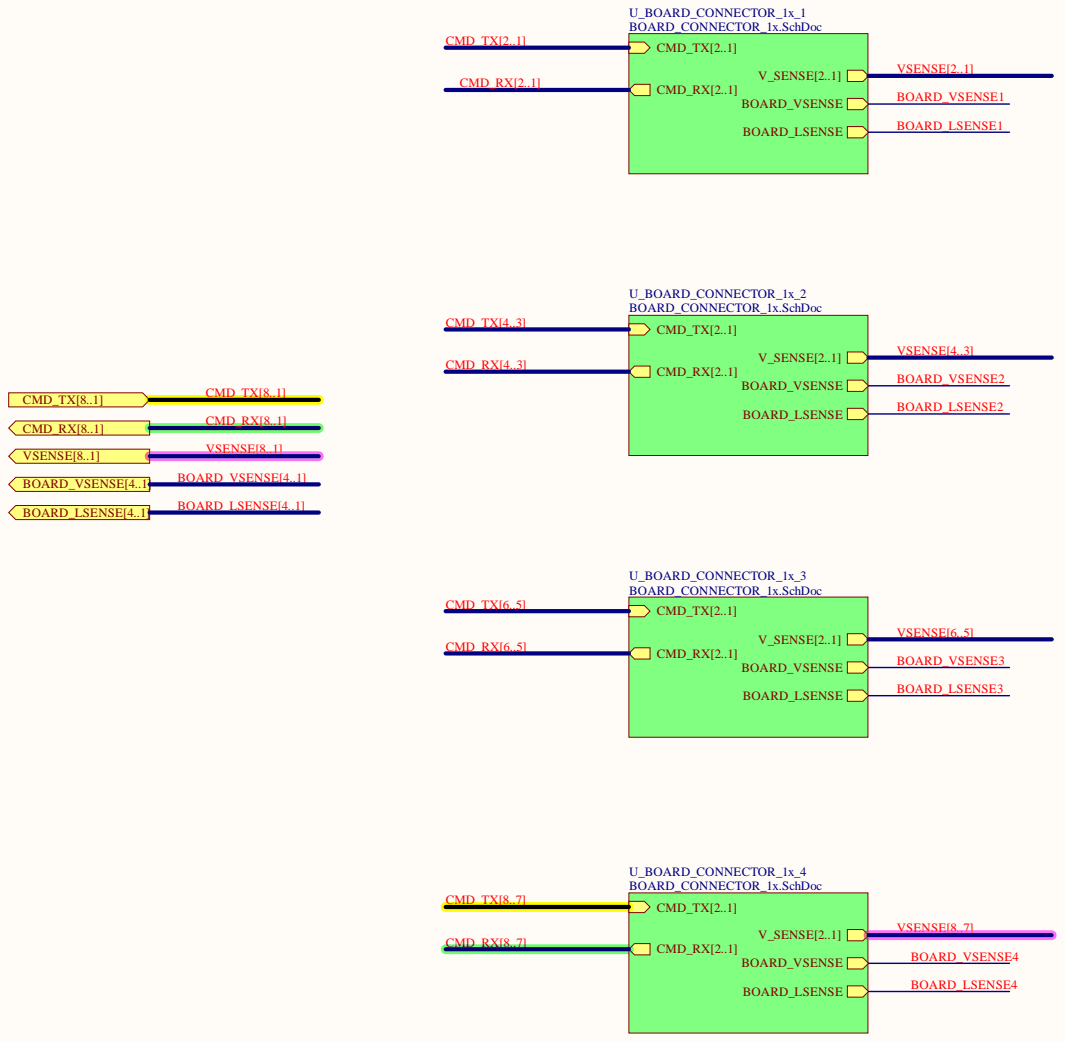
[picture p25: page 1]

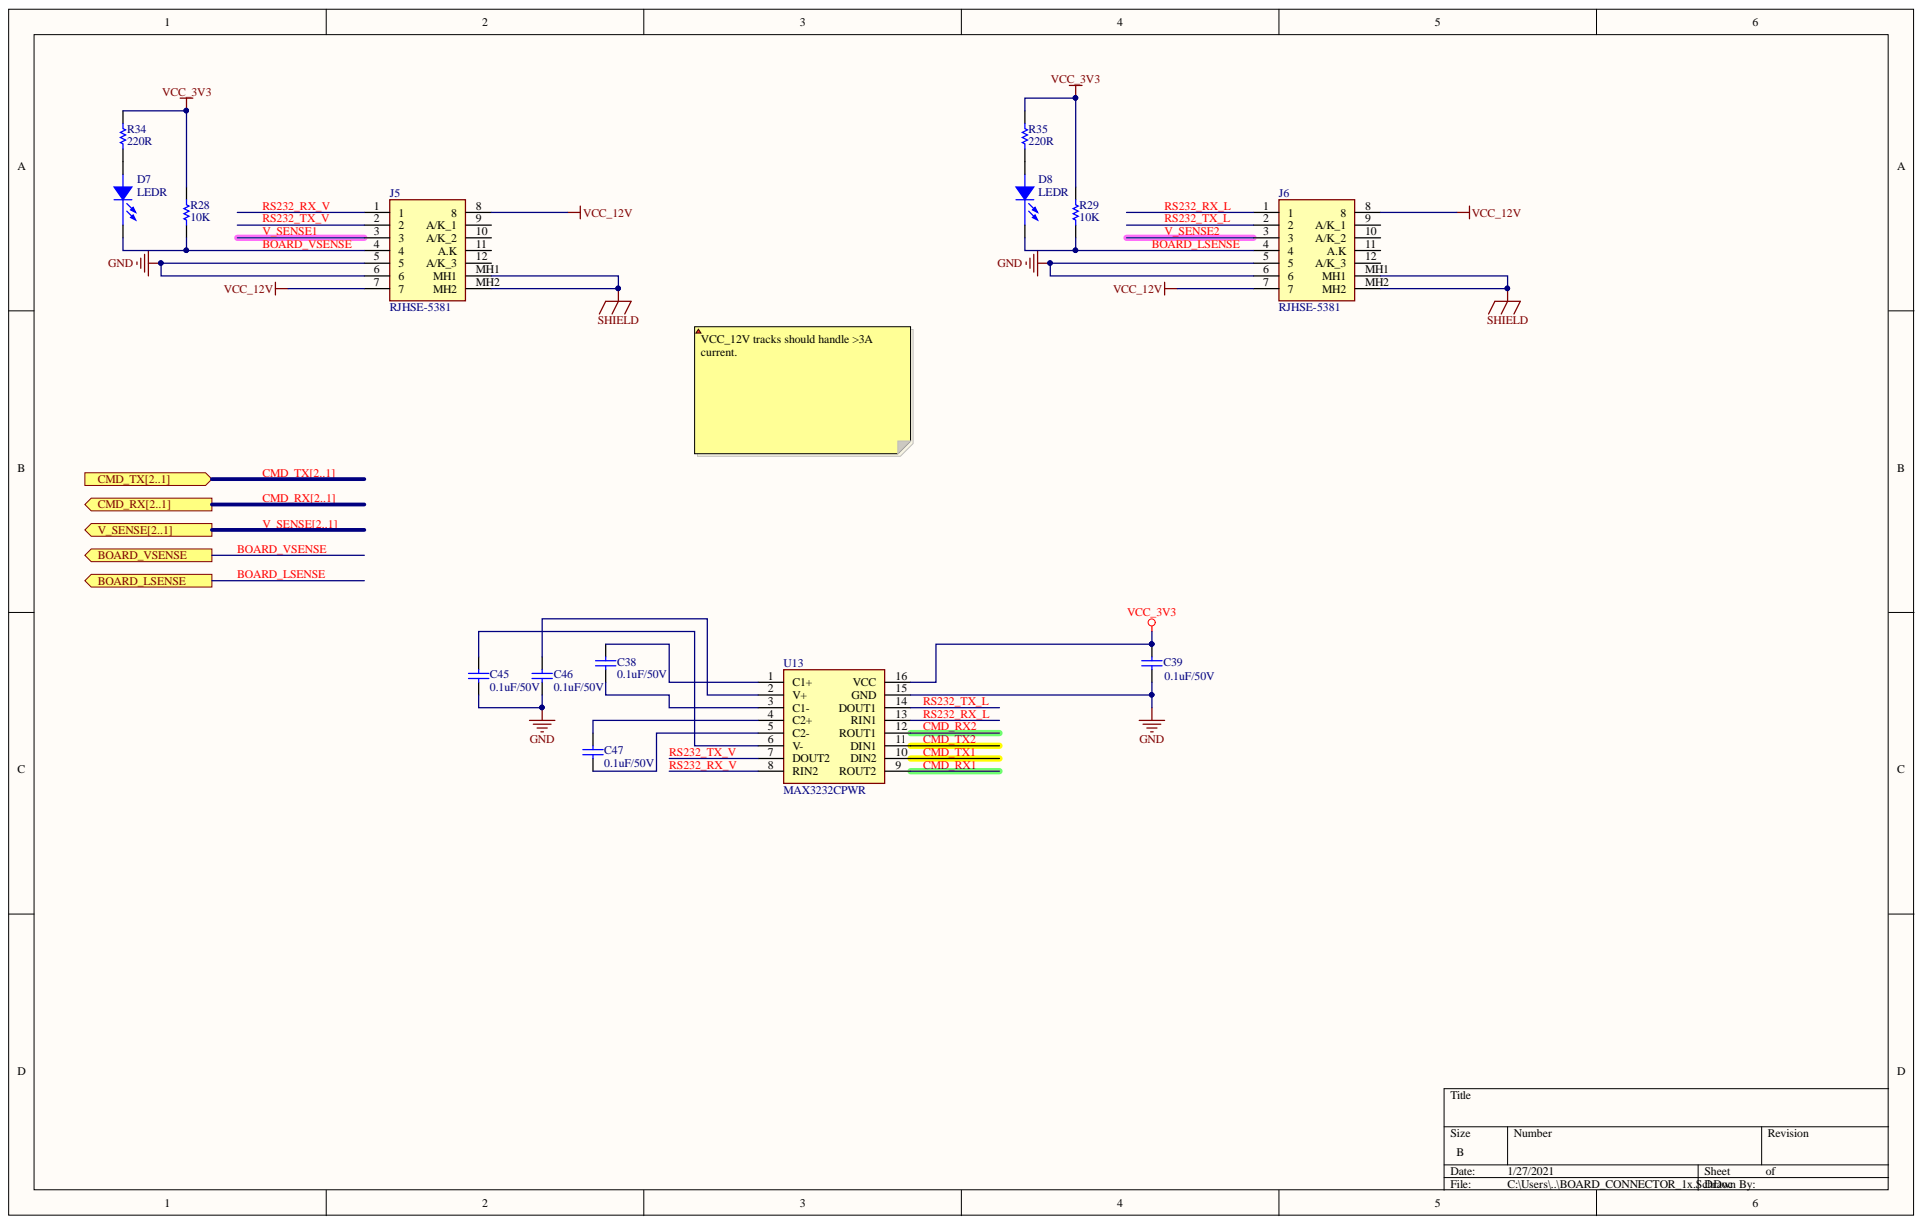
[picture p26: page 2]

C2- 5
V- 6

RS232_TX_V 0.1uF/50V RS232_RX_V | DOUT2 7 RIN2 8

Size B | Number | Revision

Date: 1/27/2021 | Sheet of
File: C:\Users\..\BOARD_CONNECTOR_1x.SchDDrawocn By:

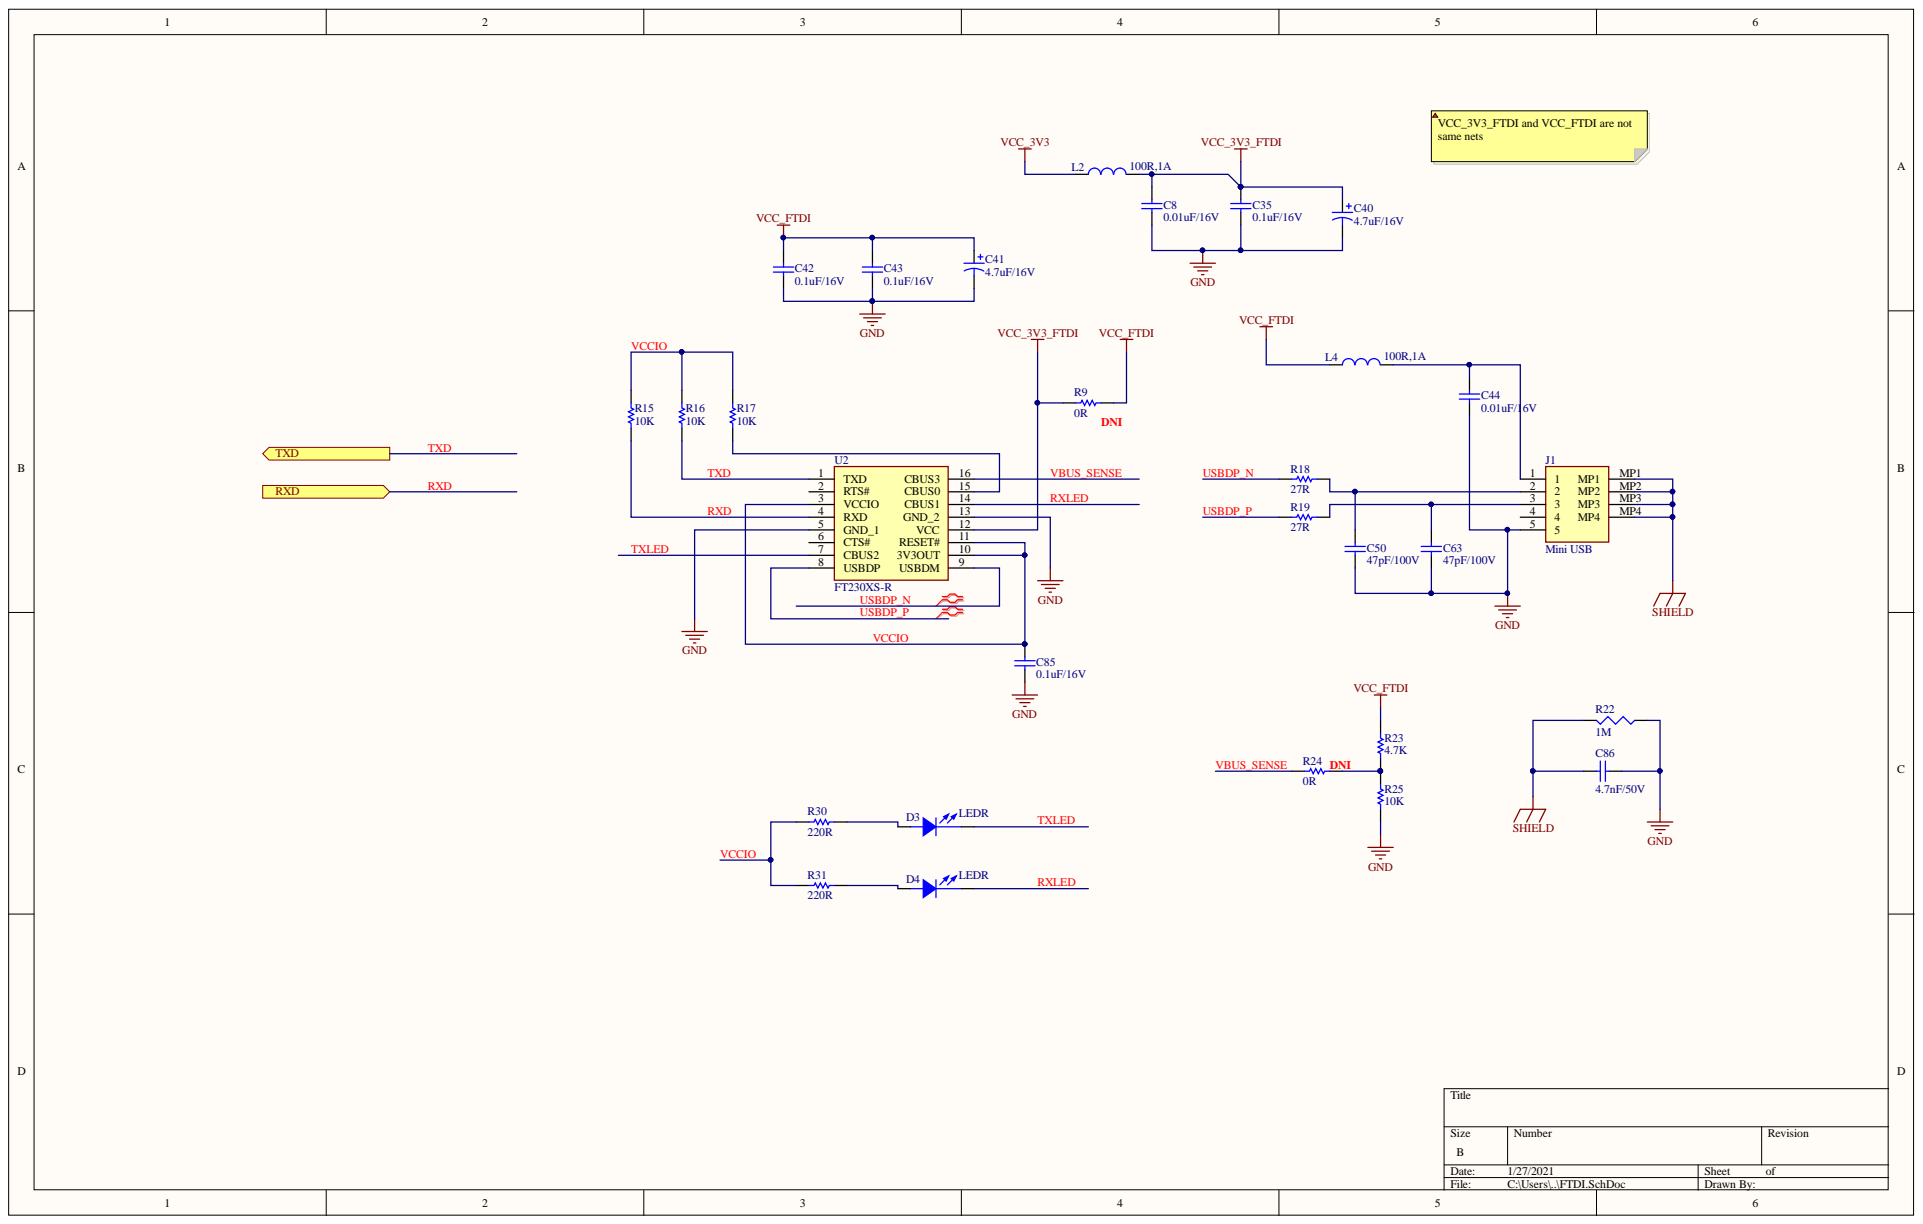
[picture p27: page 3]

Size B | Number | Revision

Date: 1/27/2021 | Sheet of
File: C:\Users\..\FTDI.SchDoc | Drawn By:

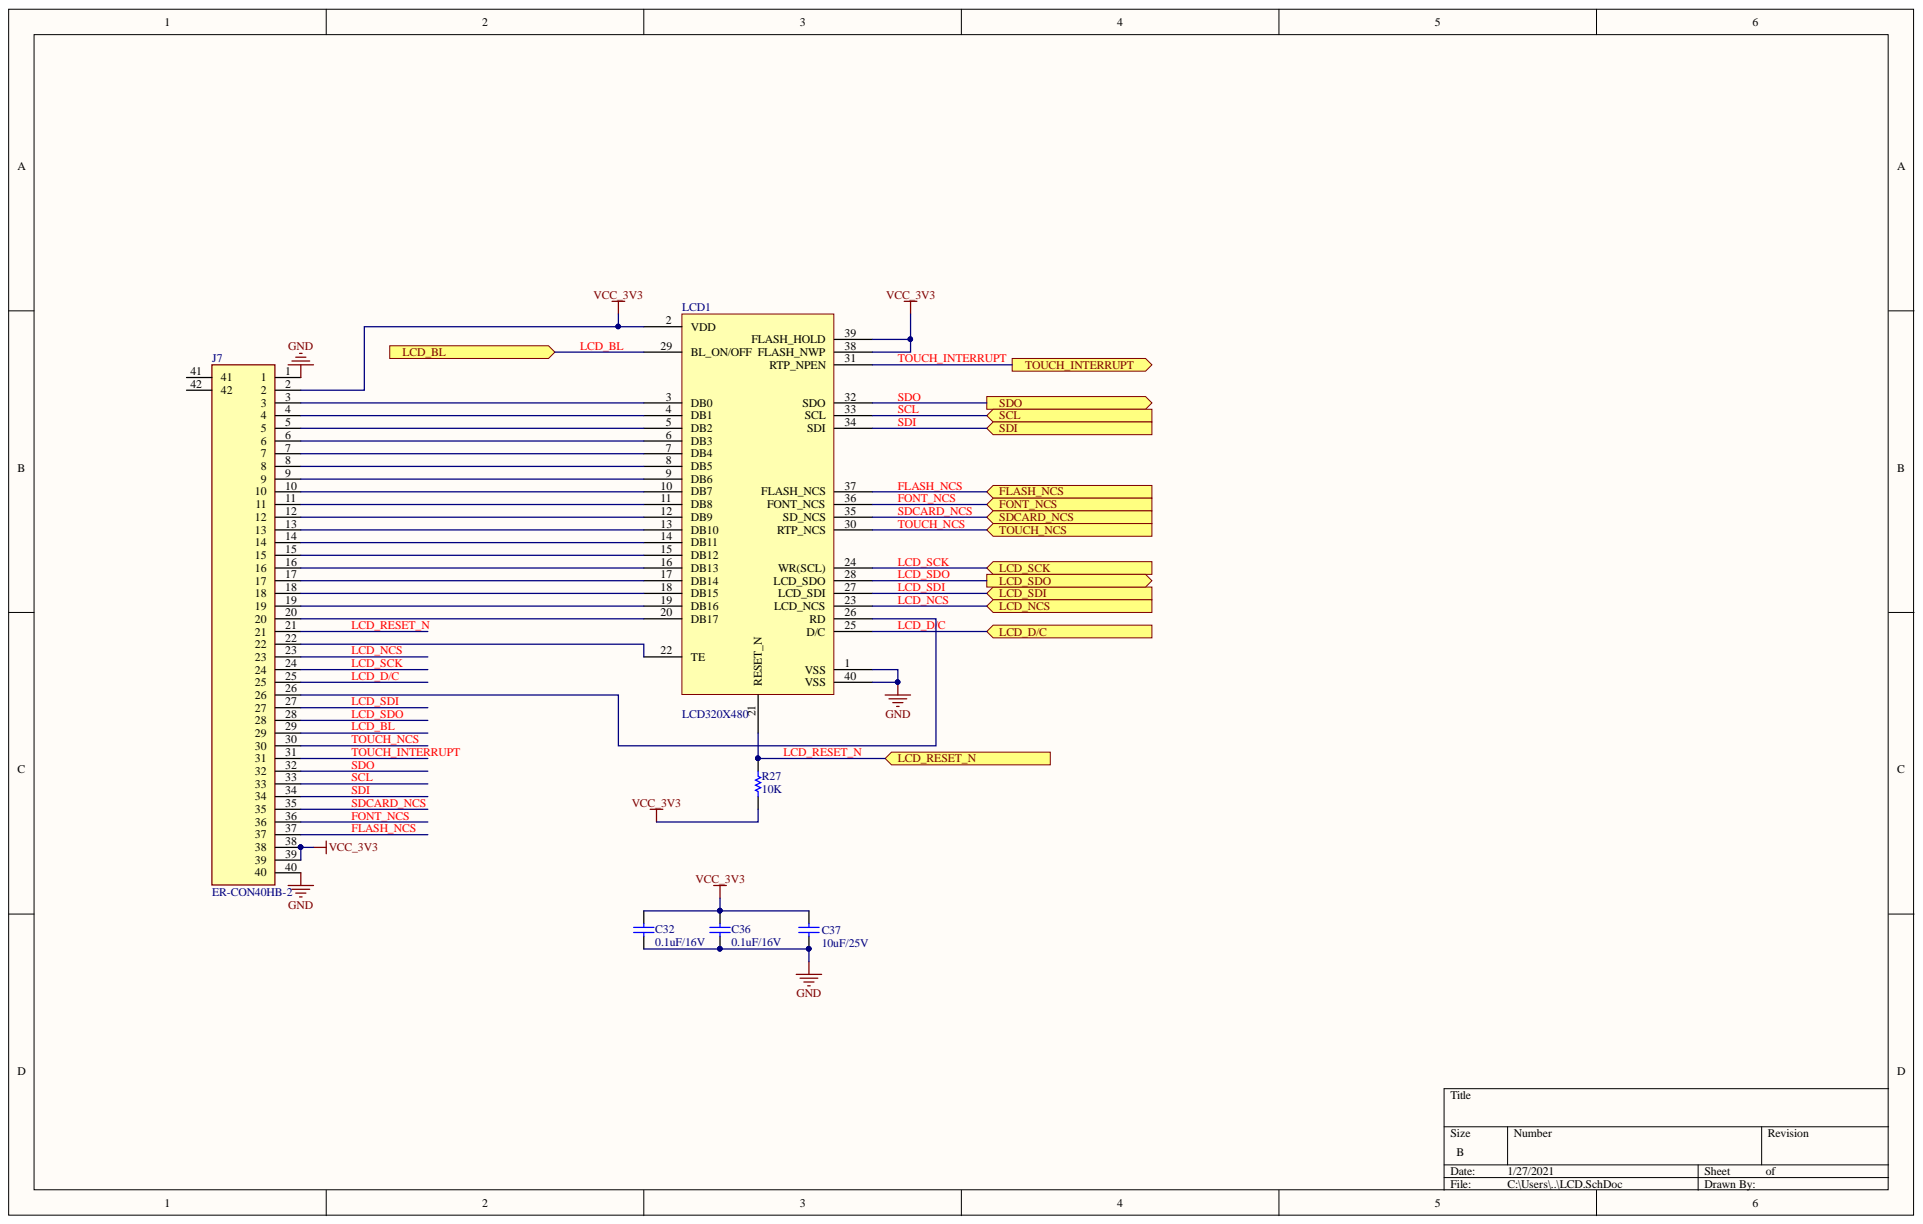
[picture p28: page 4]

Size B | Number | Revision

Date: 1/27/2021 | Sheet of
File: C:\Users\..\LCD.SchDoc | Drawn By:

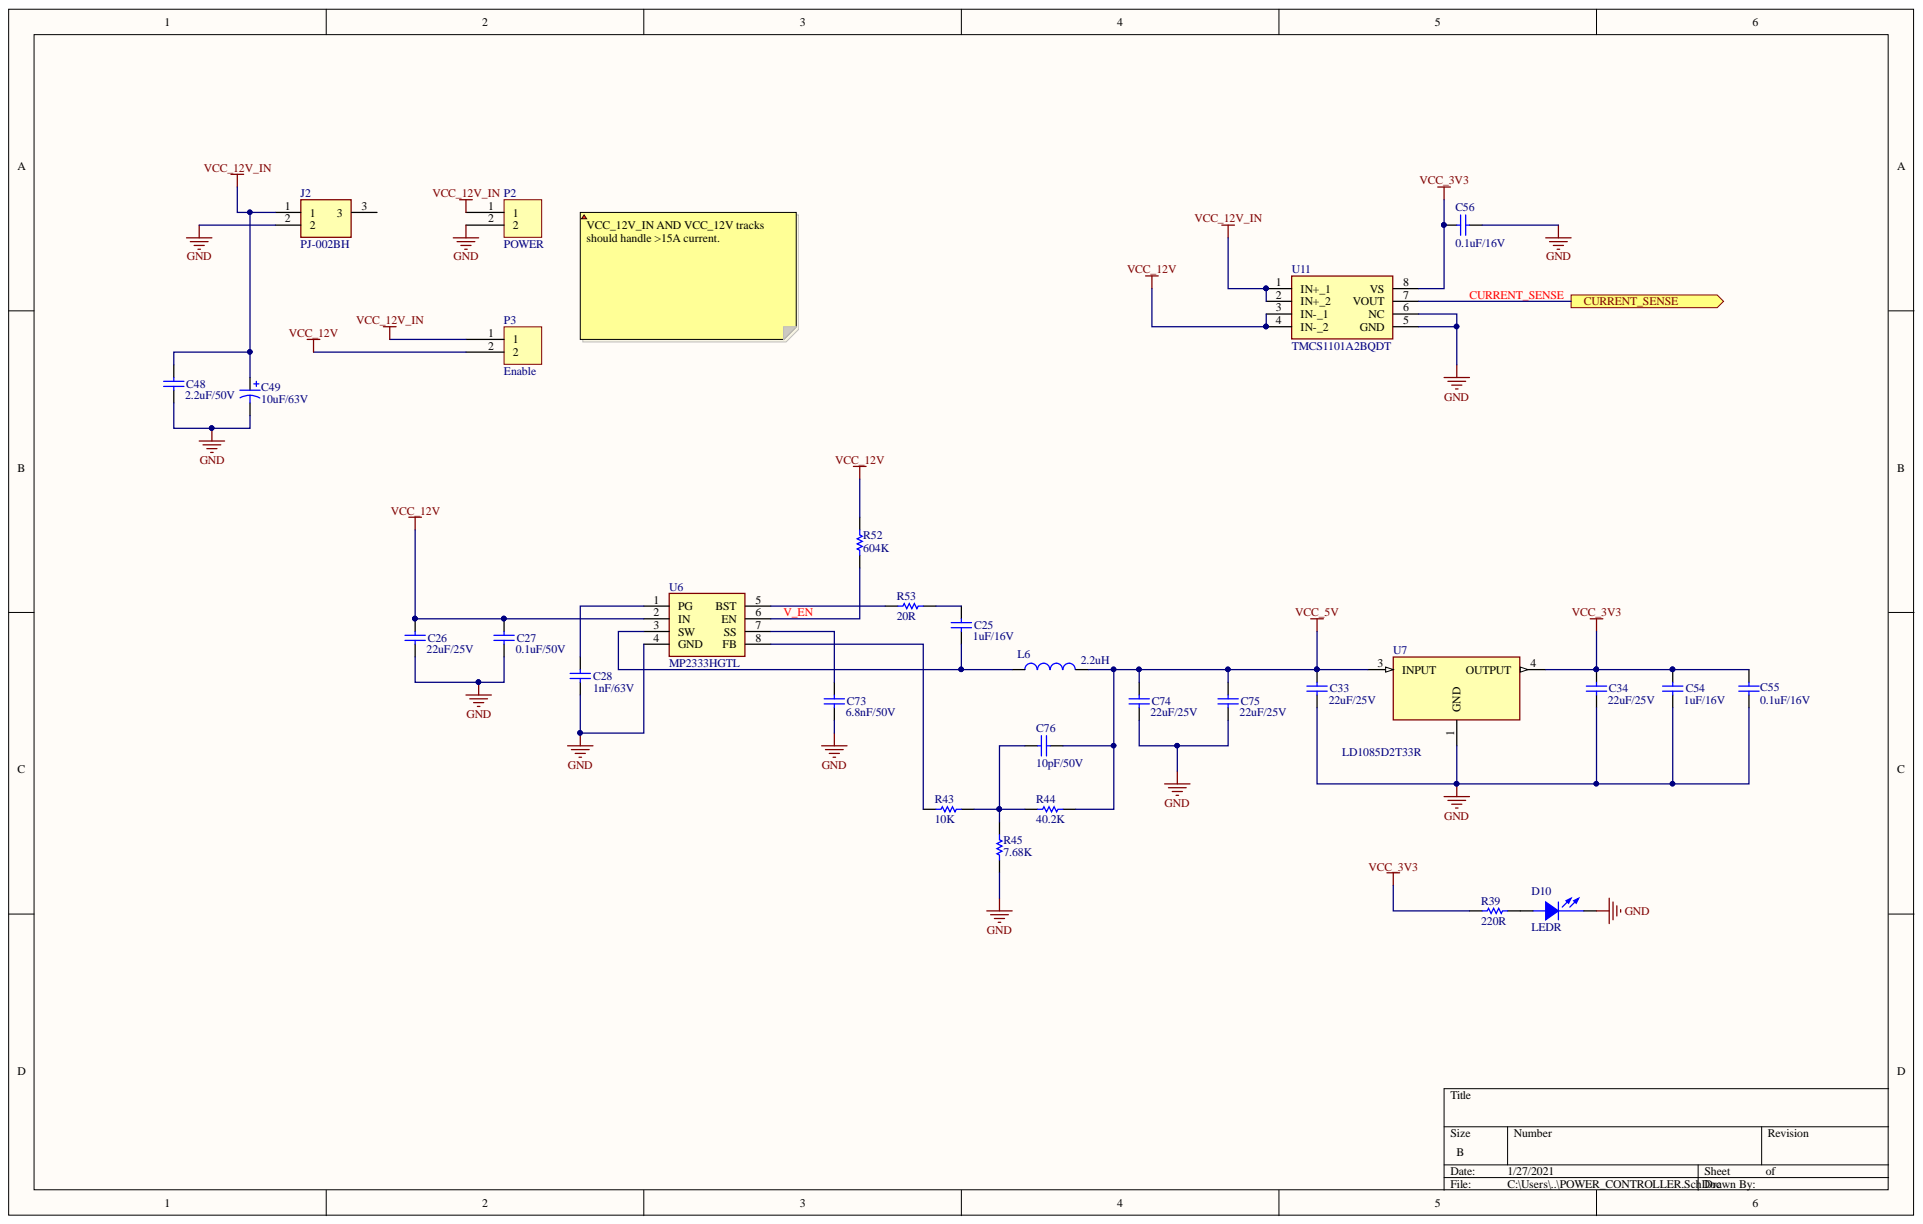
[picture p29: page 5]

GND 4 FB | 8 | 1uF/16V

Size B | Number | Revision

Date: 1/27/2021 | Sheet of
File: C:\Users\..\POWER_CONTROLLER.SchDDocrawn By:

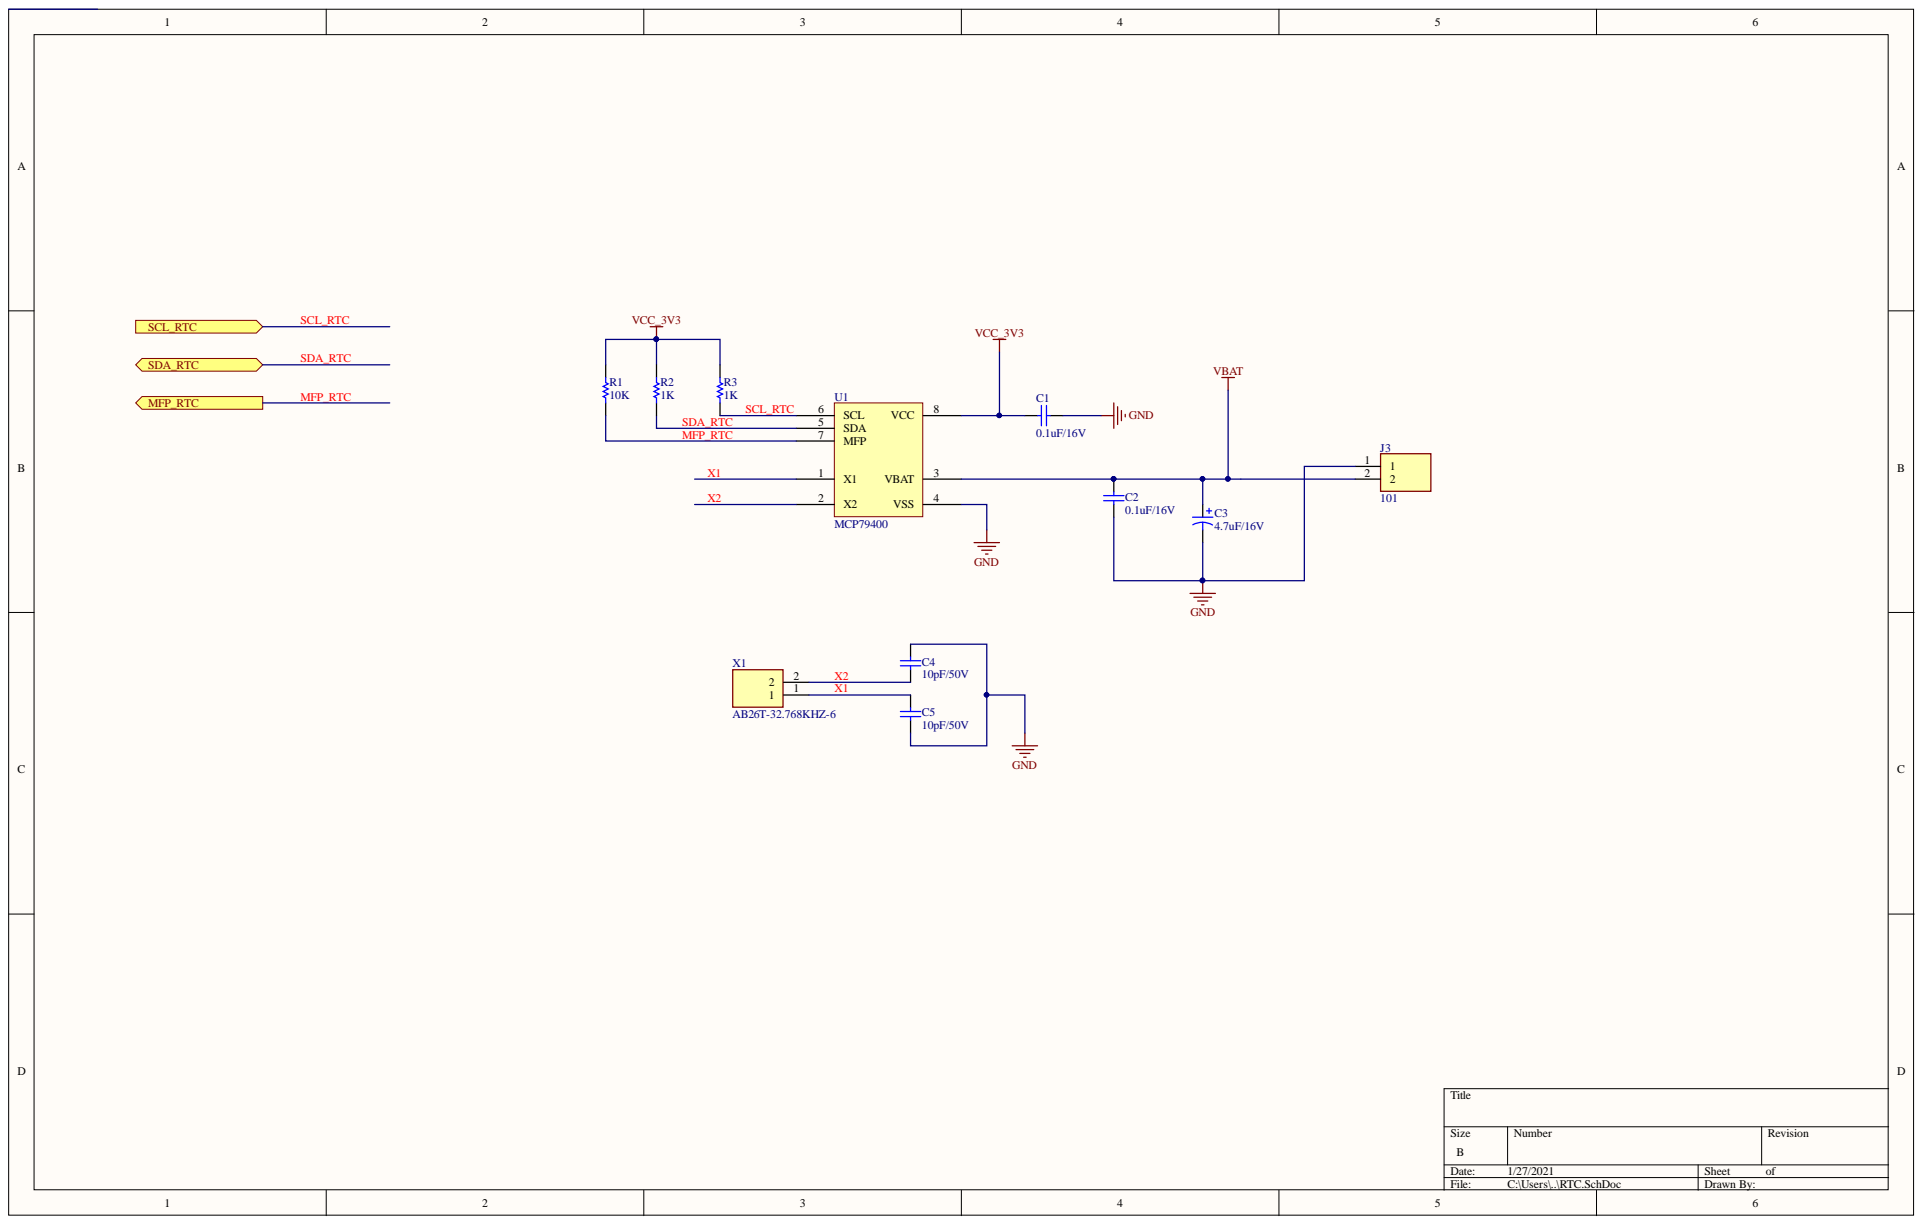
[picture p30: page 6]

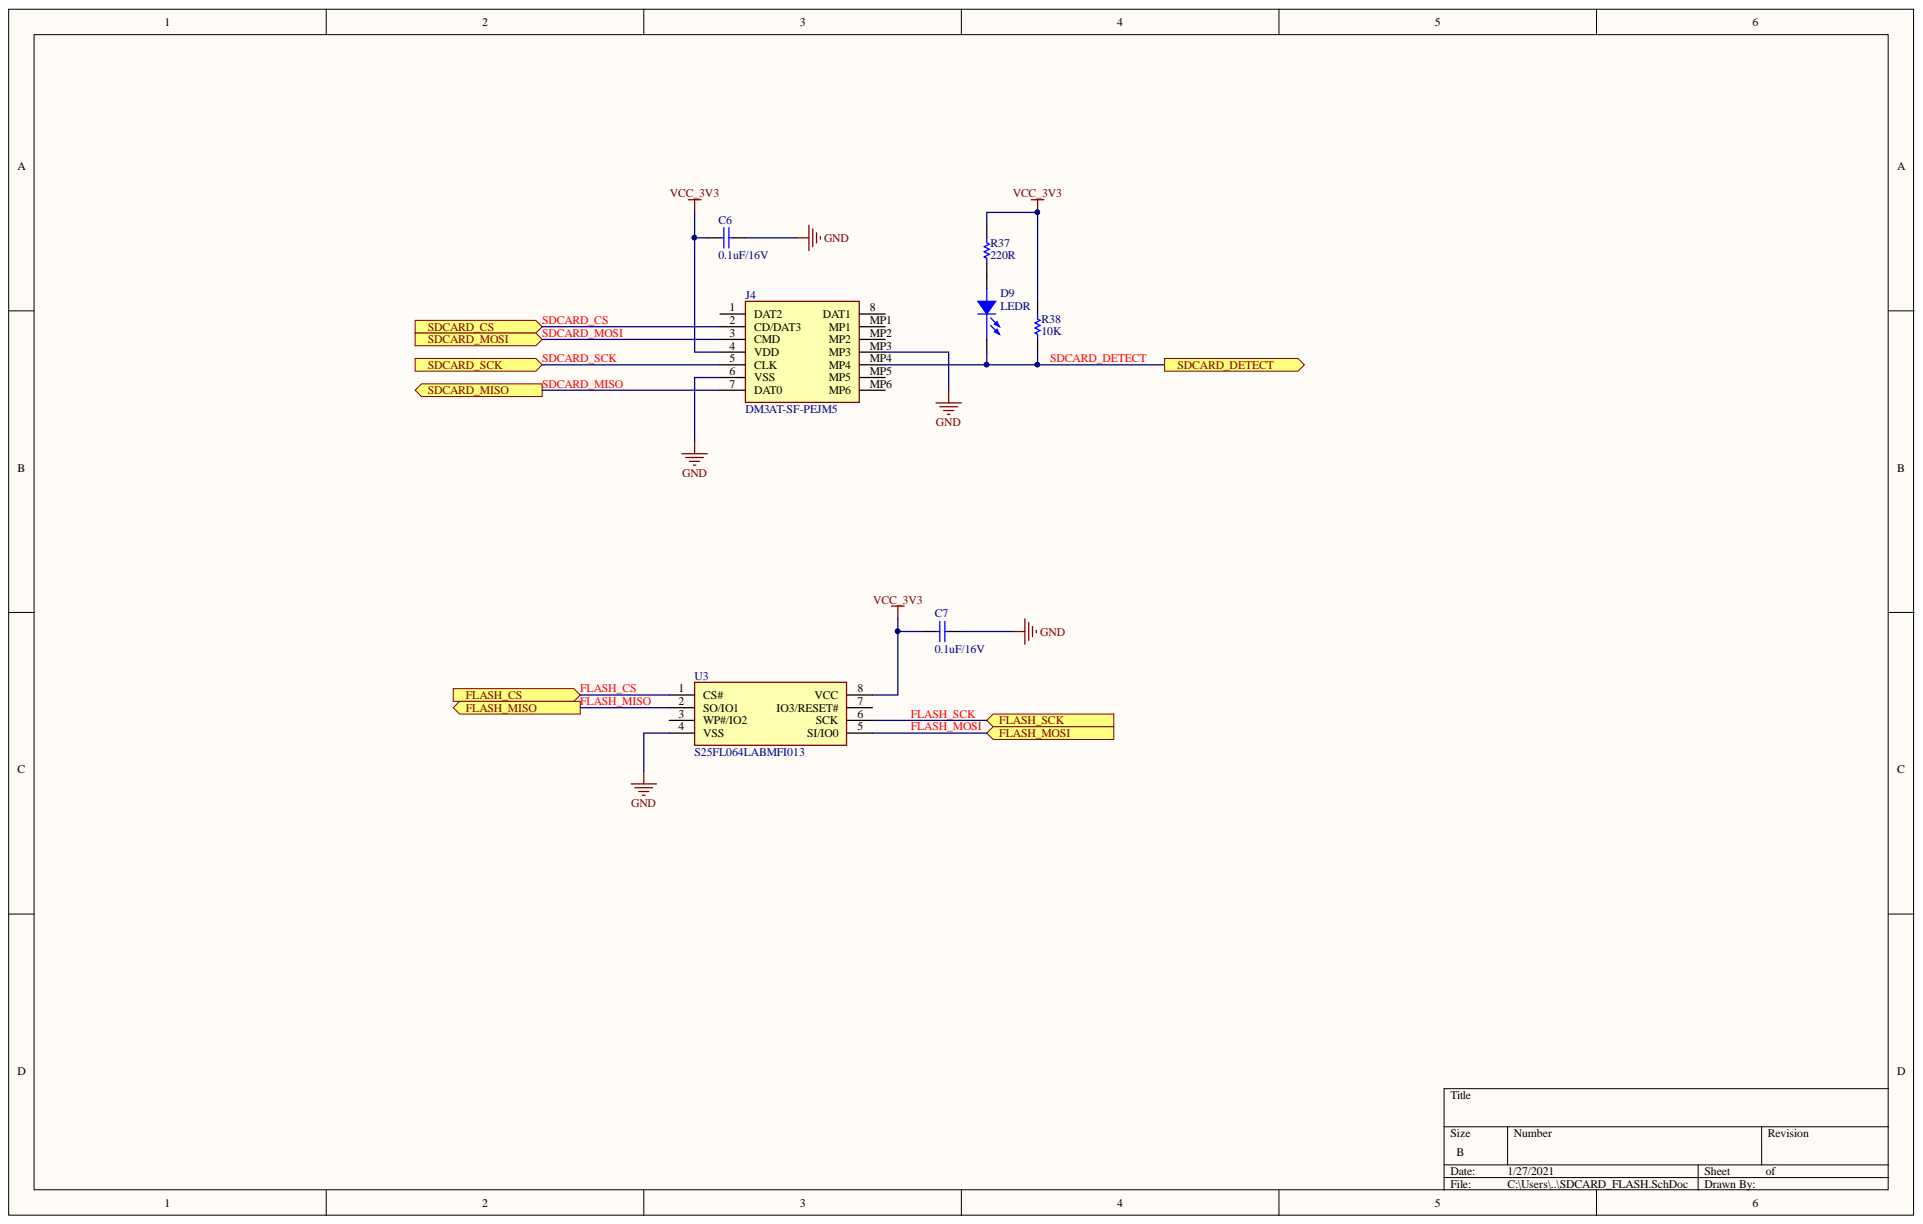
[picture p31: page 7]

Size B | Number | Revision

Date: 1/27/2021 | Sheet of
File: C:\Users\..\SDCARD_FLASH.SchDoc | Drawn By:

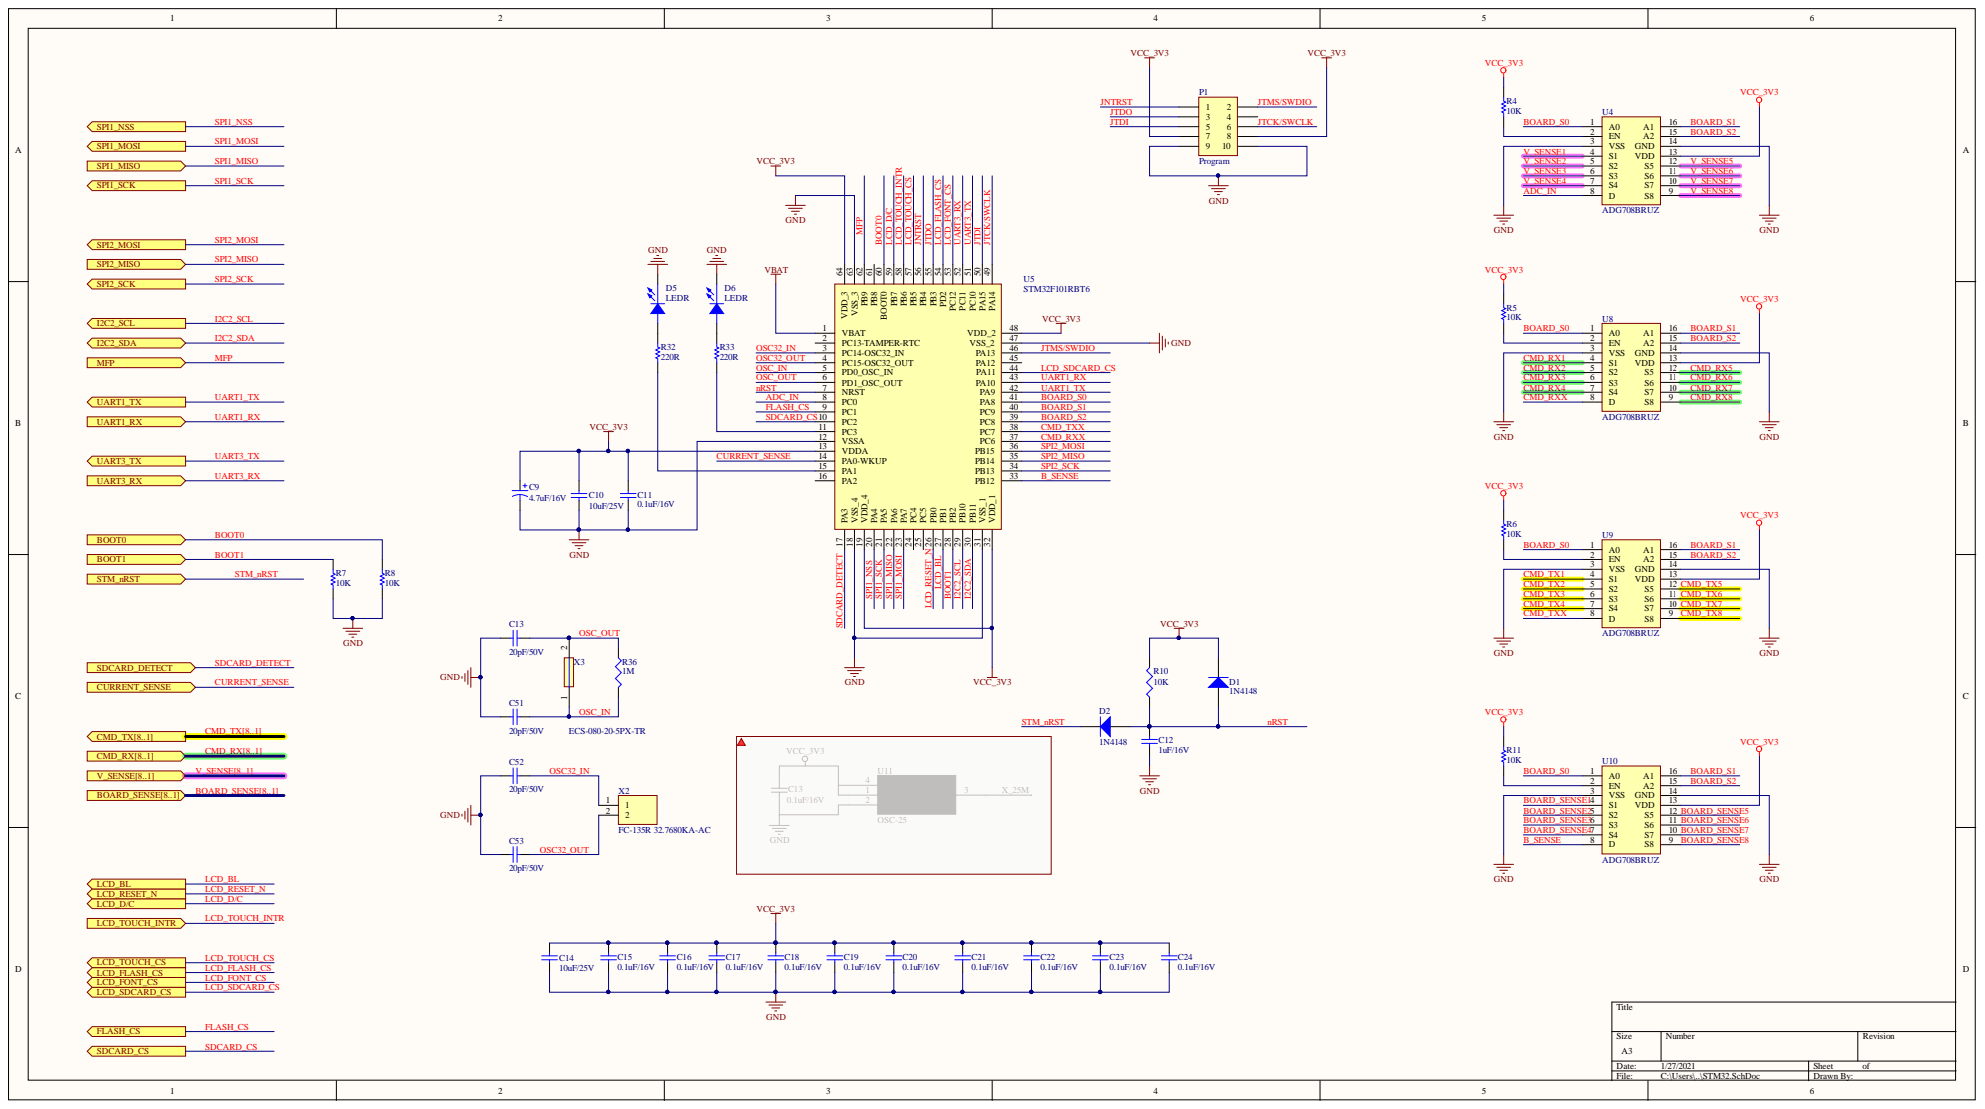
[picture p32: page 8]

2 5 V | C1 1 0 . 1 uF/ | CURRE N T _ S E N S E | 1 4

D a t e : 1 / 2 7 / 2 0 2 1 | S h e e t o f
F i l e : C: \ U s ers \ . . \ S T M 3 2 . S c hD o c | Dra w n By :

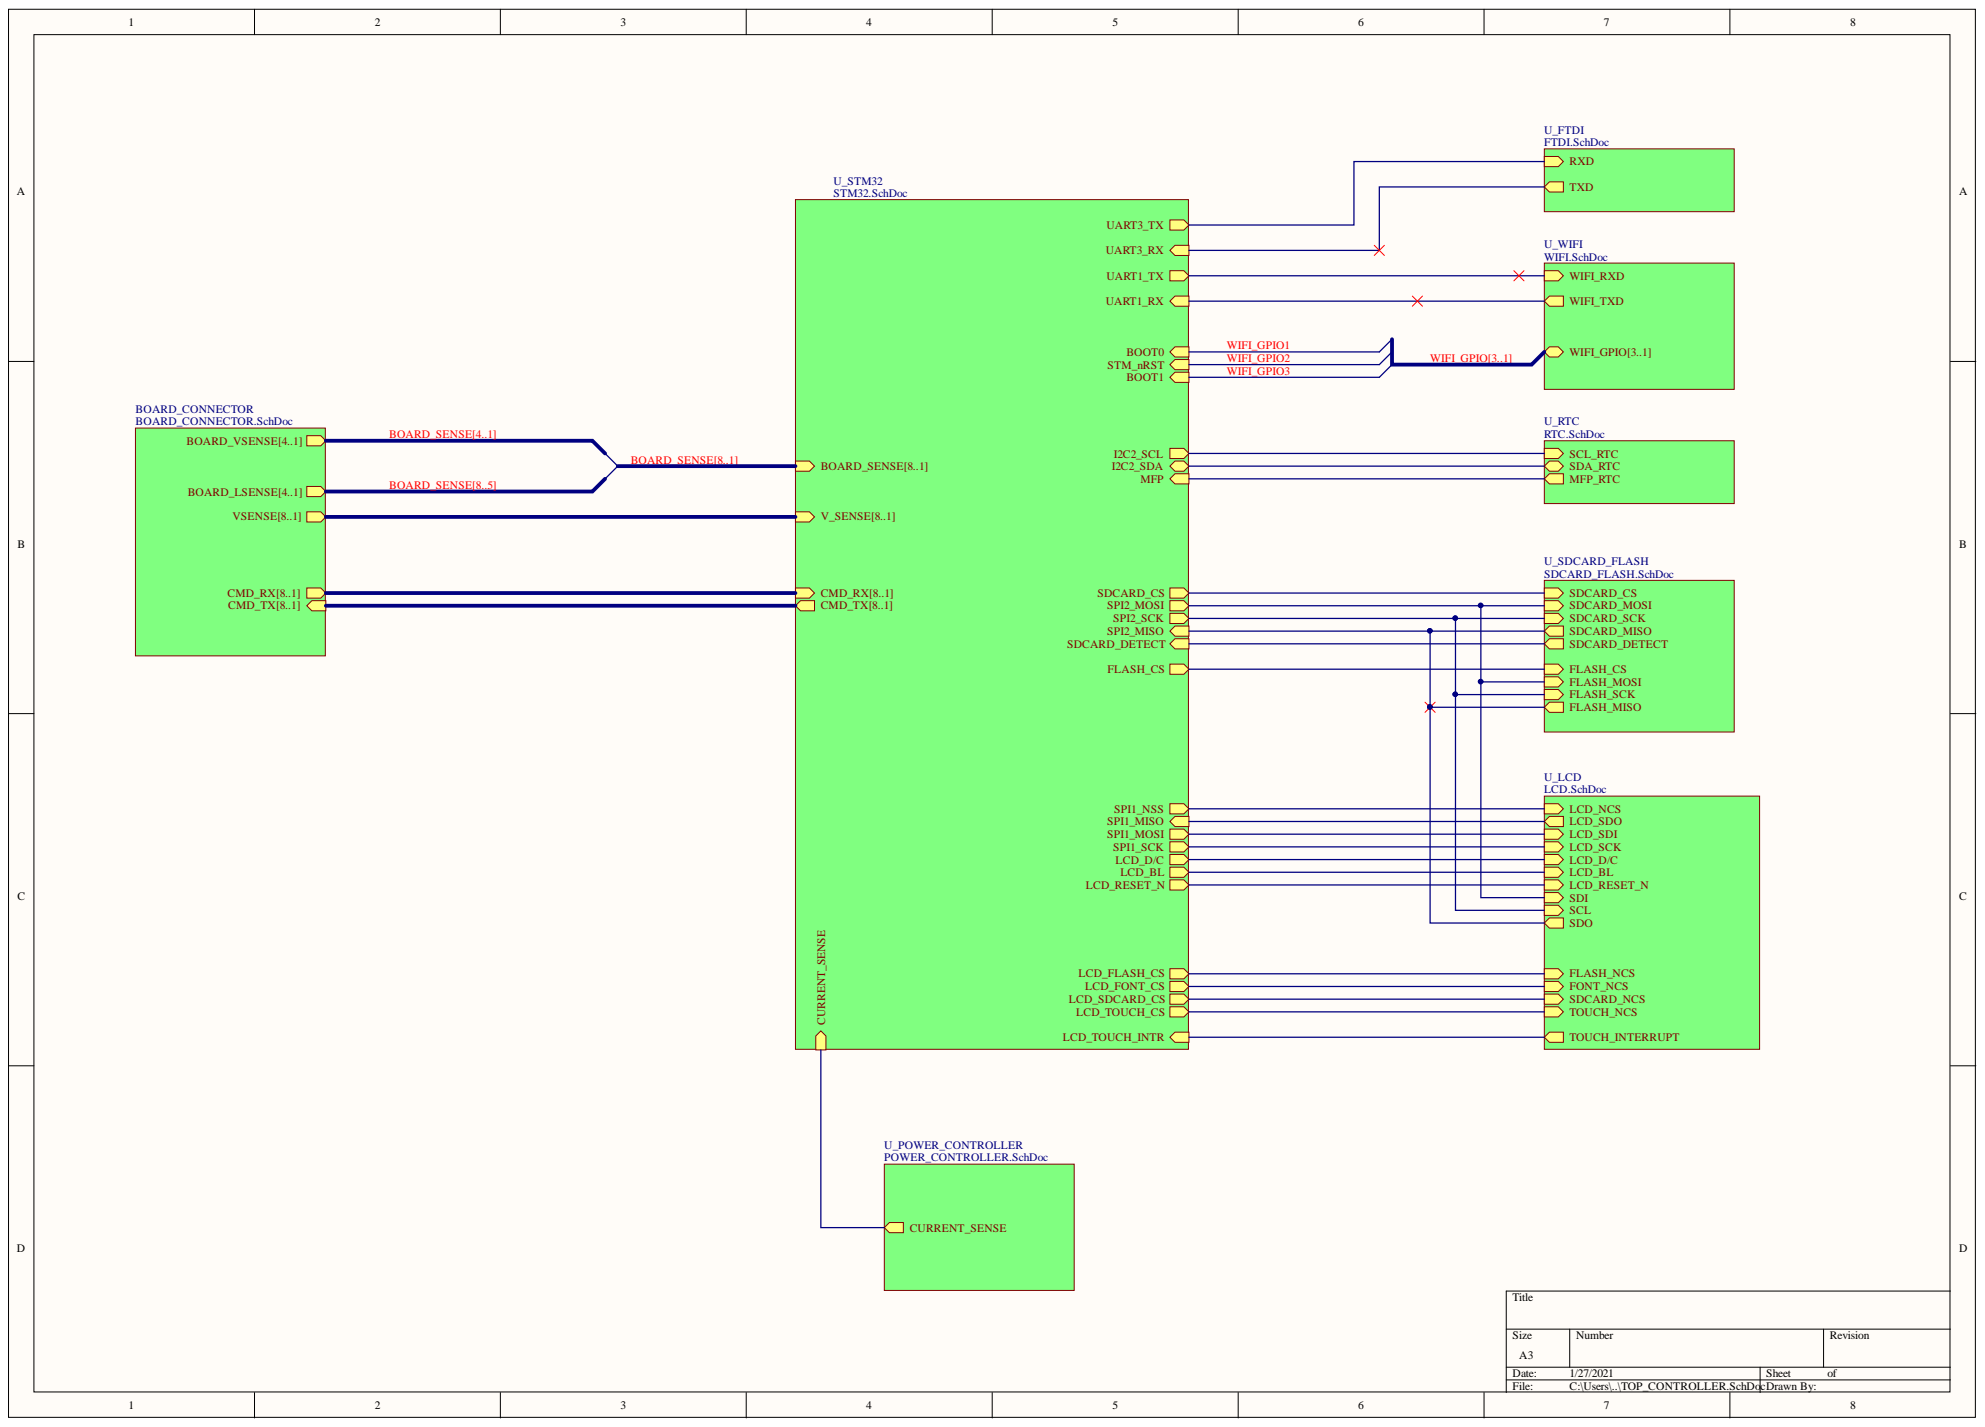
[picture p33: page 9]

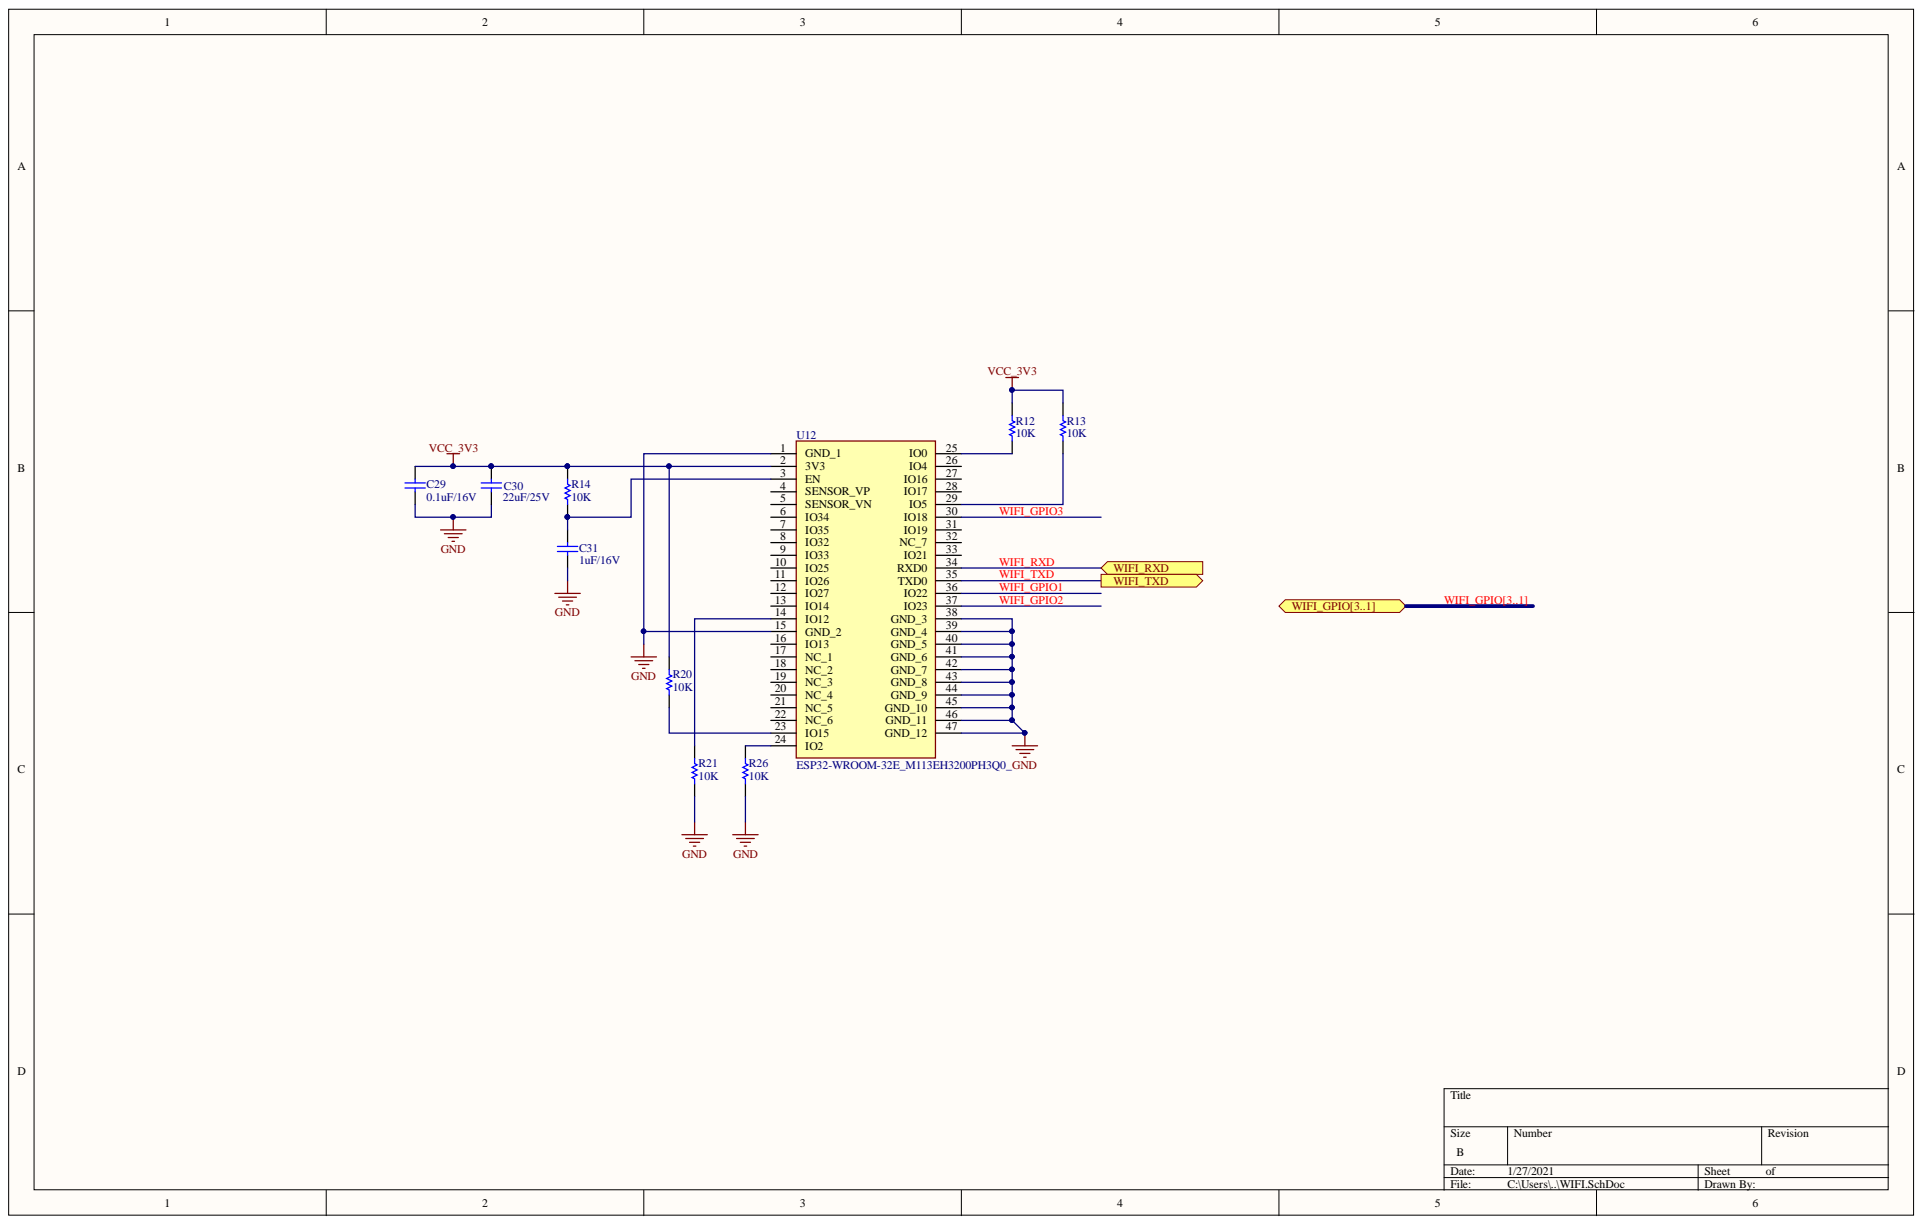
[picture p34: page 10]

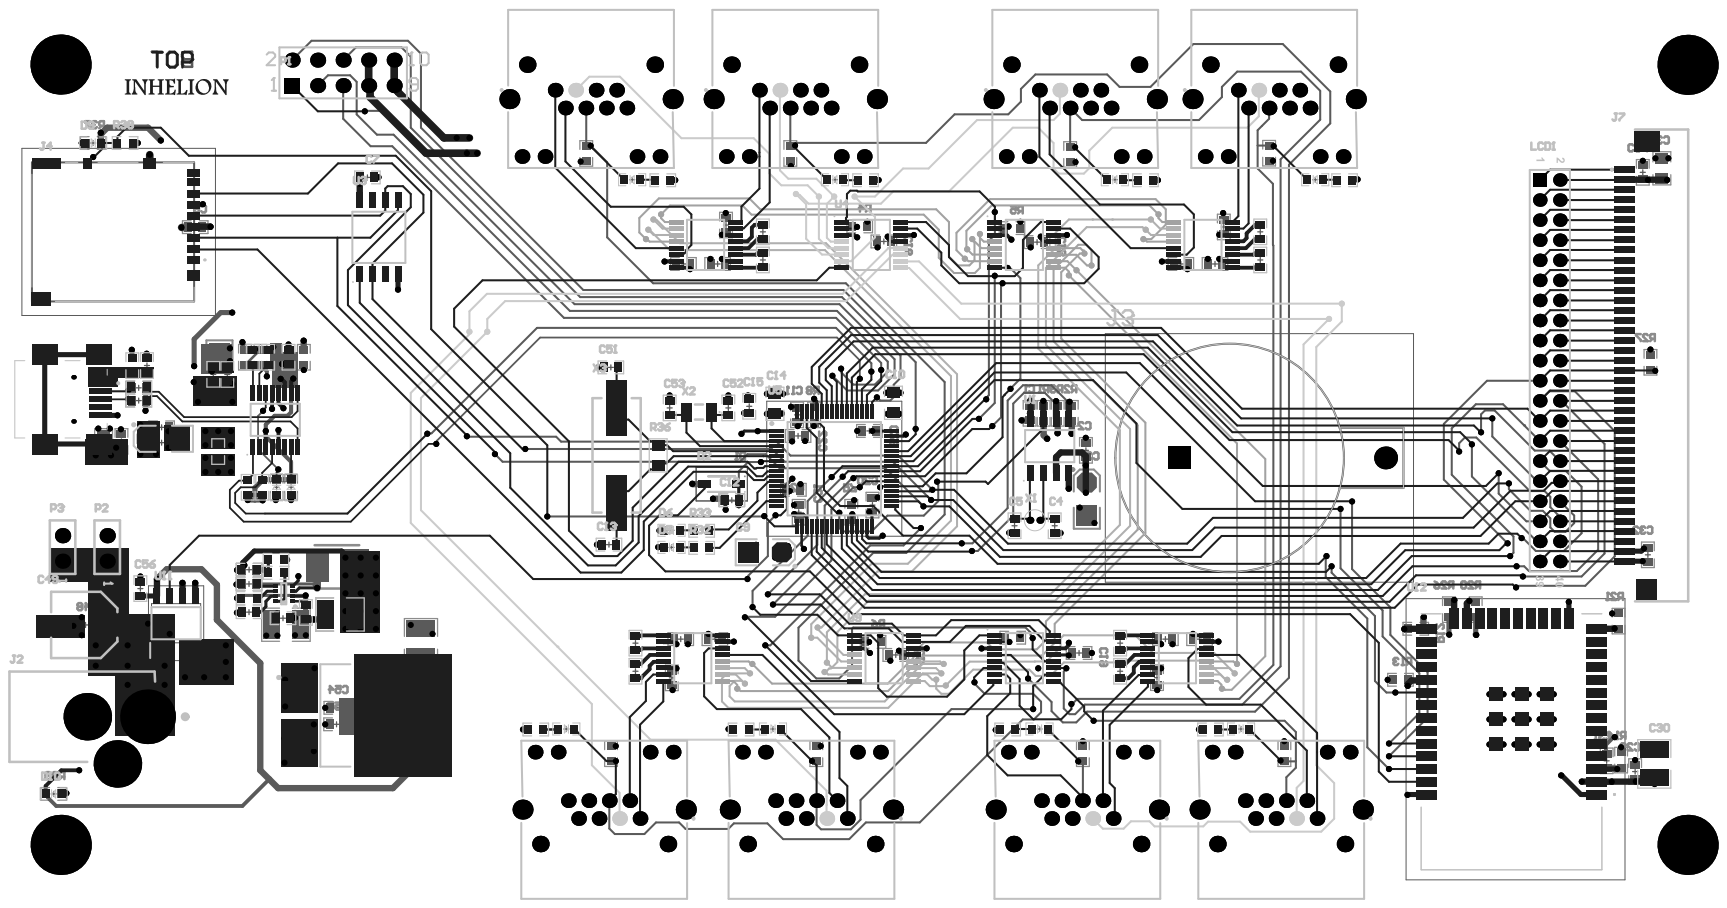
[picture p35: page 11]
