haseebulhassan/Project-C/Project-C/Project-C_Voltage/Project-C_VOLTAGE.pdf

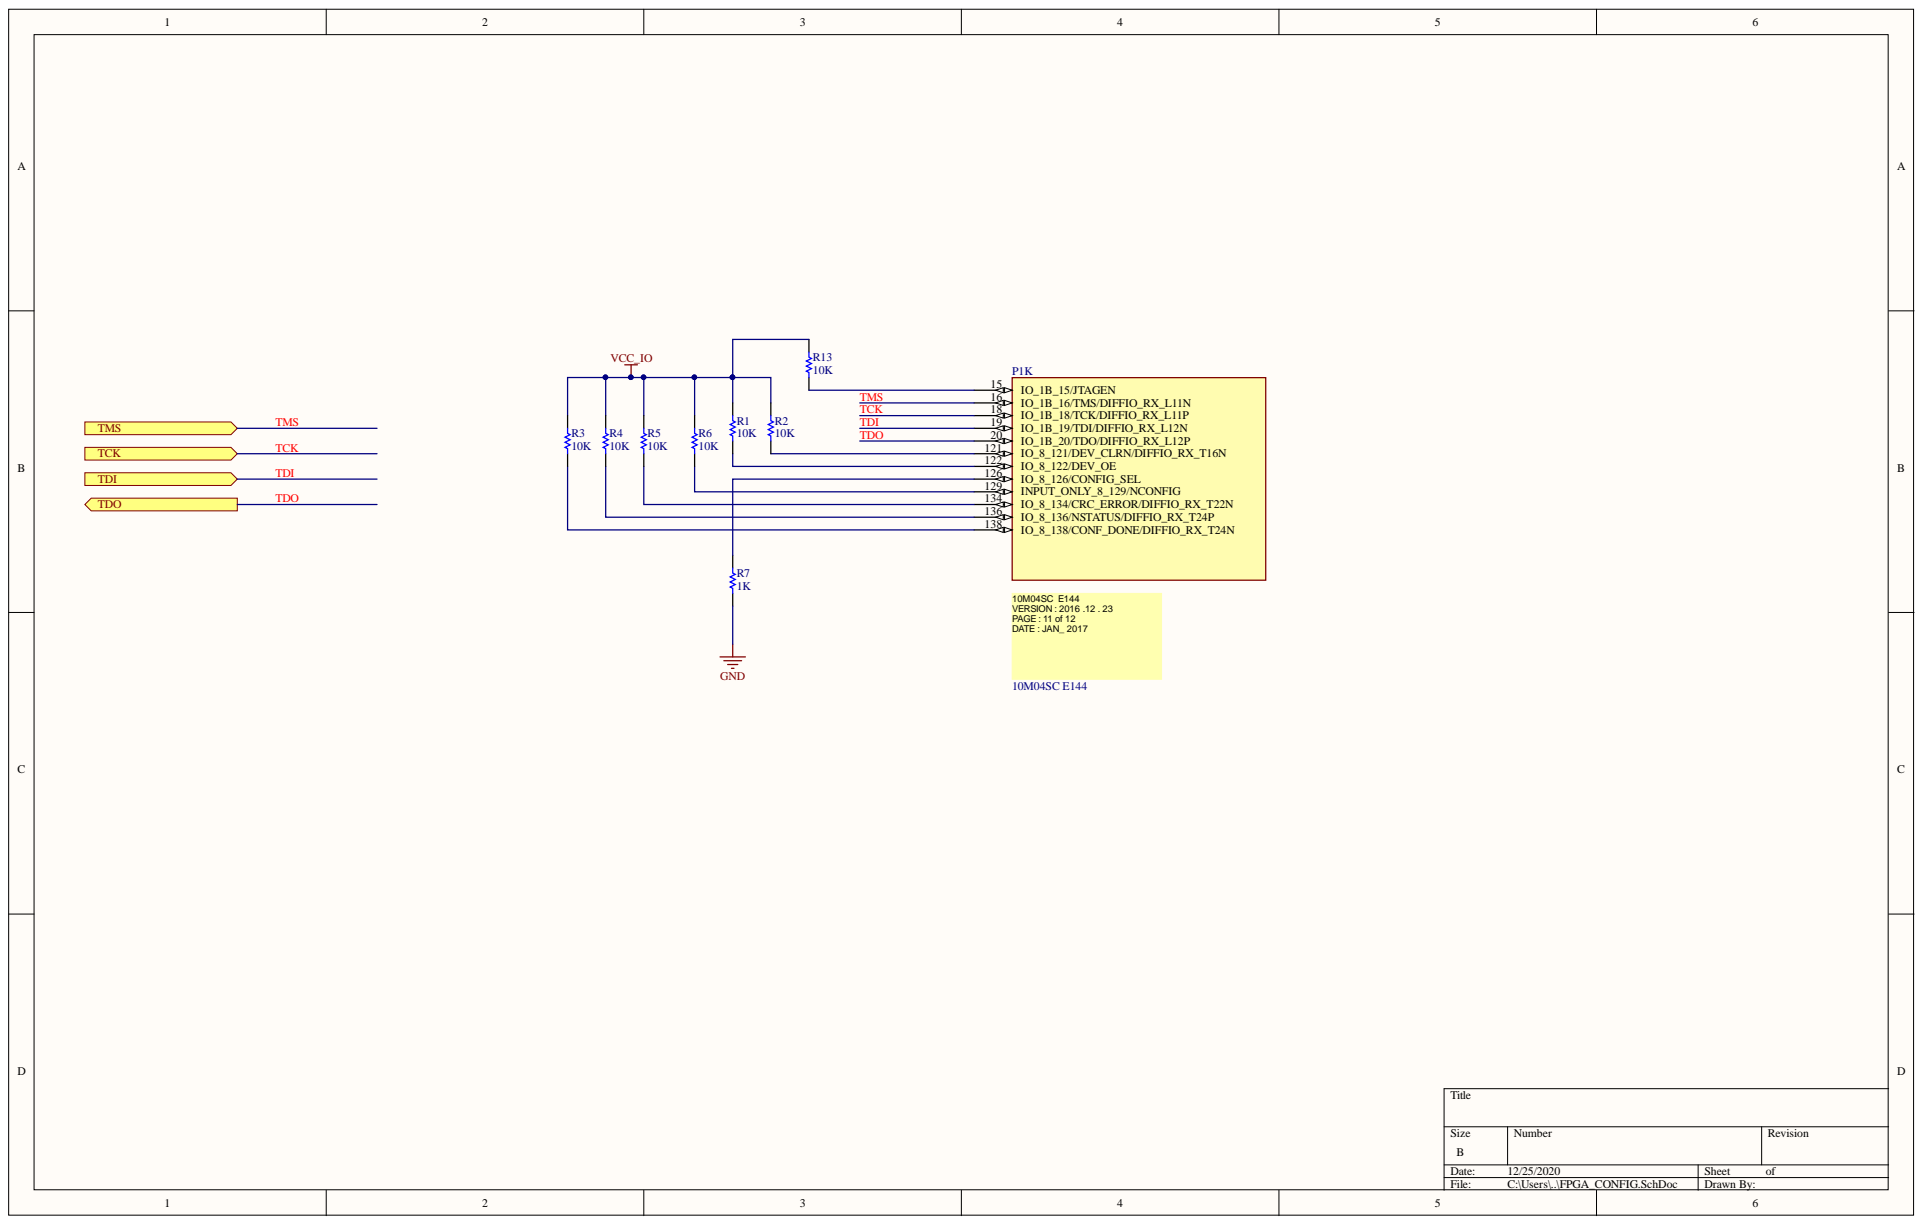
[picture p36: page 1]

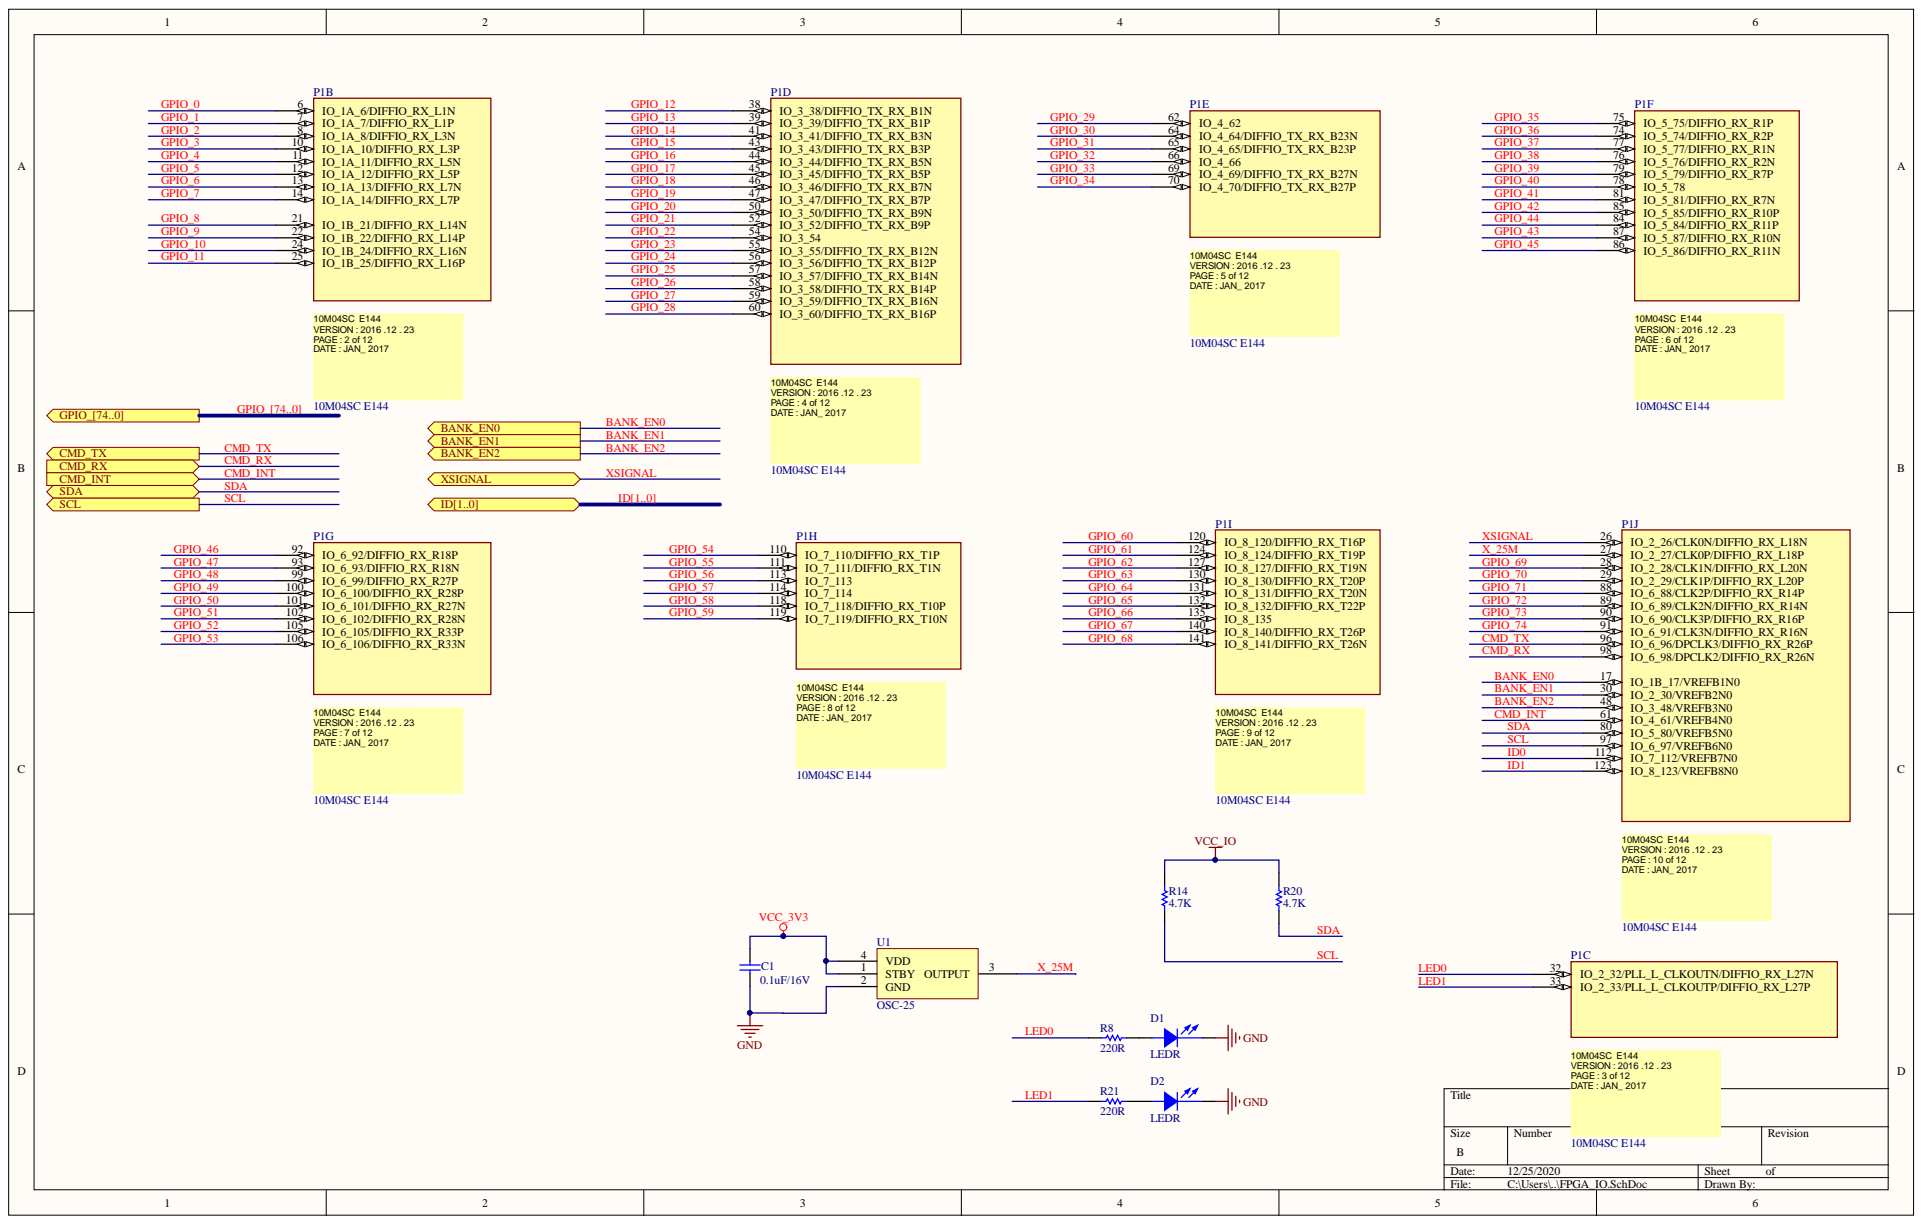
[picture p37: page 2]

Title

Date: 12/25/2020 | Sheet of
File: C:\Users\..\FPGA_IO.SchDoc | Drawn By:

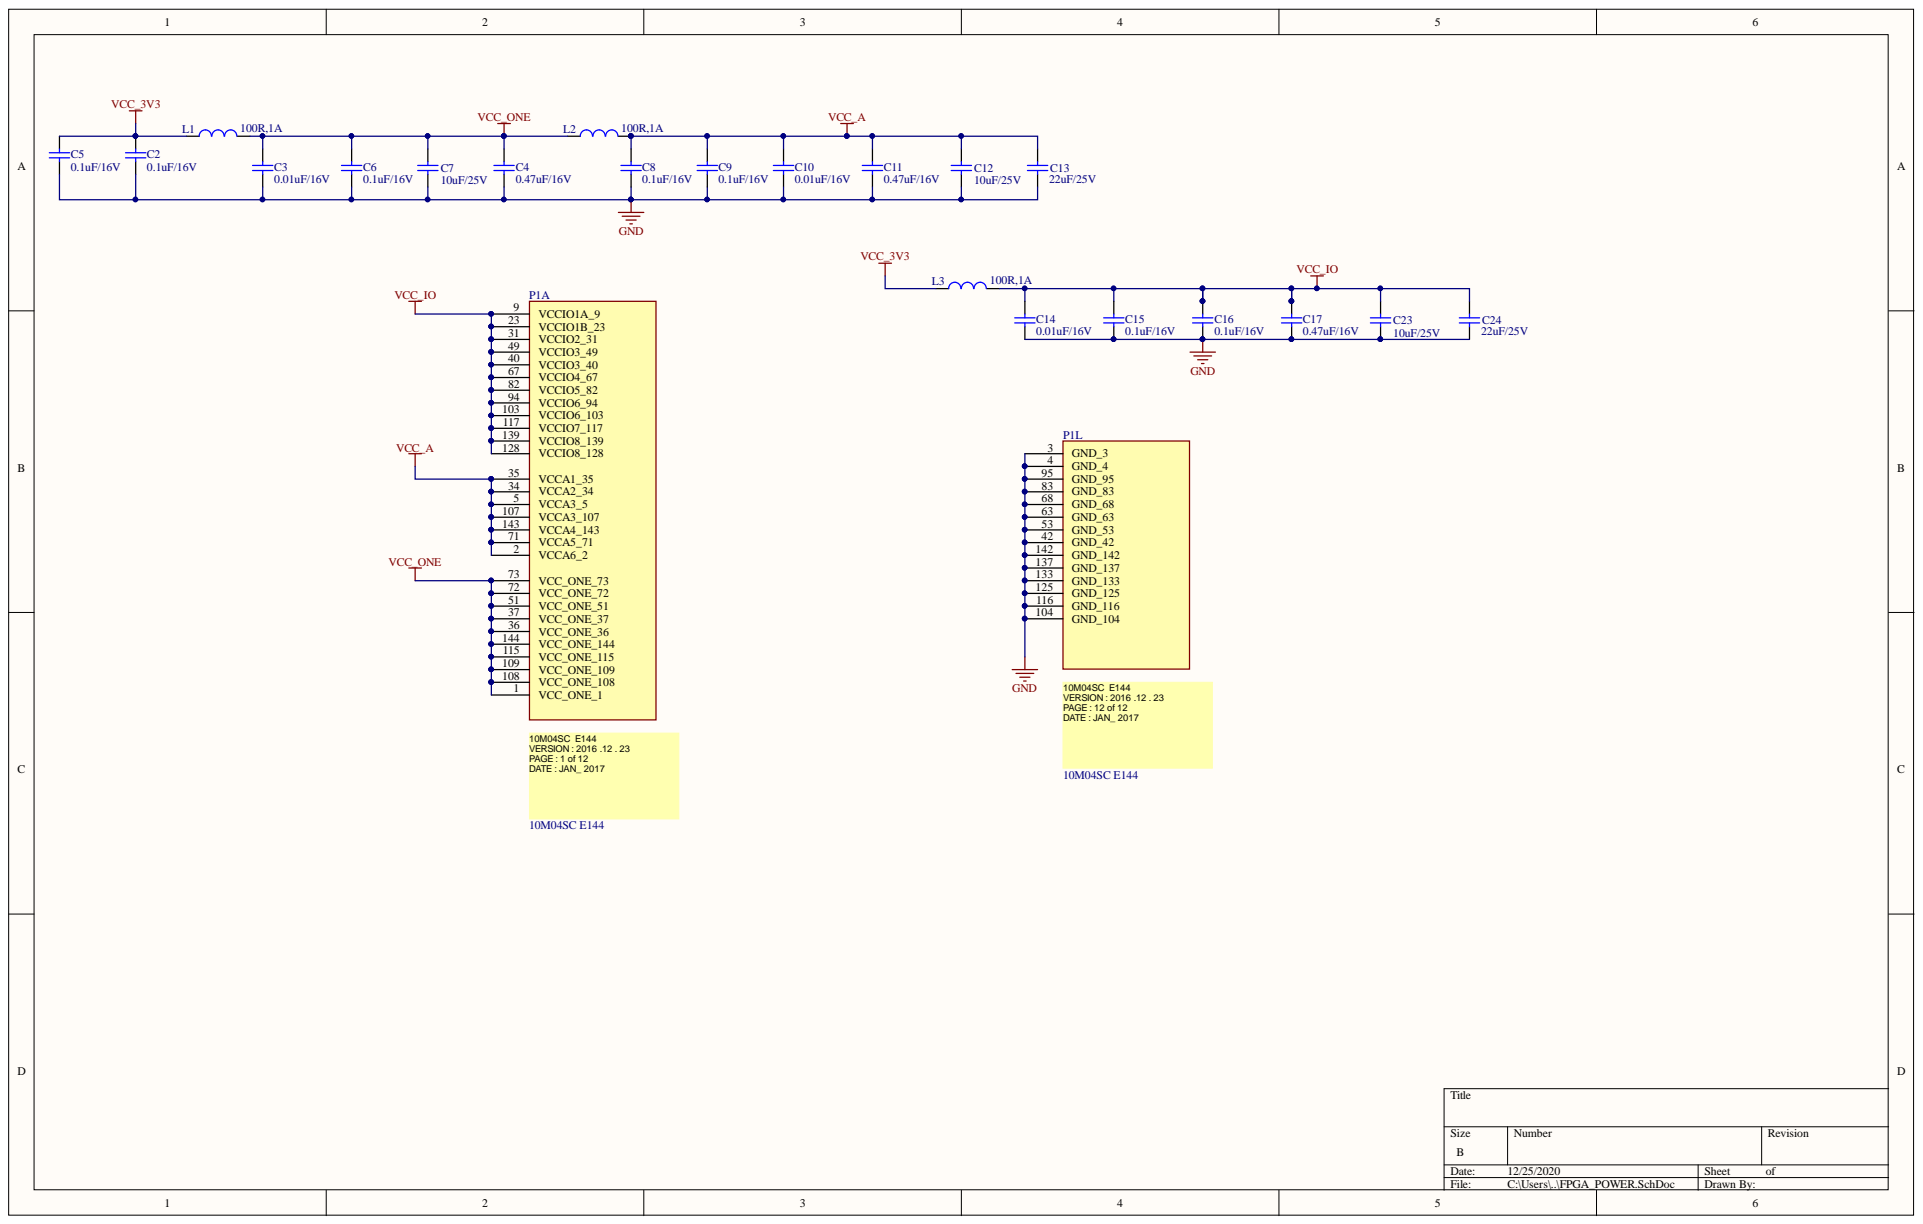
[picture p38: page 3]

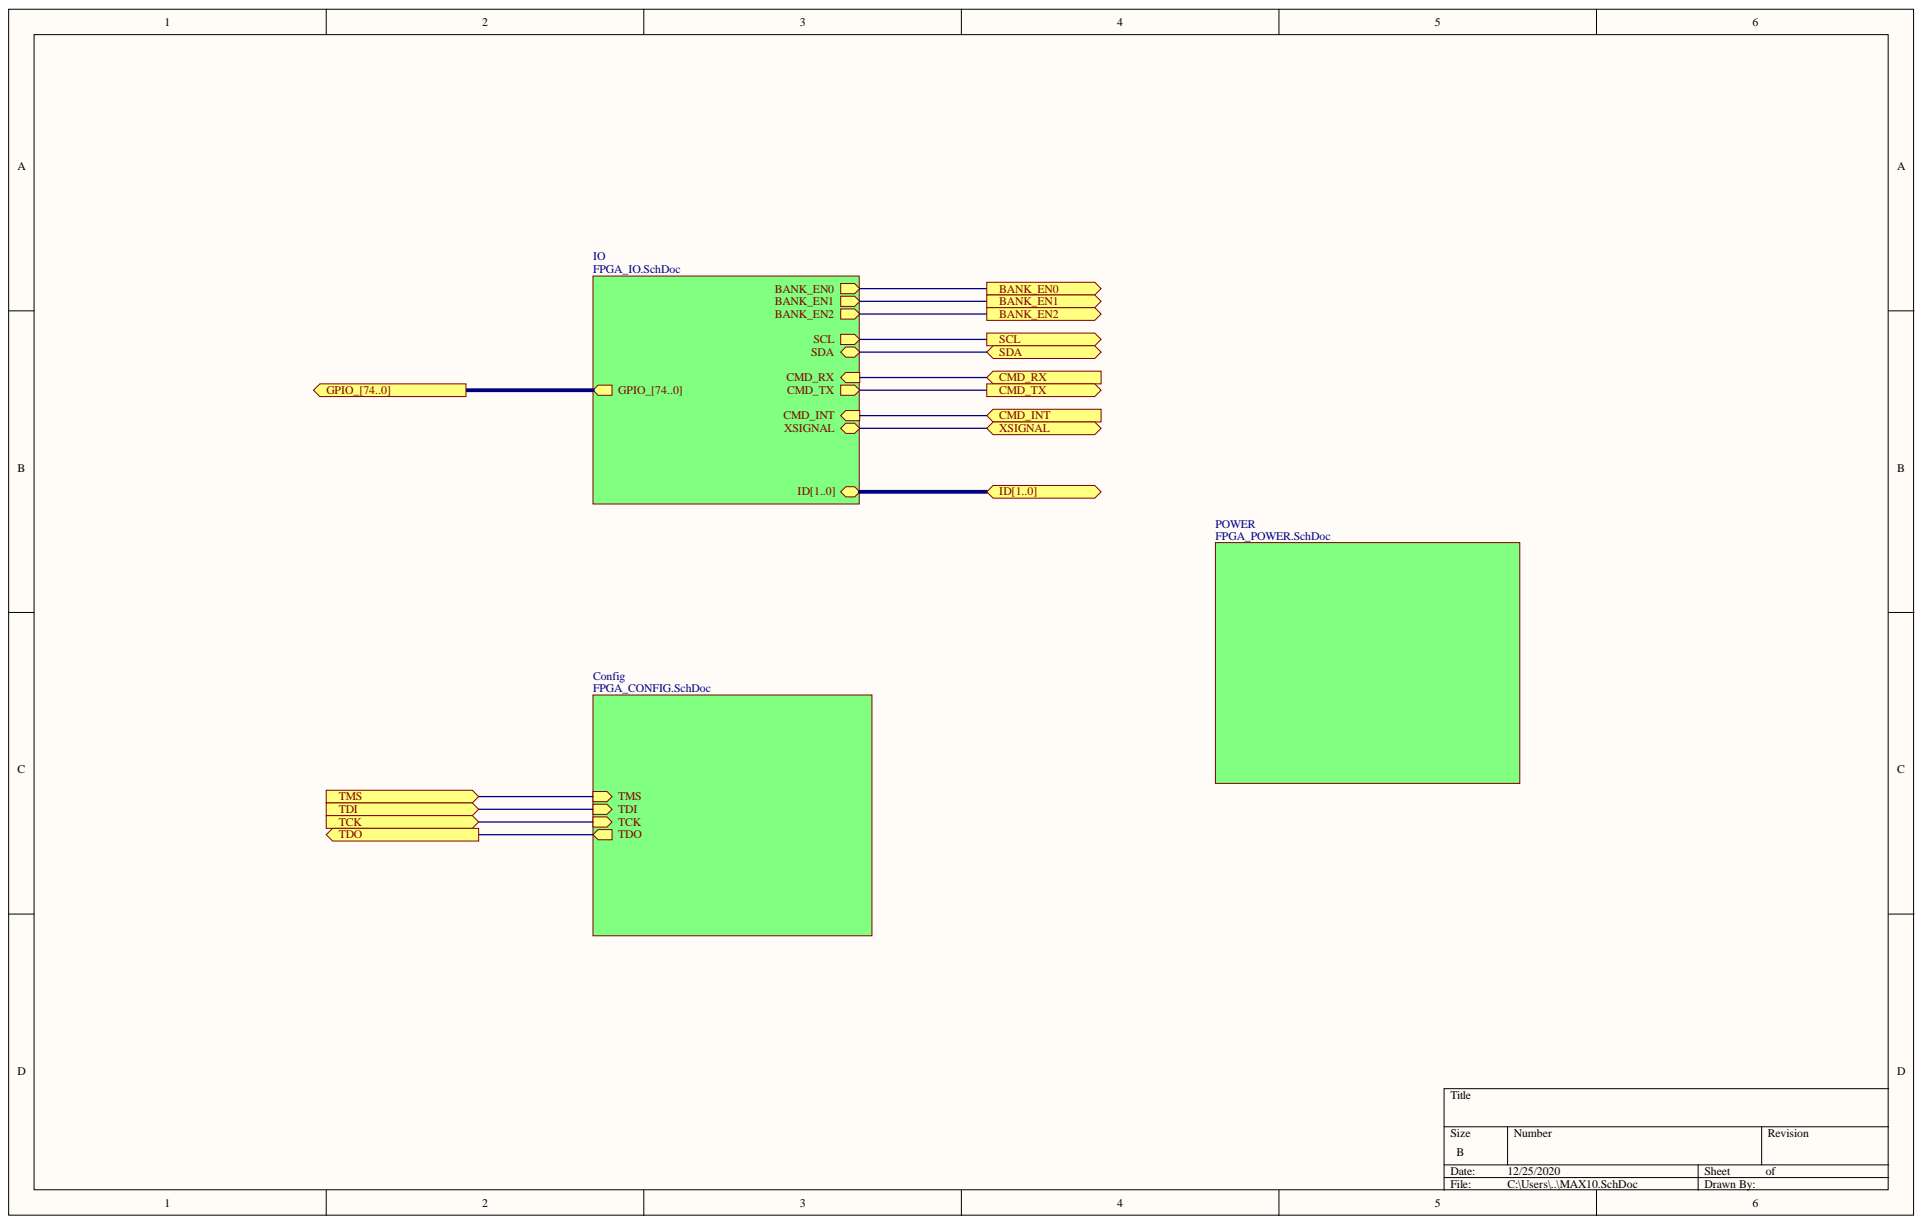
[picture p39: page 4]

Size B | Number | Revision

Date: 12/25/2020 | Sheet of
File: C:\Users\..\MAX10.SchDoc | Drawn By:

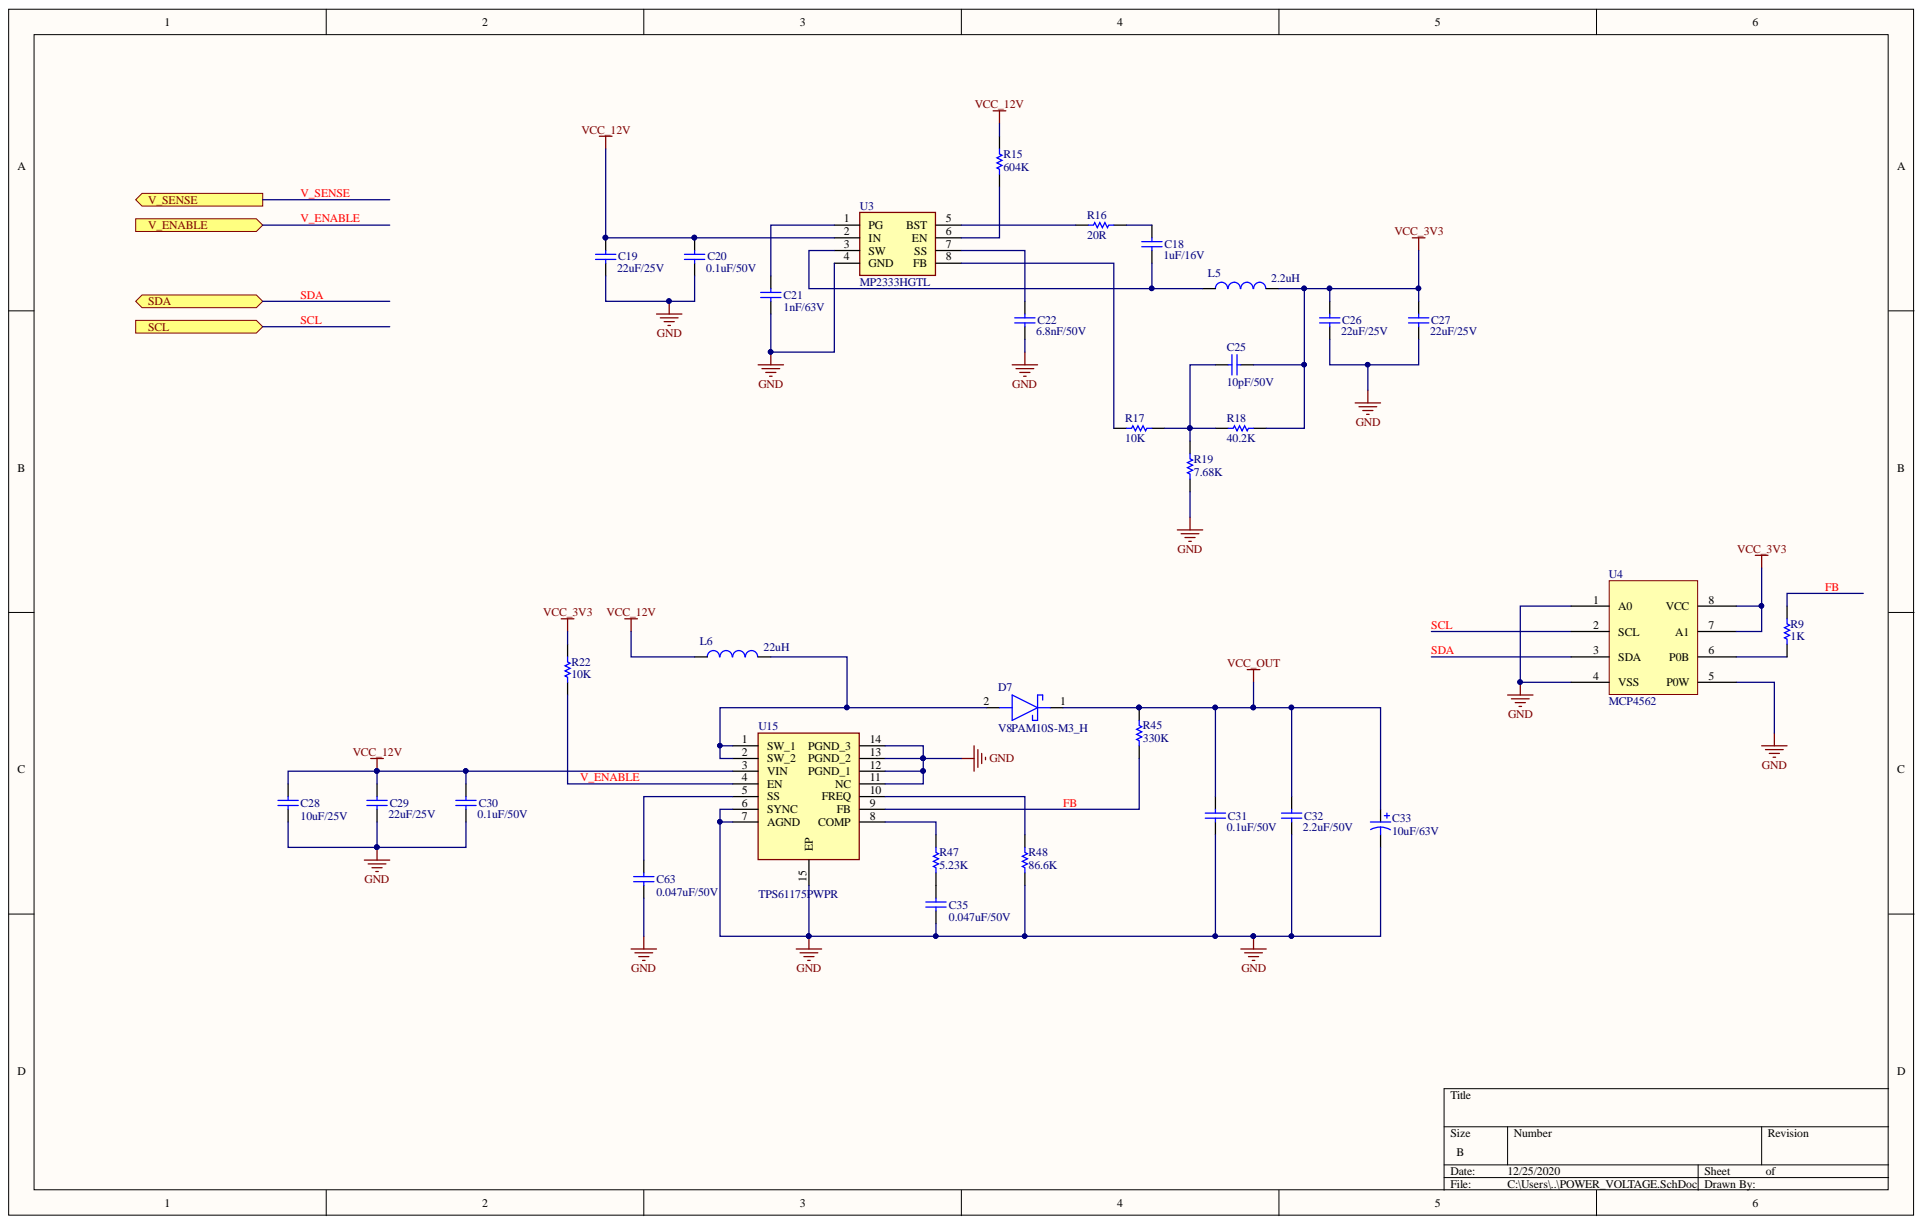
[picture p40: page 5]

IN 2
SW 3
GND 4 | | 1uF/16V

C21 1nF/63V | MP2333HGTL

SDA 3 VSS 4

Size B | Number | Revision

Date: 12/25/2020 | Sheet of
File: C:\Users\..\POWER_VOLTAGE.SchDoc | Drawn By:

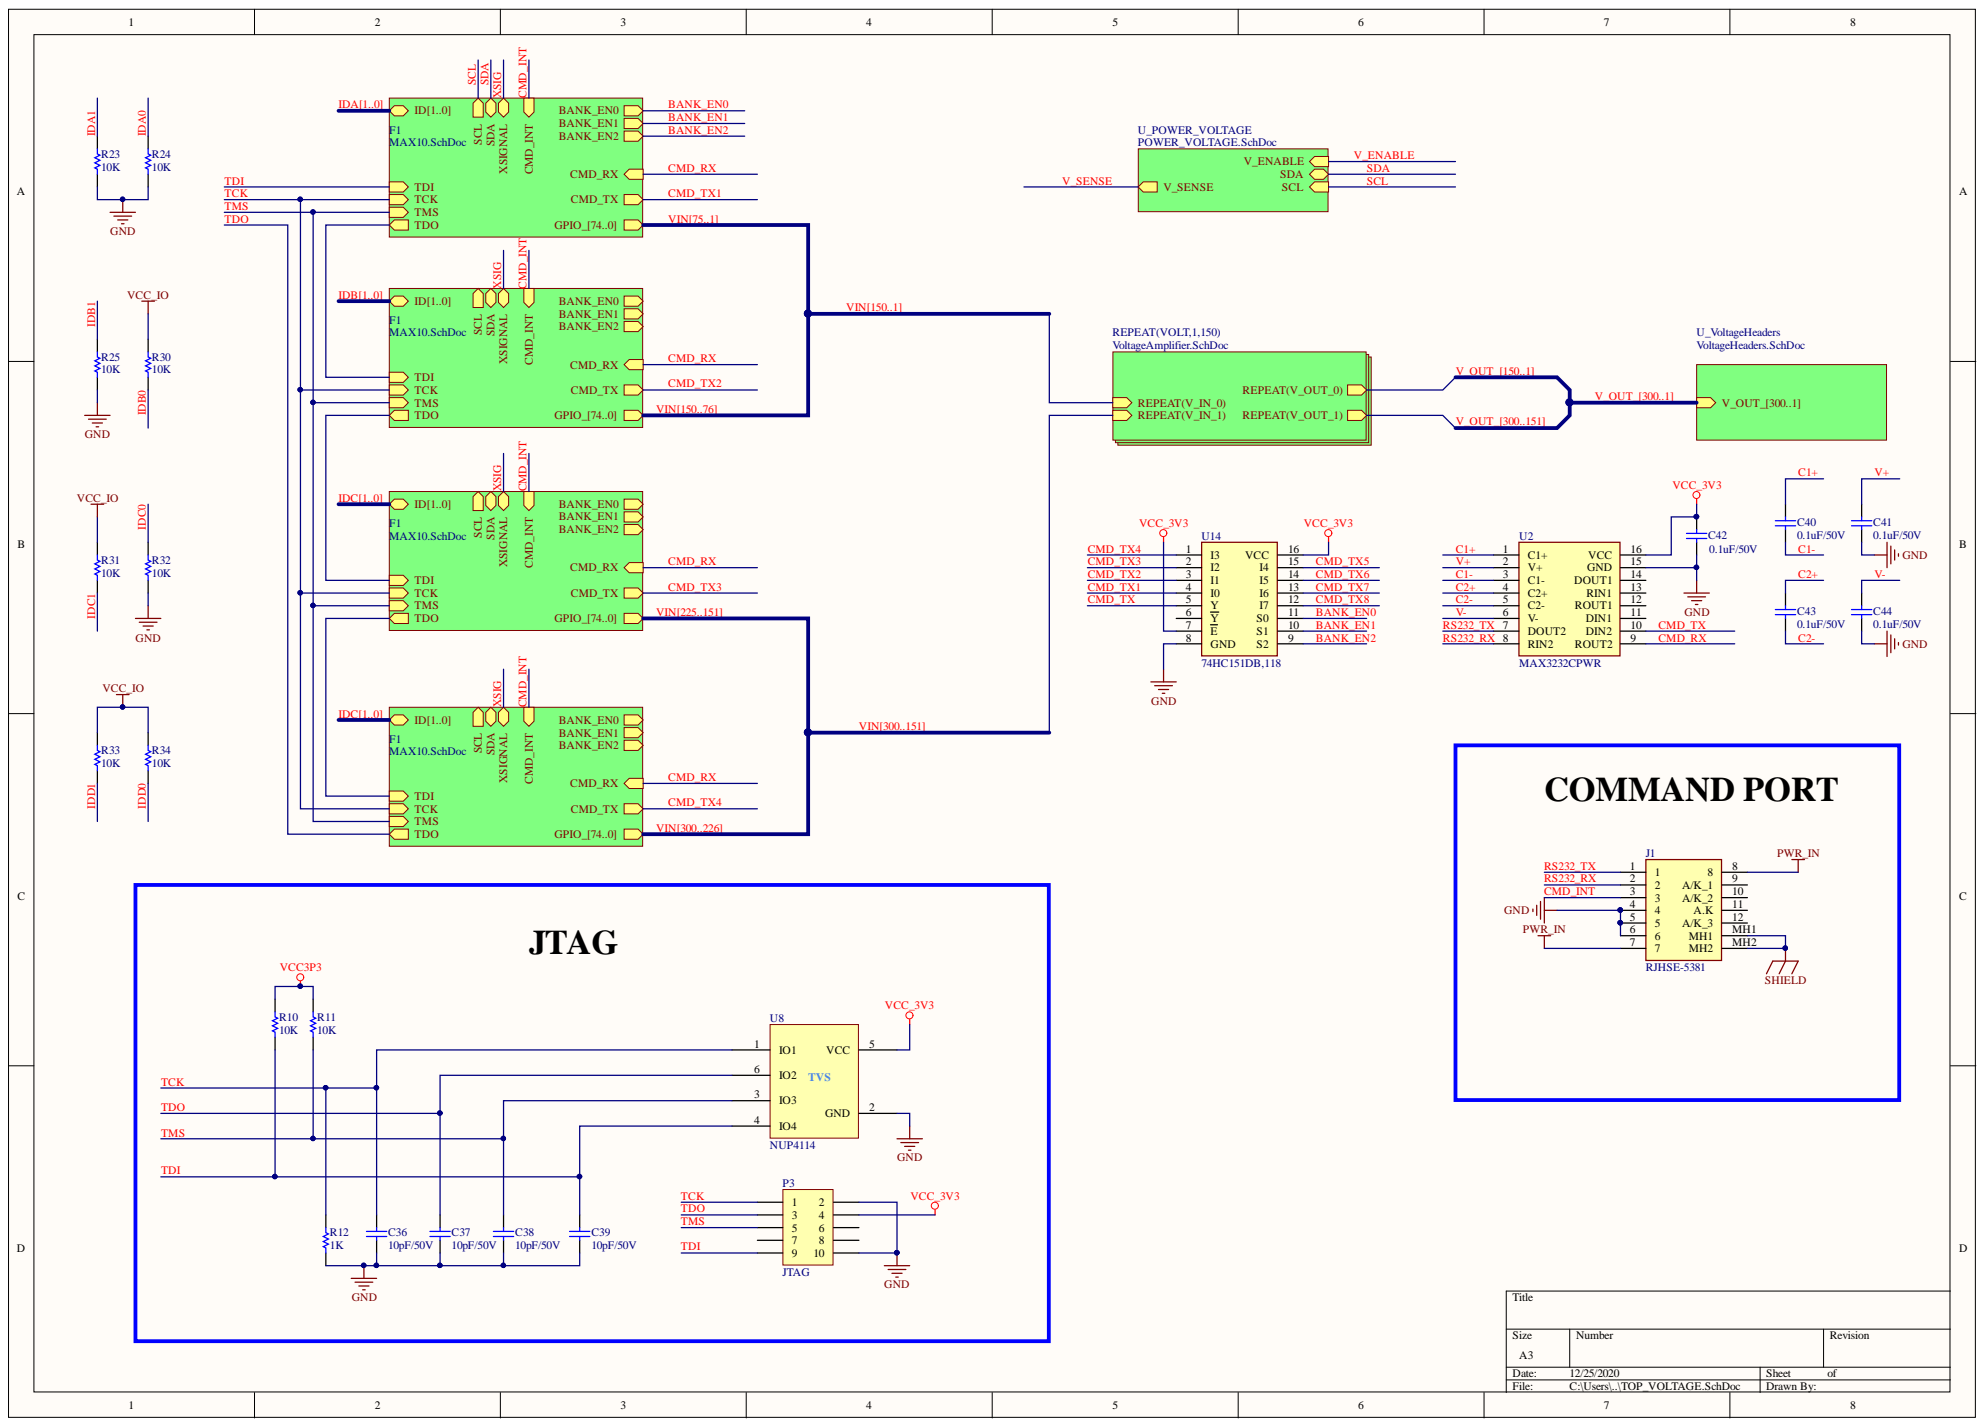
[picture p41: page 6]

TDO

TMS

TDI | P3

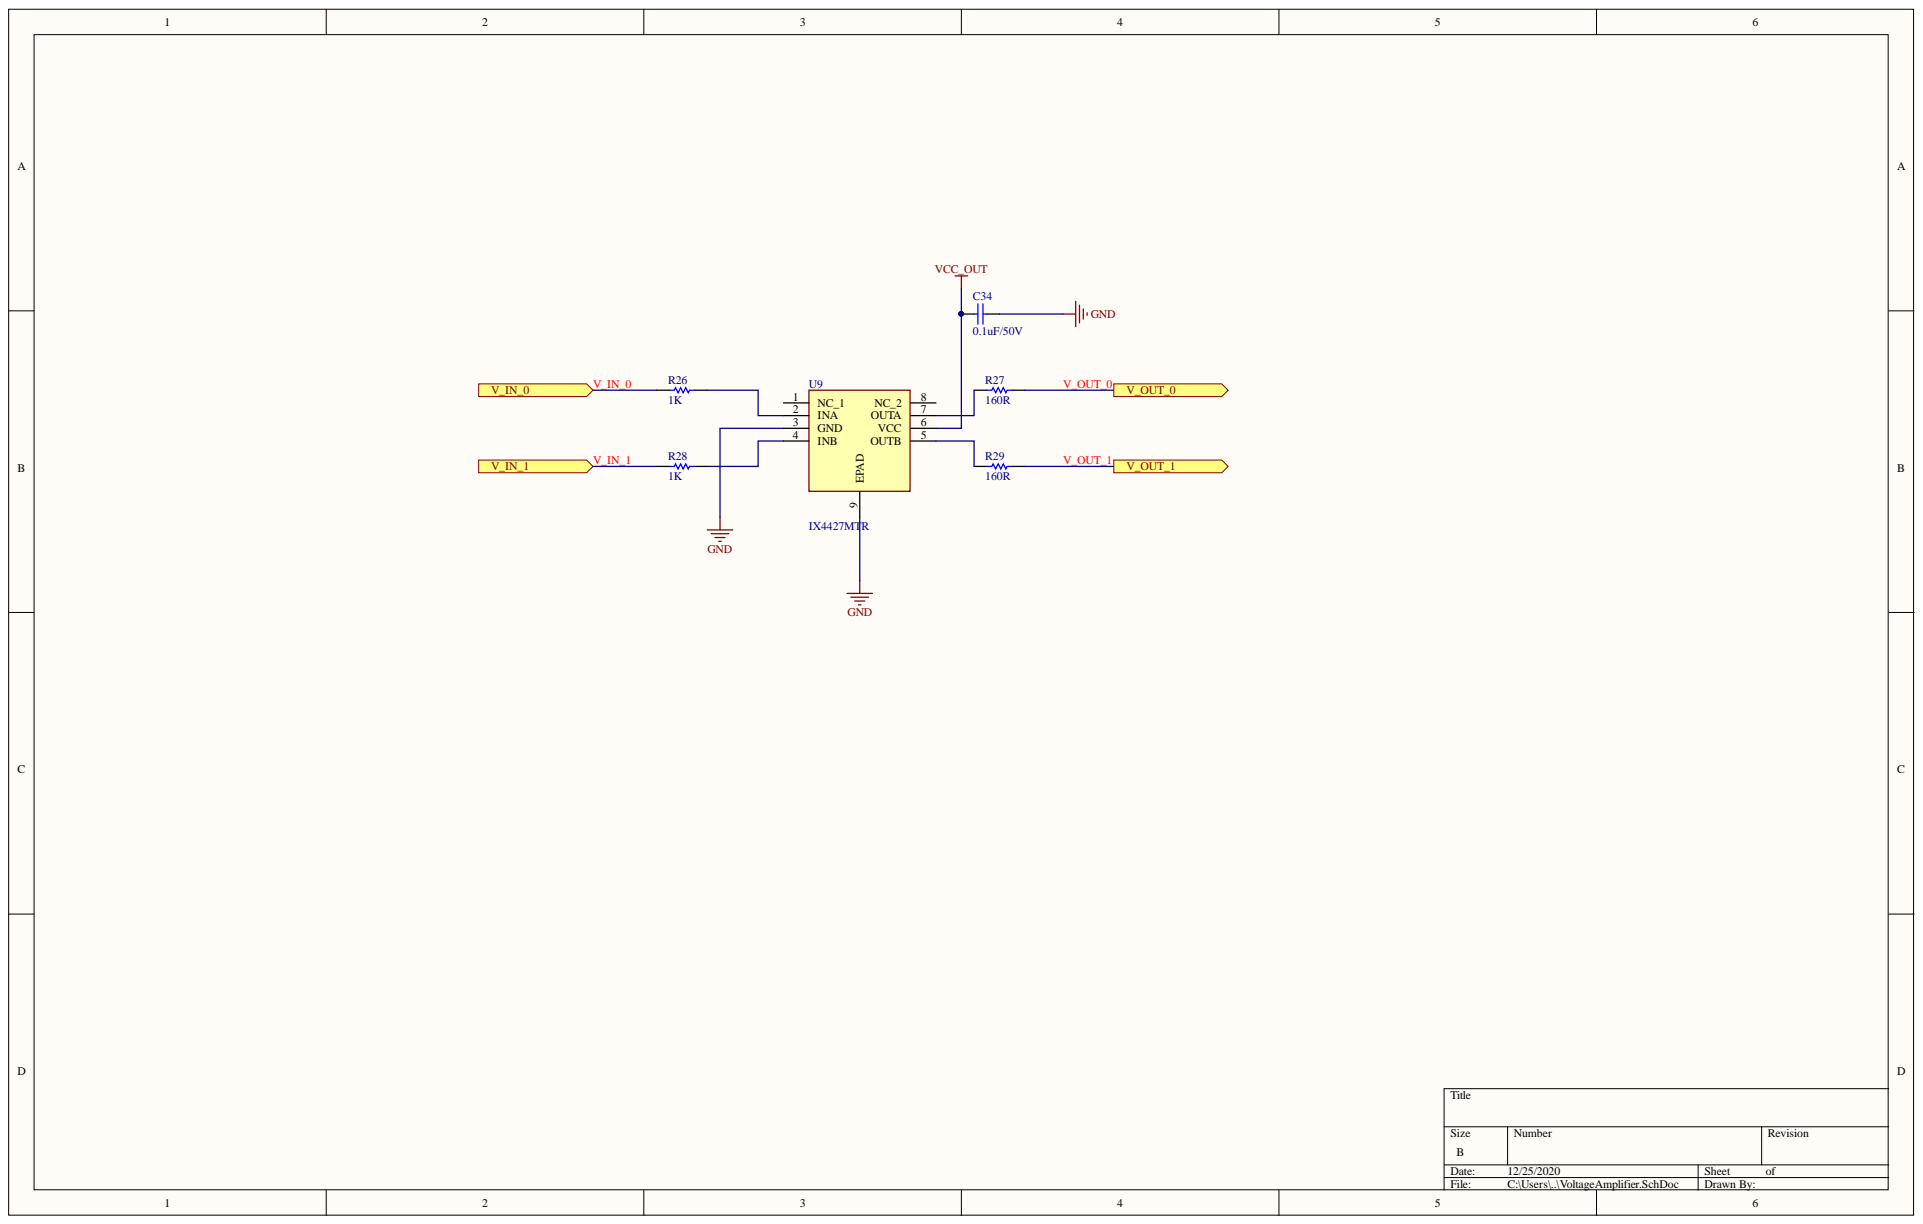
[picture p42: page 7]

Size B | Number | Revision

Date: 12/25/2020 | Sheet of
File: C:\Users\..\VoltageAmplifier.SchDoc | Drawn By:

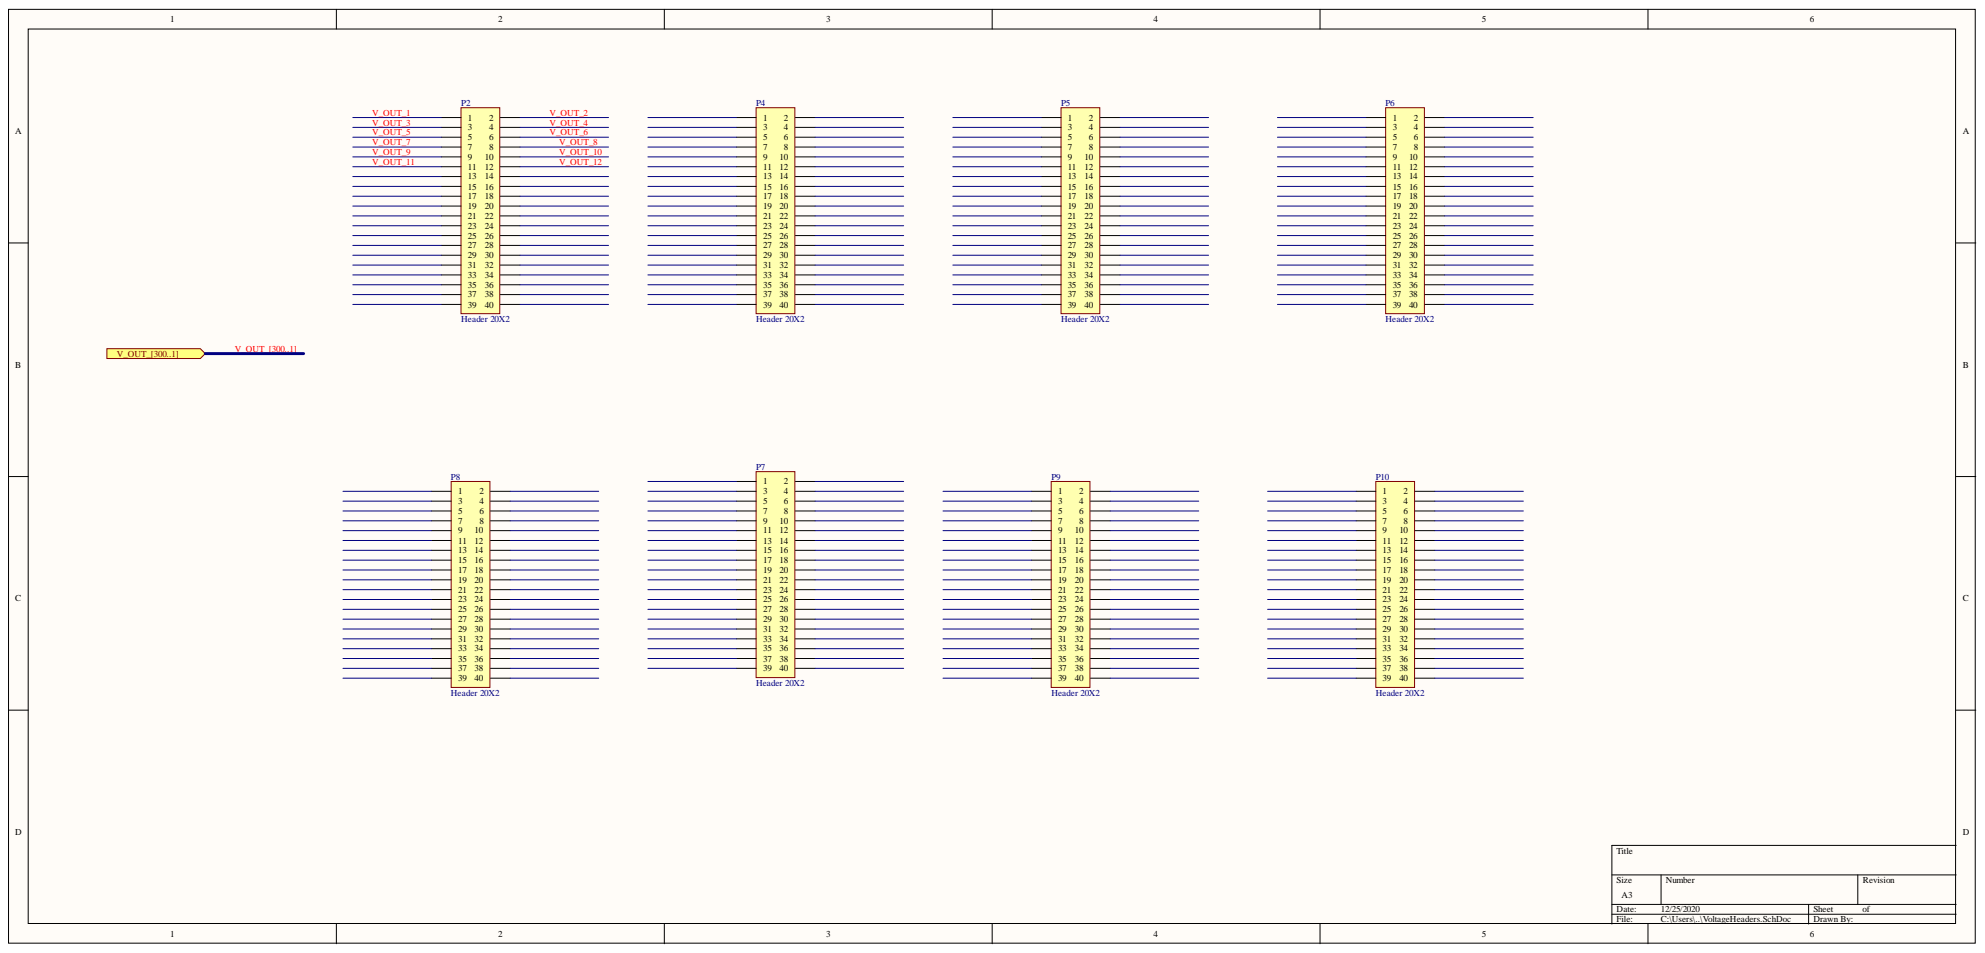
[picture p43: page 8]

Size A3 | Number | Revision

Date: 12/25/2020 | Sheet of
File: C:\Users\..\VoltageHeaders.SchDoc | Drawn By:
