haseebulhassan/Project-C/Project-C/Project-C_Controller/Project Outputs for Project-C_CONTOLLER/Assembly Drawings.pdf

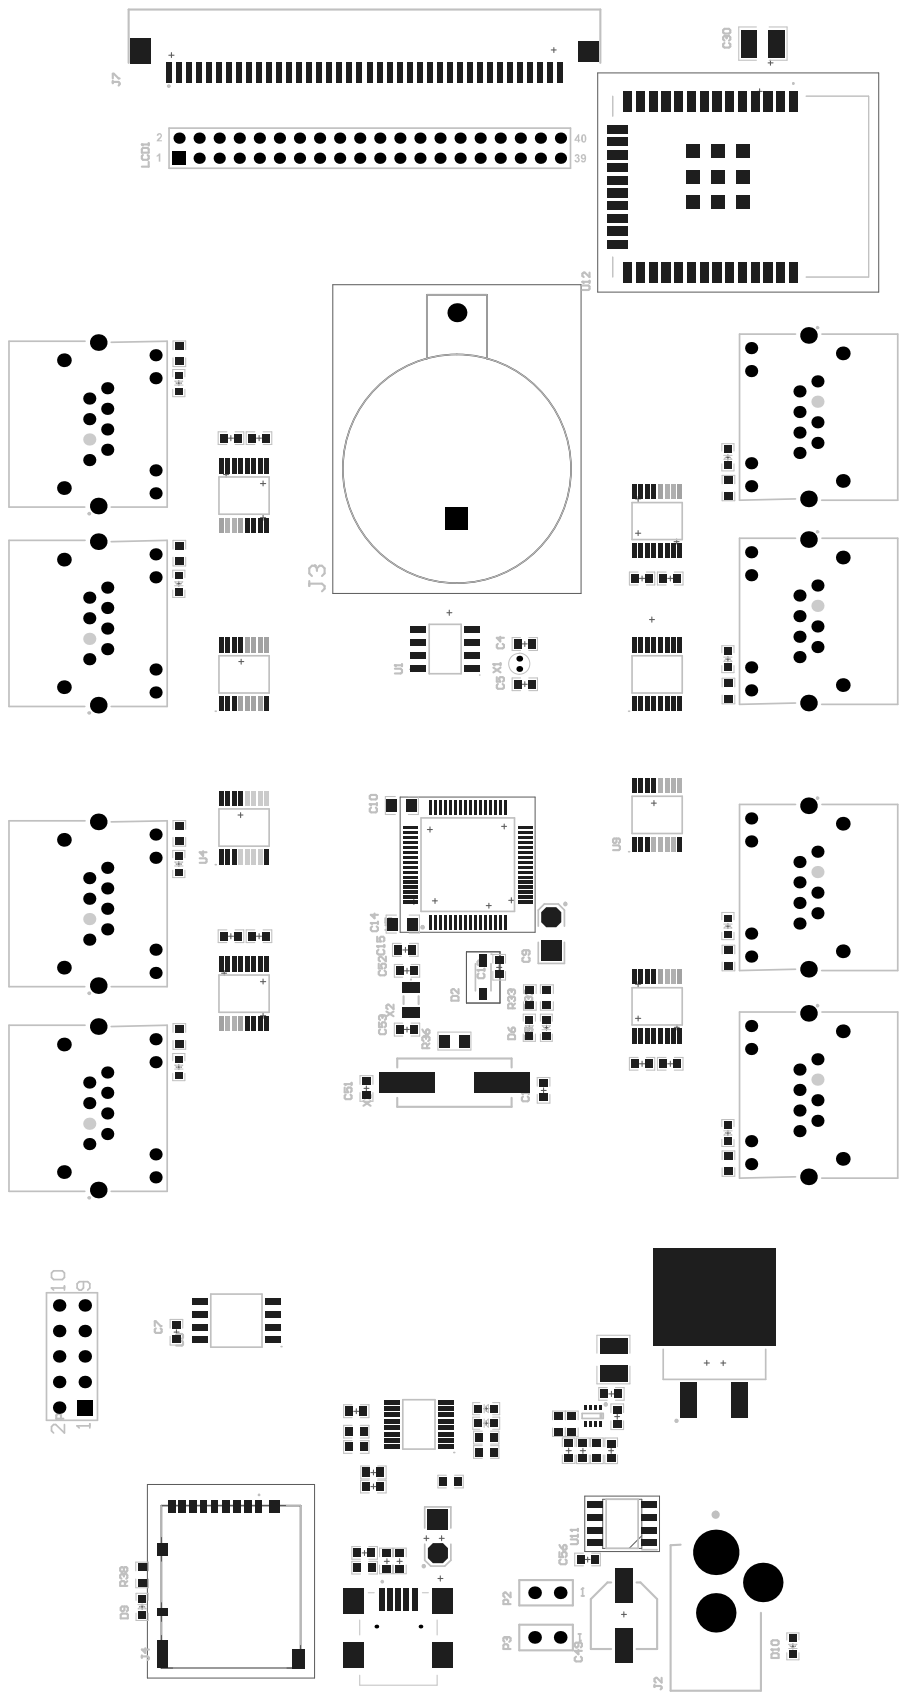
[picture p44: page 1]

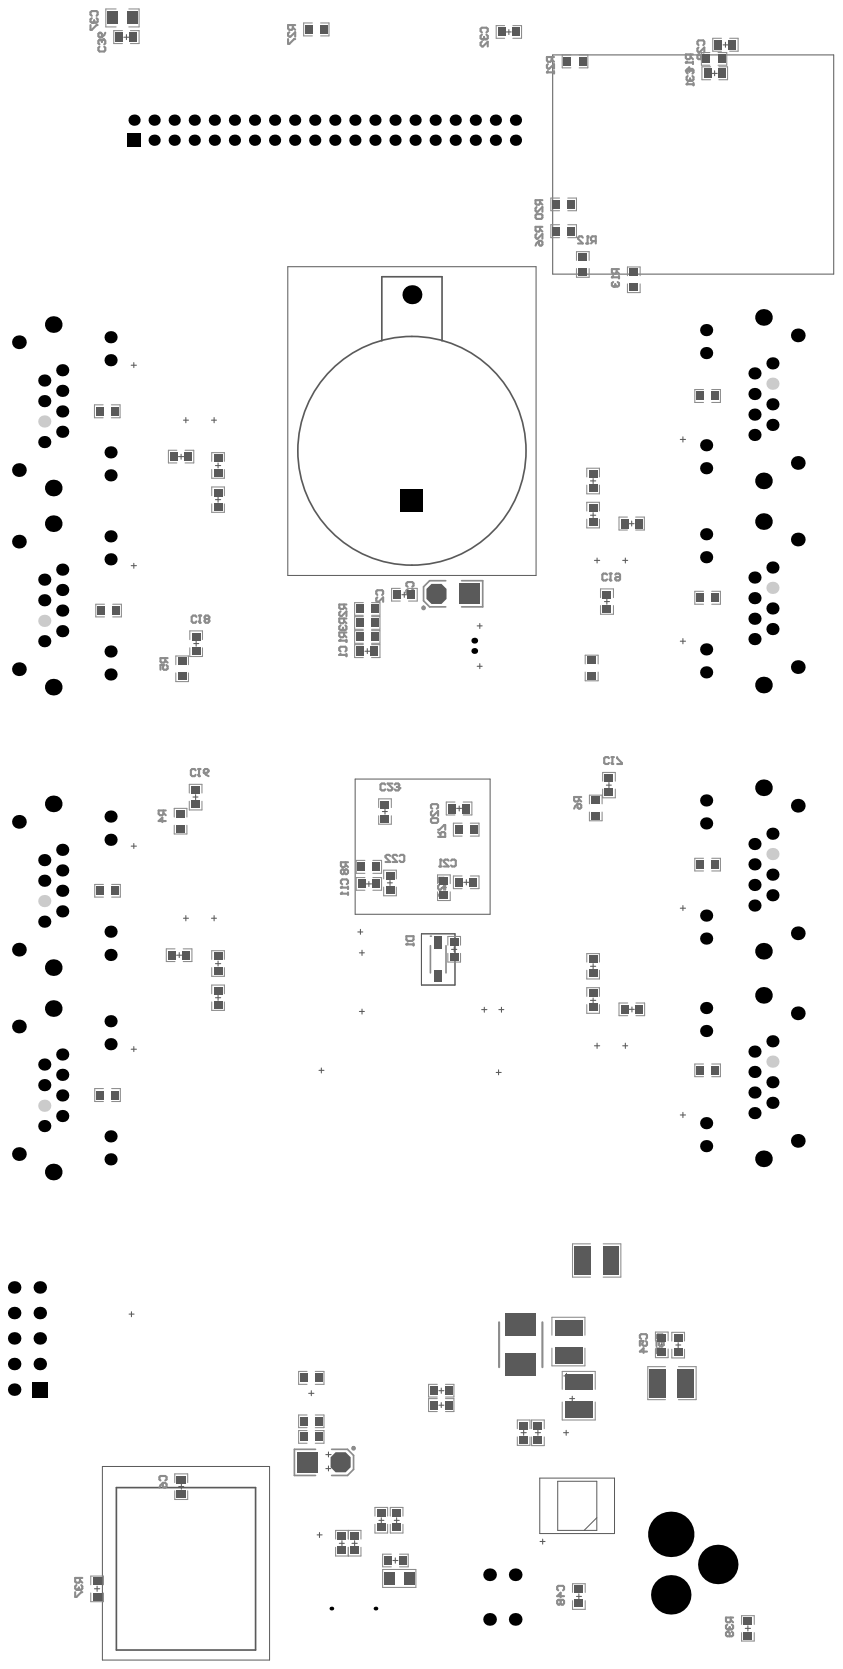
[picture p45: page 2]
