haseebulhassan/Project-C/Project-C/Project-C_LED/Project Outputs for Project-C_LED/Assembly/Assembly Drawings.pdf

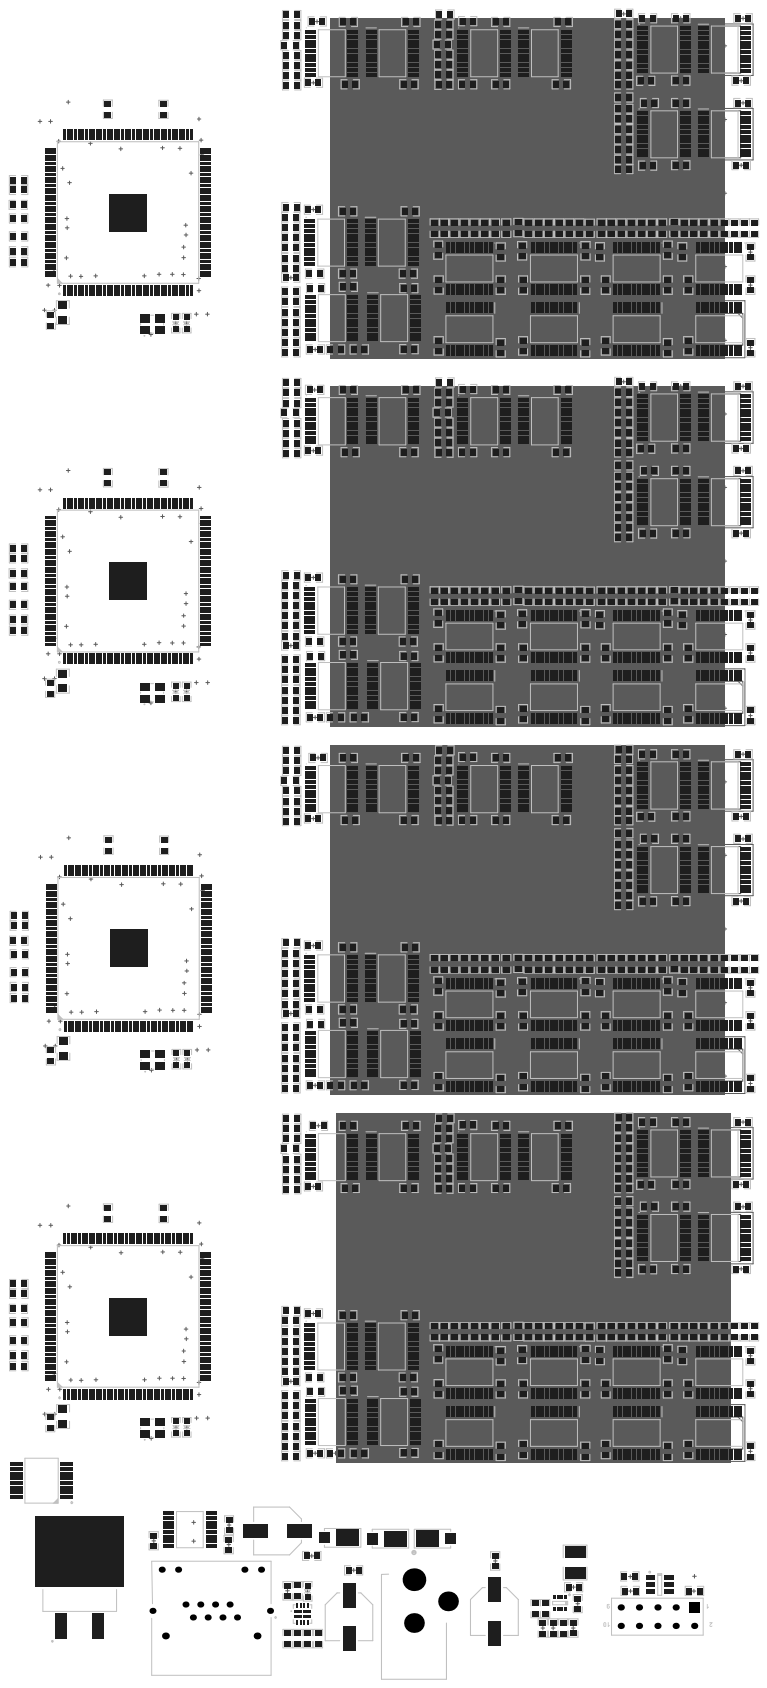
[picture p46: page 1]

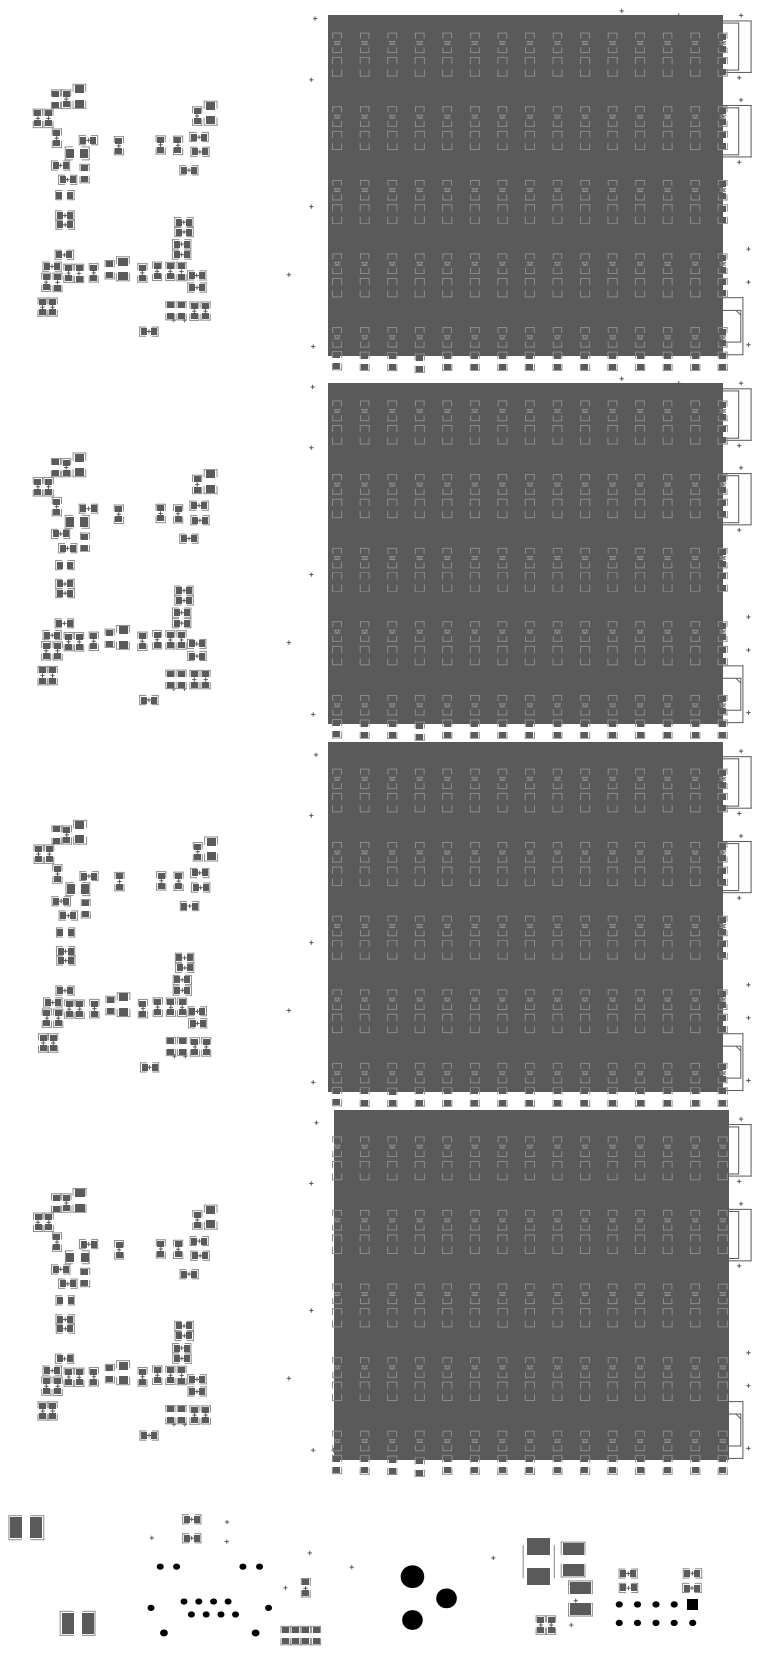
[picture p47: page 2]
