haseebulhassan/Project-C/Project-C/Project-C_Voltage/Project Outputs for Project-C_VOLTAGE/Assembly/Assembly Drawings.pdf

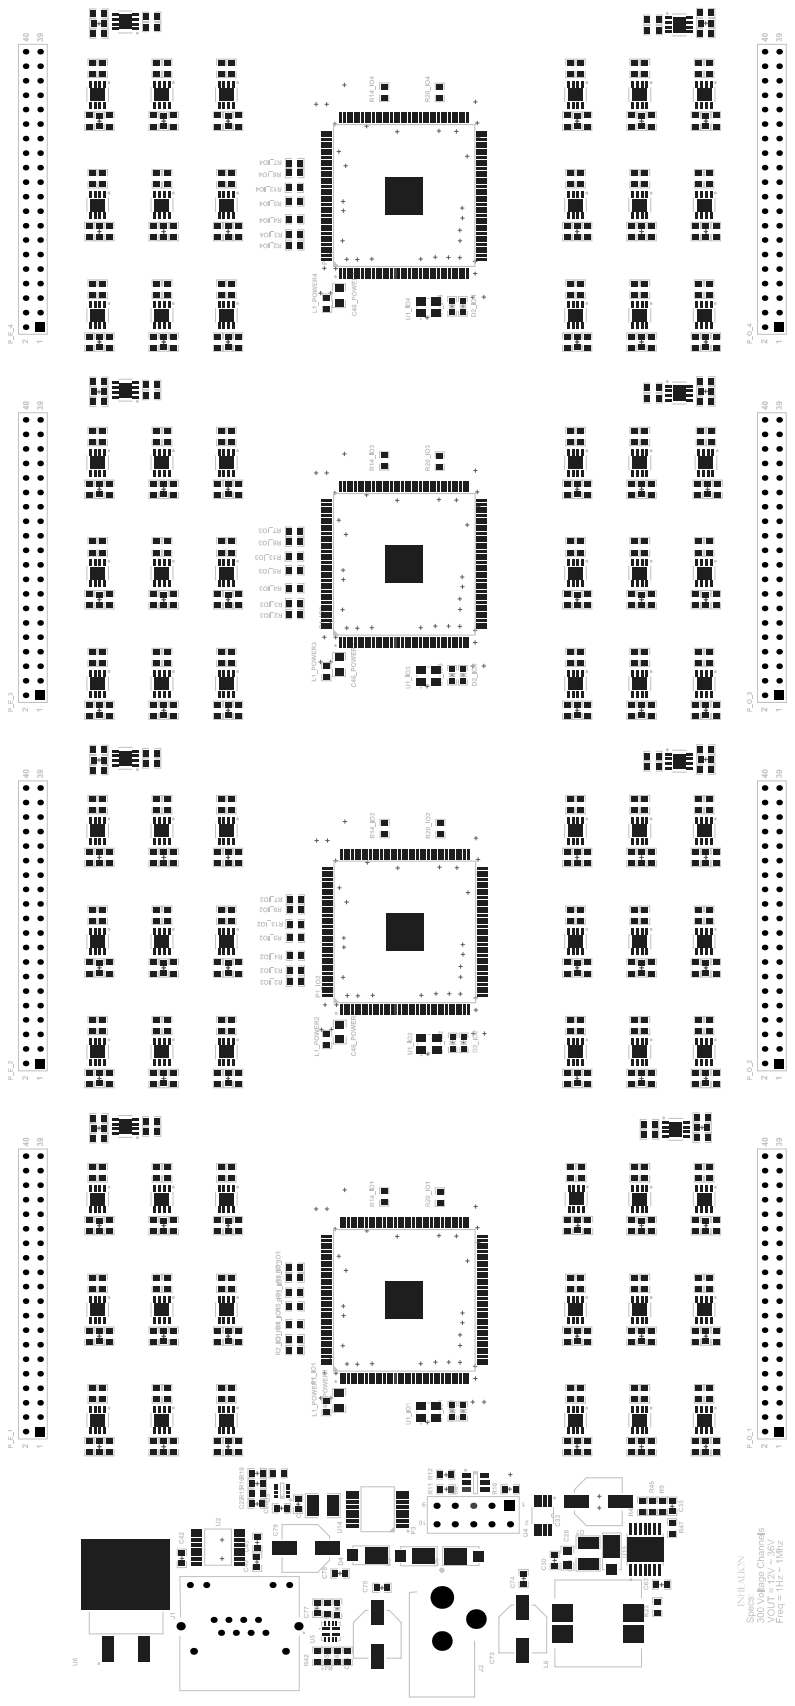
[picture p48: page 1]

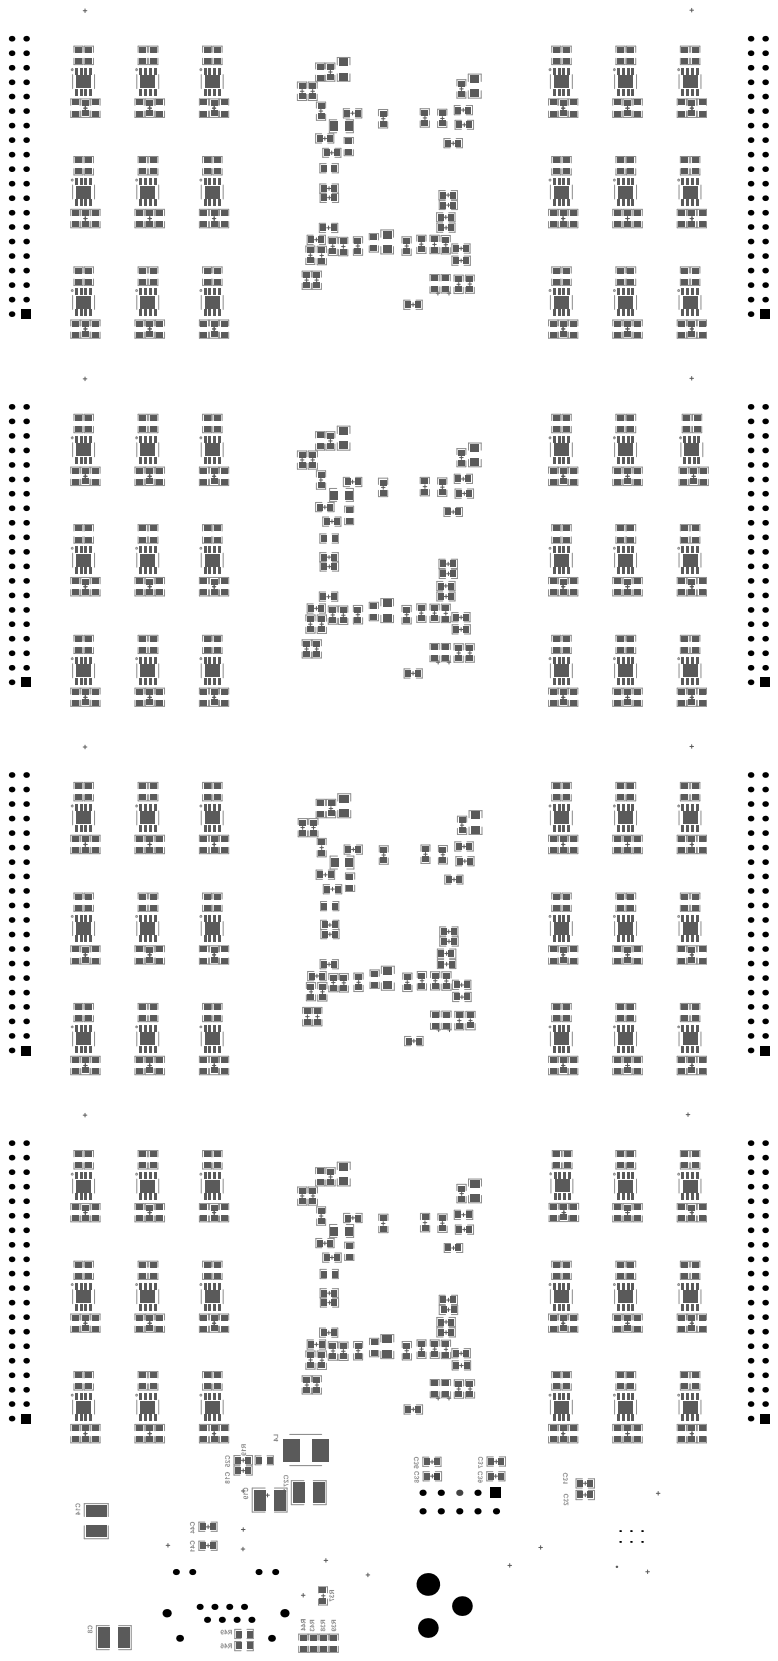
[picture p49: page 2]
