haseebulhassan/Project-C/(list of files, drawings)

Other design files:
Project-C/Project-C_Controller/BOARD_CONNECTOR.SchDoc
Project-C/Project-C_Controller/BOARD_CONNECTOR_1x.SchDoc
Project-C/Project-C_Controller/FTDI2.SchDoc
Project-C/Project-C_Controller/FTDI.SchDoc
Project-C/Project-C_Controller/LCD.SchDoc
Project-C/Project-C_Controller/POWER.SchDoc
Project-C/Project-C_Controller/POWER_CONTROLLER2.SchDoc
Project-C/Project-C_Controller/POWER_CONTROLLER3.SchDoc
Project-C/Project-C_Controller/POWER_CONTROLLER.SchDoc
Project-C/Project-C_Controller/Project-C_CONTOLLER.PrjPCB
Project-C/Project-C_Controller/RTC.SchDoc
Project-C/Project-C_Controller/Schlib1.SchLib
Project-C/Project-C_Controller/SDCARD_FLASH.SchDoc
Project-C/Project-C_Controller/STM32.SchDoc
Project-C/Project-C_Controller/TOP.SchDoc
Project-C/Project-C_Controller/TOP_CONTROLLER.SchDoc
Project-C/Project-C_Controller/WIFI.SchDoc
Project-C/Project-C_LED/10m04sc.olb
Project-C/Project-C_LED/FPGA.SchDoc
Project-C/Project-C_LED/FPGA_CONFIG.SchDoc
Project-C/Project-C_LED/FPGA_Decouple.SchDoc
Project-C/Project-C_LED/FPGA_IO.SchDoc
Project-C/Project-C_LED/FPGA_POWER.SchDoc
Project-C/Project-C_LED/Imported Libraries.PrjPcb/10m04sc_Library.SchLib
Project-C/Project-C_LED/Imported Libraries.PrjPcb/Libraries.PrjPcb
Project-C/Project-C_LED/LED_BUFFER.SchDoc
Project-C/Project-C_LED/LED_BUFFER_1xFPGA.SchDoc
Project-C/Project-C_LED/MAX10.SchDoc
Project-C/Project-C_LED/Power.SchDoc
Project-C/Project-C_LED/Power_ORing.SchDoc
Project-C/Project-C_LED/POWER_VOLTAGE.SchDoc
Project-C/Project-C_LED/ProjCLib.PcbLib
Project-C/Project-C_LED/Project-C_LED.PrjPCB
Project-C/Project-C_LED/Schlib1.SchLib
Project-C/Project-C_LED/TOP_LED.SchDoc
Project-C/Project-C_Voltage/FPGA_IO.SchDoc
Project-C/Project-C_Voltage/FPGA_POWER.SchDoc
Project-C/Project-C_Voltage/MAX10.SchDoc
Project-C/Project-C_Voltage/Power_ORing.SchDoc
Project-C/Project-C_Voltage/POWER_VOLTAGE.SchDoc
Project-C/Project-C_Voltage/ProjCLib.PcbLib
Project-C/Project-C_Voltage/Project-C_VOLTAGE.PrjPCB
Project-C/Project-C_Voltage/Schlib1.SchLib
Project-C/Project-C_Voltage/TOP_VOLTAGE.SchDoc
Project-C/Project-C_Voltage/VoltageAmplifier.SchDoc
Project-C/Project-C_Voltage/VoltageAmplifier_1xFPGA.SchDoc
Project-C/Project-C_Voltage/VoltageHeaders.SchDoc
