haseebulhassan/Project-C/Project-C/Project-C_LED/Datasheet/LCD/ER-TFTM035-6(4-wire-spi)_RTP_SD_FONT_FLASH/ER-TFTM035-6(4-wire-spi)_RTP_SD_FONT_FLASH/9488TP.h

//=============================================================
//Define lcd io
sbit CS=P1^0;		//chip select when low
sbit SCL=P1^1;		//SERIAL CLOCK INPUT 
sbit RS=P1^2;		//high :data  low:command     
sbit SDA=P1^5;	     //SERIAL DATA INPUT/OUTPUT 
 
sbit RES=P3^7;		//reset
sbit BL_ON=P3^0;    //Blacklight Control     H:ON   L:OFF


//define key
sbit KEY = P3^3;
//====================================================//


void ILI9488_Initial(void);
void Write_Cmd_Data(unsigned char x);
void Write_Cmd(unsigned char DL);
void Write_Data(unsigned char DH,unsigned char DL);
void delayms(unsigned int tt);
void  Write_Data_U16(unsigned int y);
void LCD_SetPos(unsigned int xs,unsigned int xe,unsigned int ys,unsigned int ye);
void ClearScreen(unsigned int bColor);
void LCD_FULL(unsigned int i);


unsigned int code pic[];

//===============================================================
// all display one colour
void ClearScreen(unsigned int bColor)
{
 unsigned int i,j;
 LCD_SetPos(0,319,0,479);
 for (i=0;i<320;i++)
	{
	
	   for (j=0;j<480;j++)
	       Write_Data_U16(bColor);
	}
}


//===================================================================
//write data byte

void Write_Data(unsigned char DH,unsigned char DL)
{unsigned char R1,G1,B1,i; unsigned int LD=0;

// RGB565 TO RGB666
   LD=DH<<8;
   LD|=DL;

	 R1=(0x1f&(LD>>11))*2; R1<<=2;
	G1=0x3f&(LD>>5);   		G1<<=2;
	B1=	(0x1f&LD)*2; 	B1<<=2;
		 
    CS=0;
   	RS=1;
    for(i=0;i<8;i++)
     {  SCL=0;
        if(R1&0x80) SDA=1;
       	else SDA=0;
       	SCL=1;
        R1=R1<<1;
     }

     for(i=0;i<8;i++)
     {  SCL=0;
        if(G1&0x80) SDA=1;
       	else SDA=0;
       	SCL=1;
        G1=G1<<1;
     }

     for(i=0;i<8;i++)
     {  SCL=0;
        if(B1&0x80) SDA=1;
       	else SDA=0;
       	SCL=1;
        B1=B1<<1;
     }

   	CS=1;

}


//==============================================================
//write  data word
void  Write_Data_U16(unsigned int y)
{
	unsigned char m,n;
	m=y>>8;
	n=y;
	Write_Data(m,n);

}
//=============================================================
//write command

void Write_Cmd(unsigned char CMD)
{ unsigned char i;
 	 
    CS=0;
   	RS=0;
    for(i=0;i<8;i++)
     {  SCL=0;
        if(CMD&0x80) SDA=1;
       	else SDA=0;
       	SCL=1;
        CMD=CMD<<1;
     }
   	CS=1;


}

//===============================================================
//write parameter
void  Write_Cmd_Data (unsigned char CMDP)
{ unsigned char i;
 	 
    CS=0;
   	RS=1;
    for(i=0;i<8;i++)
     {  SCL=0;
        if(CMDP&0x80) SDA=1;
       	else SDA=0;
       	SCL=1;
        CMDP=CMDP<<1;
     }
   	CS=1;

}



//============================================================
//delay 
void delayms(unsigned int count)
{
    int i,j;                                                                                
    for(i=0;i<count;i++)                                                                    
       {
	     for(j=0;j<1000;j++);
       }                                                                                     
}


//============================================================
//show gray

void DispRGBGray(void)
{  


	unsigned int COL=320;
	unsigned char i,j,k,dbl,dbh;
	
	LCD_SetPos(0,319,0,479);

	// balck -> red	
	for(k=0;k<80;k++)
	{
		for(i=0;i<32;i++)
		{
			for(j=0;j<10;j++)
			{
				dbh=i<<3;
				dbl=0;
			Write_Data(dbh,dbl);
			}
		}
	}

	// red -> black
	for(k=0;k<80;k++)
	{	

		for(i=31;i>0;i--)
		{
			for(j=0;j<10;j++)
			{
				dbh=i<<3;
				dbl=0;
			Write_Data(dbh,dbl);
			}
		}
		
		dbh=0x00;dbl=0x00;
		for(i=0;i<10;i++)
		Write_Data(dbh,dbl);
		

	}
	// balck -> green
	for(k=0;k<80;k++)
	{

		for(i=0;i<64;i+=2)
		{
			for(j=0;j<10;j++)
			{
				dbh=i>>3;
				dbl=i<<5;
			Write_Data(dbh,dbl);
			}
		}
	}

	// green -> black
	for(k=0;k<80;k++)
	{
		for(i=63;i!=1;i-=2)
		{
			for(j=0;j<10;j++)
			{
				dbh=i>>3;
				dbl=i<<5;
			Write_Data(dbh,dbl);
			}
		}
		dbh=0x00;dbl=0x00;
		for(i=0;i<10;i++)
		Write_Data(dbh,dbl);
	}	


	// balck -> blue
	for(k=0;k<80;k++)
	{
		for(i=0;i<32;i++)
		{
			for(j=0;j<10;j++)
			{
				dbh=0;
				dbl=i;
			Write_Data(dbh,dbl);
			}
		}
	}

	// blue -> black
	for(k=0;k<80;k++)
	{	

		for(i=31;i>0;i--)
		{
			for(j=0;j<10;j++)
			{
				dbh=0;
				dbl=i;
			Write_Data(dbh,dbl);
			}
		}
		dbh=0x00;dbl=0x00;
		for(i=0;i<10;i++)
		Write_Data(dbh,dbl);
	}


}




//============================================================
//show Box

void LCD_FULL(unsigned int i)
{
    unsigned int w,u;
 LCD_SetPos(0,319,0,479);

	    for(w=0;w<320;w++)
		{    
          	Write_Data_U16(~i);

		}

  	for(w=0;w<478;w++)		    
        {  	Write_Data_U16(~i);
	    	
			for(u=0;u<318;u++)
         	Write_Data_U16(i);

          	Write_Data_U16(~i);		
		}

	    for(w=0;w<320;w++)
		{    
          	Write_Data_U16(~i);

		}	
	
}


//============================================================
//show picture
void show_picture(void)
{
	unsigned char i,j;
	unsigned int m=0,n=0,k=0;
 LCD_SetPos(0,319,0,479);
	for(j=0;j<160;j++)
	{
        for(i=0;i<120;i++)
		{
            Write_Data_U16(pic[m++]);
	    }
		for(i=0;i<120;i++)
		{
            Write_Data_U16(pic[n++]);
	    }
		for(i=0;i<80;i++)
		{
            Write_Data_U16(pic[k++]);
	    }
		k+=40;

	}

   	m=0;
   	n=0;
	k=0;
	for(j=0;j<160;j++)
	{
        for(i=0;i<120;i++)
		{
            Write_Data_U16(pic[m++]);
	    }
		for(i=0;i<120;i++)
		{
            Write_Data_U16(pic[n++]);
	    }
		for(i=0;i<80;i++)
		{
            Write_Data_U16(pic[k++]);
	    }
		k+=40;
	}

   	m=0;
   	n=0;
	k=0;
	for(j=0;j<160;j++)
	{
        for(i=0;i<120;i++)
		{
            Write_Data_U16(pic[m++]);
	    }
		for(i=0;i<120;i++)
		{
            Write_Data_U16(pic[n++]);
	    }
		for(i=0;i<80;i++)
		{
            Write_Data_U16(pic[k++]);
	    }
		k+=40;
	}
	


    return;
}



//=============================================================
//lcd initial

void ili9488_Initial(void)
{ 
	 RES=1;
	 delayms(5);
	 RES=0;
	 delayms(10);
	 RES=1;
 	 delayms(120);   


 	Write_Cmd(0xE0);
	Write_Cmd_Data(0x00);
	Write_Cmd_Data(0x03);
	Write_Cmd_Data(0x09);
	Write_Cmd_Data(0x08);
	Write_Cmd_Data(0x16);
	Write_Cmd_Data(0x0A);
	Write_Cmd_Data(0x3F);
	Write_Cmd_Data(0x78);
	Write_Cmd_Data(0x4C);
	Write_Cmd_Data(0x09);
	Write_Cmd_Data(0x0A);
	Write_Cmd_Data(0x08);
	Write_Cmd_Data(0x16);
	Write_Cmd_Data(0x1A);
	Write_Cmd_Data(0x0F);
	

	Write_Cmd(0XE1);
	Write_Cmd_Data(0x00);
	Write_Cmd_Data(0x16);
	Write_Cmd_Data(0x19);
	Write_Cmd_Data(0x03);
	Write_Cmd_Data(0x0F);
	Write_Cmd_Data(0x05);
	Write_Cmd_Data(0x32);
	Write_Cmd_Data(0x45);
	Write_Cmd_Data(0x46);
	Write_Cmd_Data(0x04);
	Write_Cmd_Data(0x0E);
	Write_Cmd_Data(0x0D);
	Write_Cmd_Data(0x35);
	Write_Cmd_Data(0x37);
	Write_Cmd_Data(0x0F);
	
	
	 
	Write_Cmd(0XC0);      //Power Control 1 
	Write_Cmd_Data(0x17);    //Vreg1out 
	Write_Cmd_Data(0x15);    //Verg2out 
	 
	Write_Cmd(0xC1);      //Power Control 2     
	Write_Cmd_Data(0x41);    //VGH,VGL 
	 
	Write_Cmd(0xC5);      //Power Control 3 
	Write_Cmd_Data(0x00); 
	Write_Cmd_Data(0x12);    //Vcom 
	Write_Cmd_Data(0x80);
	 
	Write_Cmd(0x36);      //Memory Access 
	Write_Cmd_Data(0x48); 
	 
	Write_Cmd(0x3A);      // Interface Pixel Format 
	Write_Cmd_Data(0x66); 	  //18 bit    
	 
	Write_Cmd(0XB0);      // Interface Mode Control 
	Write_Cmd_Data(0x80);     			 //SDO NOT USE
	 
	Write_Cmd(0xB1);      //Frame rate 
	Write_Cmd_Data(0xA0);    //60Hz 
	 
	Write_Cmd(0xB4);      //Display Inversion Control 
	Write_Cmd_Data(0x02);    //2-dot 
	 
	Write_Cmd(0XB6);      //Display Function Control  RGB/MCU Interface Control 
	
	Write_Cmd_Data(0x02);    //MCU 
	Write_Cmd_Data(0x02);    //Source,Gate scan dieection 
	  
	Write_Cmd(0XE9);      // Set Image Functio
	Write_Cmd_Data(0x00);    // Disable 24 bit data
	 
	Write_Cmd(0xF7);      // Adjust Control 
	Write_Cmd_Data(0xA9);     
	Write_Cmd_Data(0x51);     
	Write_Cmd_Data(0x2C);     
	Write_Cmd_Data(0x82);    // D7 stream, loose 

	Write_Cmd(0x11); //Sleep out
	delayms(120);
	Write_Cmd(0x29);






	}

	
void ILI9488_EnterSleep_Code(void)
{
	Write_Cmd(0x28); //Display off
	delayms(10);
	Write_Cmd(0x10); // Internal oscillator will be stopped
	delayms(120);
}
void ILI9488_ExitSleep_Code(void)
{
	Write_Cmd(0x11); // Sleep out
	delayms(120);
	Write_Cmd(0x29); //Display on
}



//===============================================================
//定义坐标

void LCD_SetPos(unsigned int xs,unsigned int xe,unsigned int ys,unsigned int ye)
{

    Write_Cmd(0x2A);
	Write_Cmd_Data(xs>>8);
	Write_Cmd_Data(xs&0xff);
	Write_Cmd_Data(xe>>8);
	Write_Cmd_Data(xe&0xff);
	Write_Cmd(0x2B);
	Write_Cmd_Data(ys>>8);
	Write_Cmd_Data(ys&0xff);
	Write_Cmd_Data(ye>>8);
	Write_Cmd_Data(ye&0xff);

    Write_Cmd(0x2C);
}

 unsigned int code pic[]=
{
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

};
