haseebulhassan/Project-C/(commit log)

2020-12-20 Multiboard Project Added
    [10m04sc.olb, 10m04sc.xls, 10m04sc_Library.SchLib, BOARD_CONNECTOR.SchDoc, FPGA.SchDoc, FPGA_CONFIG.SchDoc, FPGA_IO.SchDoc, FPGA_POWER.SchDoc]
2020-12-20 Voltage BOM Completed
    [FPGA_CONFIG.SchDoc, FPGA_IO.SchDoc, FPGA_POWER.SchDoc, POWER_VOLTAGE.SchDoc, Project-C_VOLTAGE.PrjPCB, Project-C_VOLTAGE.xls, TOP_CONTROLLER.SchDoc, TOP_VOLTAGE.SchDoc]
2020-12-20 Controller BOM Draft complete
    [BOARD_CONNECTOR.SchDoc, FTDI.SchDoc, LCD.SchDoc, LED_BUFFER.SchDoc, POWER_CONTROLLER.SchDoc, Project-C_CONTOLLER.PrjPCB, RTC.SchDoc, SDCARD_FLASH.SchDoc]
2020-12-22 Added RJ45 and RS232 Protocol
    [FPGA_CONFIG.SchDoc, FPGA_IO.SchDoc, MAX10.SchDoc, POWER_VOLTAGE.SchDoc, Schlib1.SchLib, TOP_CONTROLLER.SchDoc, TOP_VOLTAGE.SchDoc, VoltageHeaders.SchDoc]
2020-12-25 ID RESISTORS ADDED
    [FPGA_IO.SchDoc, MAX10.SchDoc, Project-C_VOLTAGE.PrjPCB, TOP_VOLTAGE.SchDoc]
2020-12-25 PDF FILES ADDED
    [Project-C_CONTOLLER.PrjPCB]
2020-12-29 FPGA modified in Hierarchy
    [FPGA_CONFIG.SchDoc, FPGA_IO.SchDoc, FPGA_POWER.SchDoc, MAX10.SchDoc, POWER_VOLTAGE.SchDoc, ProjCLib.PcbLib, Project-C_VOLTAGE.PrjPCB, TOP_VOLTAGE.SchDoc]
2020-12-29 Footprints added. PCB Updated
    [FPGA_POWER.SchDoc, TOP_VOLTAGE.SchDoc]
2020-12-30 CHANGES in Project-Voltage. Power ORING scheme added.
    [FPGA_IO.SchDoc, FPGA_POWER.SchDoc, POWER_VOLTAGE.SchDoc, Power_ORing.SchDoc, Project-C_VOLTAGE.PrjPCB, Schlib1.SchLib, TOP_VOLTAGE.SchDoc]
2020-12-30 PCB Update
    [FPGA_IO.SchDoc, POWER_VOLTAGE.SchDoc, TOP_VOLTAGE.SchDoc]
2020-12-30 FPGA Caps 22uF/25V changed to 22uF/10V. PCB Updated.
    [FPGA_POWER.SchDoc, POWER_VOLTAGE.SchDoc, Project-C_VOLTAGE.PrjPCB]
2020-12-30 PROJECT LED ADDED
    [10m04sc.olb, 10m04sc.xls, 10m04sc_Library.SchLib, FPGA.SchDoc, FPGA_CONFIG.SchDoc, FPGA_Decouple.SchDoc, FPGA_IO.SchDoc, LED_BUFFER.SchDoc]
2020-12-30 Project-Voltage resistor values changed
    [POWER_VOLTAGE.SchDoc, Project-C_VOLTAGE.PrjPCB, TOP_VOLTAGE.SchDoc, VOLTAGE_TOP.SchDoc]
2020-12-30 Controller PCB modified for review
    [BOARD_CONNECTOR.SchDoc, FTDI.SchDoc, LCD.SchDoc, POWER_CONTROLLER.SchDoc, Project-C_CONTOLLER.PrjPCB, STM32.SchDoc, TOP_CONTROLLER.SchDoc]
2021-01-03 PCB Placement done
    [FPGA_IO.SchDoc, FPGA_POWER.SchDoc, POWER_VOLTAGE.SchDoc, Power_ORing.SchDoc, ProjCLib.PcbLib, Project-C_VOLTAGE.PrjPCB, TOP_VOLTAGE.SchDoc]
2021-01-04 PCB Updated recheck
2021-01-04 LED_BUFFER.SchDoc design calculations added
    [LED_BUFFER.SchDoc]
2021-01-04 PCB PLACEMENT
2021-01-04 Issue of same nets of 4x FPGAs in Schematic resolved
    [TOP_VOLTAGE.SchDoc]
2021-01-05 PCB UPDATED. SCHEMATIC VOLTAGE AMPLIFIER NETS NOT CONNECTED TO FPGA IOS
2021-01-05 Connectivity Issues with Repeat Blocks resolved. 3V3 LDO added.
    [POWER_VOLTAGE.SchDoc, TOP_VOLTAGE.SchDoc]
2021-01-05 VOUT scheme changed.
    [Project-C_VOLTAGE.PrjPCB, TOP_VOLTAGE.SchDoc, VoltageHeaders.SchDoc]
2021-01-07 Design Review LEDs
    [LED_BUFFER.SchDoc]
2021-01-07 FTDI IMPROVED
    [FTDI.SchDoc]
2021-01-07 PCB UPDATED. 75 CH PLACED
2021-01-07 Scheme for Voltage Amplifiers Changed
    [Project-C_VOLTAGE.PrjPCB, TOP_VOLTAGE.SchDoc, VoltageAmplifier.SchDoc, VoltageAmplifier_1xFPGA.SchDoc, VoltageHeaders.SchDoc]
2021-01-10 PCB routing almost complete. FPGA Power planes problem needs to be solved. VCC3P3 on JTAG Pull up problem
    [FPGA_IO.SchDoc, FPGA_POWER.SchDoc, POWER_VOLTAGE.SchDoc, ProjCLib.PcbLib, Project-C_VOLTAGE.PrjPCB, VoltageAmplifier_1xFPGA.SchDoc, VoltageHeaders.SchDoc]
2021-01-10 PROJECT C VOLTAGE UPDATES
    Routing
    PCB Routing completed
    NO DRC
    Designators need to be managed, PCB needs to be verified, Manf notes to be added, footprints verification needed.
    Correction in Schematics:
    VCC3P3 to VCC_3V3 of JTAG Pull up
    VCC_FPGA net added instead of VCCIO, VCCA, VCC_ONE, making routing simpler
    IDs of FPGA pulled up by VCC_FPGA instead of VCCIO
    Nets added to headers
    Header pitch to 2mm, hole size 0.85mm
    Verification of Schematics required
    [FPGA_IO.SchDoc, FPGA_POWER.SchDoc, MAX10.SchDoc, TOP_VOLTAGE.SchDoc]
2021-01-12 Voltage PCB Mounting Holes added.
    LED PCB2
    PCB Placement
    Schematics adjusted to match Voltage Schematics
    [FPGA_Decouple.SchDoc, FPGA_IO.SchDoc, LED_BUFFER.SchDoc, MAX10.SchDoc, Power_ORing.SchDoc, Project-C_LED.PrjPCB, TOP_LED.SchDoc]
2021-01-12 Design Review LED Buffer
    [LED_BUFFER.SchDoc, TOP_LED.SchDoc]
2021-01-12 Top Scheme added
    [LED_BUFFER_1xFPGA.SchDoc, Power.SchDoc, Project-C_LED.PrjPCB, TOP_LED.SchDoc]
2021-01-13 Size Tweaking in Voltage PCB
    Updates in LED PCB
    [FPGA_POWER.SchDoc, POWER_VOLTAGE.SchDoc]
2021-01-14 Voltage PCB Gerbers Generated
    [BOM.xls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]
2021-01-14 Project LED 24 out of 75 LEDs routed.
    [LED_BUFFER.SchDoc, MAX10.SchDoc, Power.SchDoc, ProjCLib.PcbLib, Project-C_LED.PrjPCB]
2021-01-15 Rerouting of LED PCB
    24 routing completed
    [Project-C_LED.PrjPCB]
2021-01-16 ONE FPGA Completely routed.
    [FPGA_IO.SchDoc]
2021-01-16 Controller Updated
    [BOARD_CONNECTOR.SchDoc, BOARD_CONNECTOR_1x.SchDoc, BOM_PCBWAY.xls, FTDI.SchDoc, POWER_CONTROLLER.SchDoc, Project-C_CONTOLLER.PrjPCB, SDCARD_FLASH.SchDoc, STM32.SchDoc]
2021-01-16 Project C LED routed completely Changes done schematic FPGA IO for better IO placement Size of the PCB is the same as before. Review of PCB routing is required Designators not properly placed
    Last IC of LED Buffer in hierarchy has 05 inputs unuseable. But the components of those 05 inputs are still present in PCB. Hence these components are deleted manually and DRC is cleared. Please review that too.
    [Project-C_LED.PrjPCB, TOP_LED.SchDoc]
2021-01-17 Controller Project Footprints and Designators updated.
    [BOARD_CONNECTOR.SchDoc, FTDI.SchDoc, LCD.SchDoc, POWER.SchDoc, POWER_CONTROLLER.SchDoc, Project-C_CONTOLLER.PrjPCB, RTC.SchDoc, SDCARD_FLASH.SchDoc]
2021-01-17 VOLTAGE PCB UPDATED
    Ethernet connector footprint updated.
2021-01-20 Footprints updated.
    [BOARD_CONNECTOR.SchDoc, BOARD_CONNECTOR_1x.SchDoc, FTDI.SchDoc, FTDI2.SchDoc, LCD.SchDoc, POWER_CONTROLLER.SchDoc, POWER_CONTROLLER2.SchDoc, POWER_CONTROLLER3.SchDoc]
2021-01-21 Project C Controller
    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
    [BOARD_CONNECTOR.SchDoc, POWER_CONTROLLER.SchDoc, ProjCLib.PcbLib, Project-C_CONTOLLER.PrjPCB, STM32.SchDoc]
2021-01-22 PCB Routing in process
    [BOARD_CONNECTOR.SchDoc, LCD.SchDoc, POWER_CONTROLLER.SchDoc, Schlib1.SchLib, TOP_CONTROLLER.SchDoc]
2021-01-22 COMMAND RX ISSUE RESOLVED
    [BOARD_CONNECTOR.SchDoc, BOARD_CONNECTOR_1x.SchDoc, Project-C_CONTOLLER.PrjPCB, STM32.SchDoc]
2021-01-22 Crystal OSC added
    [LCD.SchDoc, POWER_CONTROLLER.SchDoc, STM32.SchDoc]
2021-01-22 Controller PCB routing completed.
    [POWER_CONTROLLER.SchDoc, Project-C_CONTOLLER.PrjPCB, STM32.SchDoc]
2021-01-23 New PCB Placement for Controller
    [BOARD_CONNECTOR.SchDoc, BOARD_CONNECTOR_1x.SchDoc, LCD.SchDoc, POWER_CONTROLLER.SchDoc, Project-C_CONTOLLER.PrjPCB, RTC.SchDoc, SDCARD_FLASH.SchDoc, STM32.SchDoc]
2021-01-23 VOLTAGE REVIEWED
    [Assembly Testpoint Report for PCB2.csv, BOM.xls, FPGA_IO.SchDoc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]
2021-01-23 LED REVIEWED
    [Assembly Testpoint Report for PCB5.csv, FPGA_IO.SchDoc, LED_BUFFER.SchDoc, LED_BUFFER_1xFPGA.SchDoc, MAX10.SchDoc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]
2021-01-23 Controller BOM Added
    [BOARD_CONNECTOR_1x.SchDoc, FTDI.SchDoc, LCD.SchDoc, POWER_CONTROLLER.SchDoc, Project-C_CONTOLLER_BOM.xls, SDCARD_FLASH.SchDoc, STM32.SchDoc, WIFI.SchDoc]
2021-01-24 SWITCH ADDED IN CONTROLLER PCB
    [BOARD_CONNECTOR_1x.SchDoc, POWER_CONTROLLER.SchDoc]
2021-01-25 Controller PCB
    Routing completed
    [Project-C_CONTOLLER.PrjPCB, RTC.SchDoc]
2021-03-05 PCBWAY ORDER
    [Pick Place for PCB4.csv, Project-C_CONTOLLER.PrjPCB, Project-C_VOLTAGE.PrjPCB]
